Pai-88/crank-charger/video/COMMENTARY.md

# Commentary for the showcase cut (31 s: act 1 is 19 s, act 2 is 12 s)

Paste the lines into Higgsfield (Speak, or its voice-over tool) one at a time, or all seven as one
take, and drop the audio on A1 in Resolve. The times are where each line should START on the
"Showcase 9x16" timeline (act 1 `crank_9x16.mp4`, then act 2 `crank_elec9x16.mp4` from 19.0 s).
Everything spoken here is a design fact. No power, speed or "it works" number goes in until it has
been measured on the real machine (that is the 25 Oct film).

| start | what is on screen | line |
|---|---|---|
| 0.0 s | the machine turning, camera circling | A hand crank phone charger. Every plastic part is printed, the gearbox in one piece. |
| 7.5 s | parts fly apart | Inside: a planetary stage. Seventeen, thirty-seven and ninety-one teeth, five point three to one. |
| 12.0 s | exploded, camera circling | Three planets on steel pins, one sun on the motor shaft. The motor is a stepper, run backwards as a generator. |
| 19.0 s | the card floats out behind the machine | Behind the wall: eight Schottky diodes in two bridges turn the stepper's output into DC, and one capacitor smooths it. |
| 23.5 s | the module and the USB tester in their sled | A buck converter brings it down to USB five volts, with a plug-in meter to show what the phone gets. |
| 27.5 s | cover on, phone charging | Cover on, phone on. Turn the wheel. |

Word count 93: about 3.0 words a second, a calm narrator's pace. If the voice runs long, cut the
third line to "Three planets, one sun, a stepper run backwards as a generator." and the fourth to
"Behind the wall: eight Schottky diodes and one capacitor make DC."

## One take, plain text

A hand crank phone charger. Every plastic part is printed, the gearbox in one piece.
Inside: a planetary stage. Seventeen, thirty-seven and ninety-one teeth, five point three to one.
Three planets on steel pins, one sun on the motor shaft. The motor is a stepper, run backwards as a generator.
Behind the wall: eight Schottky diodes in two bridges turn the stepper's output into DC, and one capacitor smooths it.
A buck converter brings it down to USB five volts, with a plug-in meter to show what the phone gets.
Cover on, phone on. Turn the wheel.

## If the cut gets longer (real footage added in Resolve)

- Over the printed parts on the bench: "Eight parts, two days of printing on a P1S."
- Over the first crank test, ONLY after the meter has been read on camera: "<measured> volts at <measured> turns a minute."
- Over the phone: "The converter turns that into USB five volts."

## Not to say

- Any watts, volts or rpm figure that has not been read off the meter on camera.
- "Works", "charges in X minutes", "tested": not until the exit test on 25 Oct passes.
