Pai-88/crank-charger/electronics/card_template.pdf

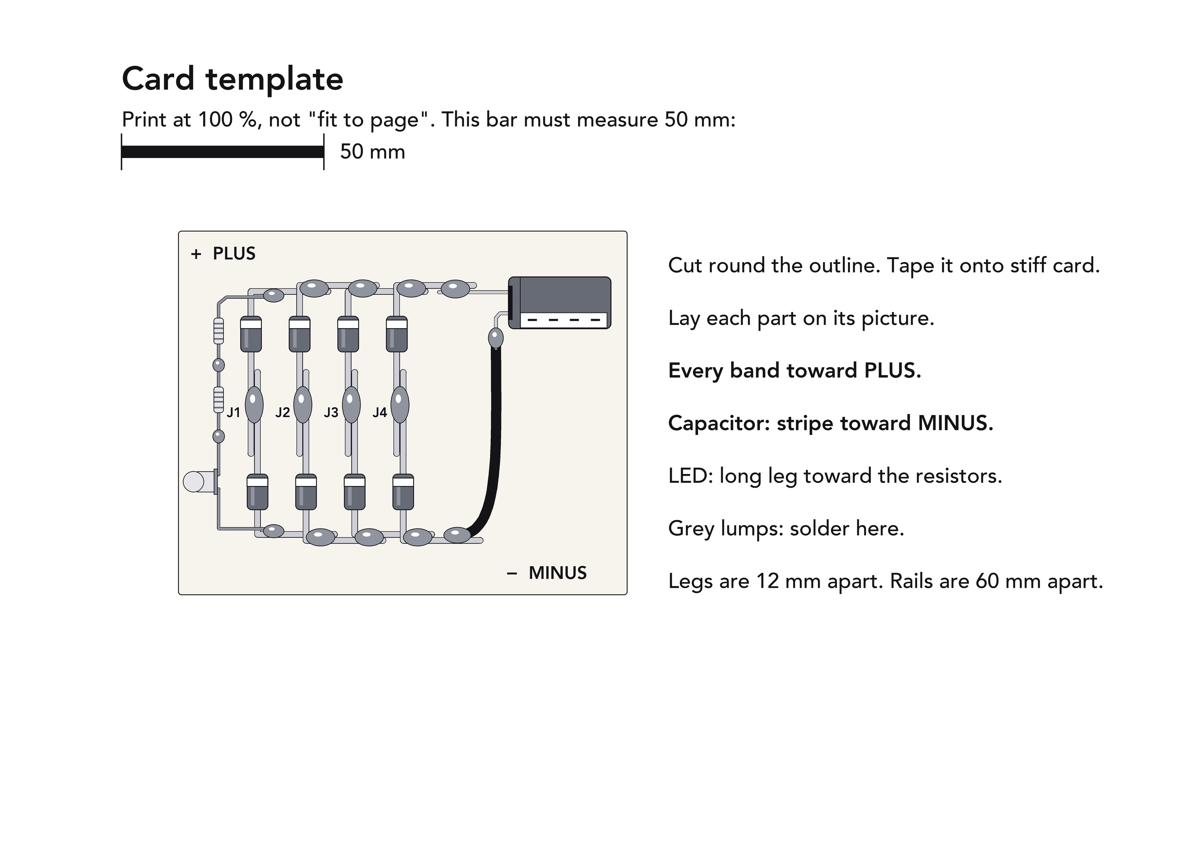
[picture p26: page 1]
