Pai-88/crank-charger/cad/preview_batch2.png

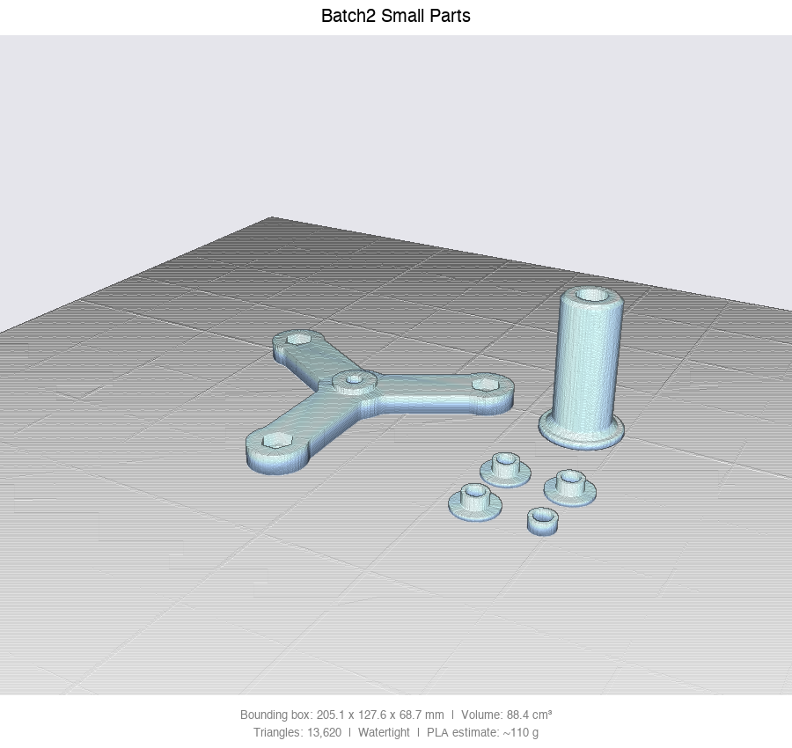
cad/preview_batch2.png
