Pai-88/crank-charger/cad/preview_coupon.png

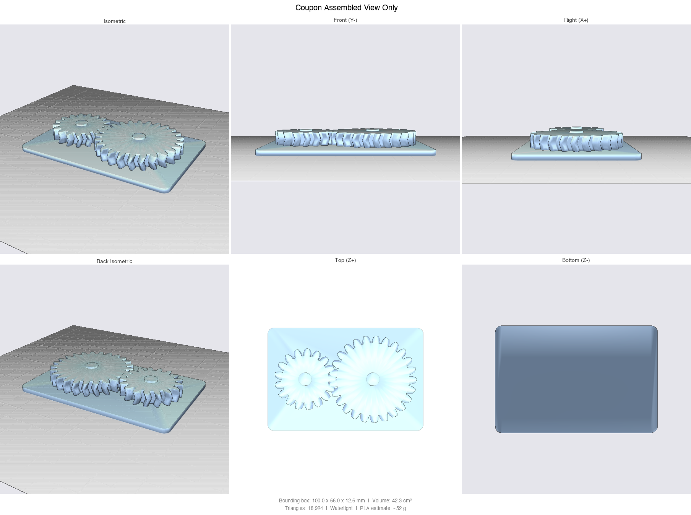
cad/preview_coupon.png
