Pai-88/crank-charger/cad/preview_frame.png

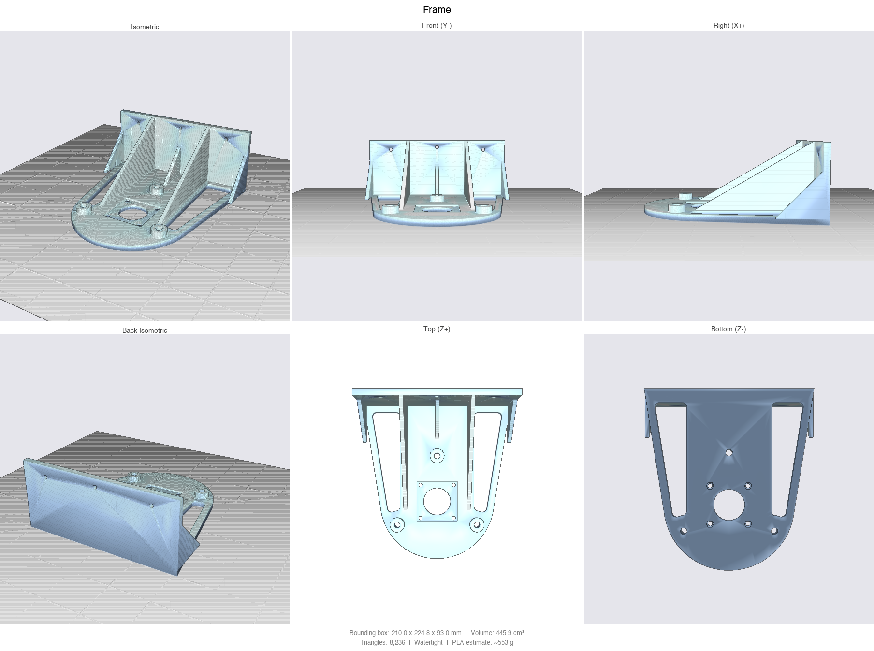
cad/preview_frame.png
