Pai-88/crank-charger/cad/preview_grip.png

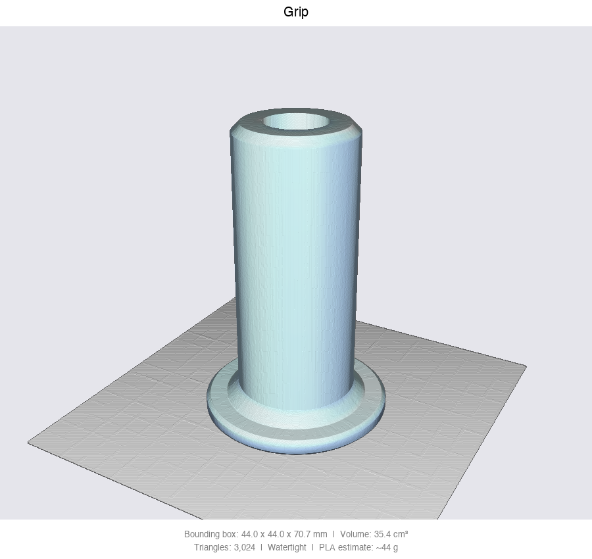
cad/preview_grip.png
