Pai-88/crank-charger/cad/preview_inner.png

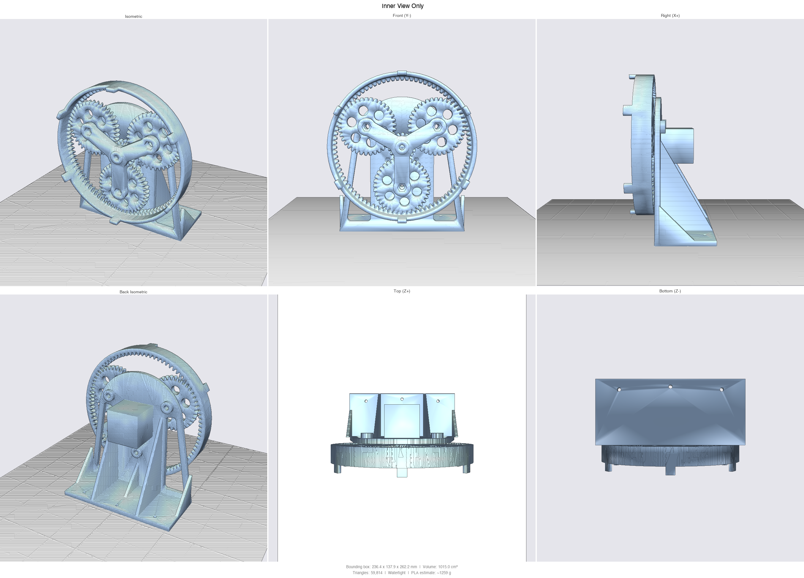
cad/preview_inner.png
