Pai-88/crank-charger/cad/preview_plate1.png

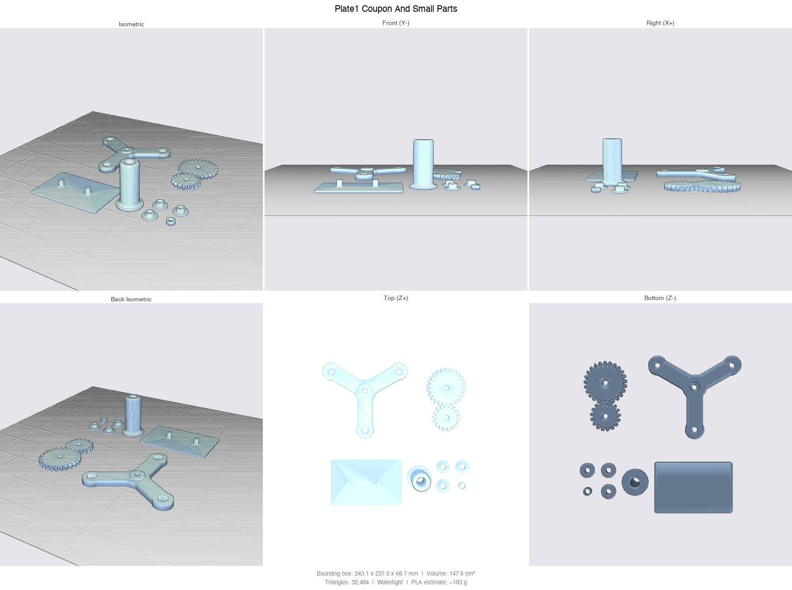
cad/preview_plate1.png
