Pai-88/crank-charger/cad/stl/spares/bayonet_1.png

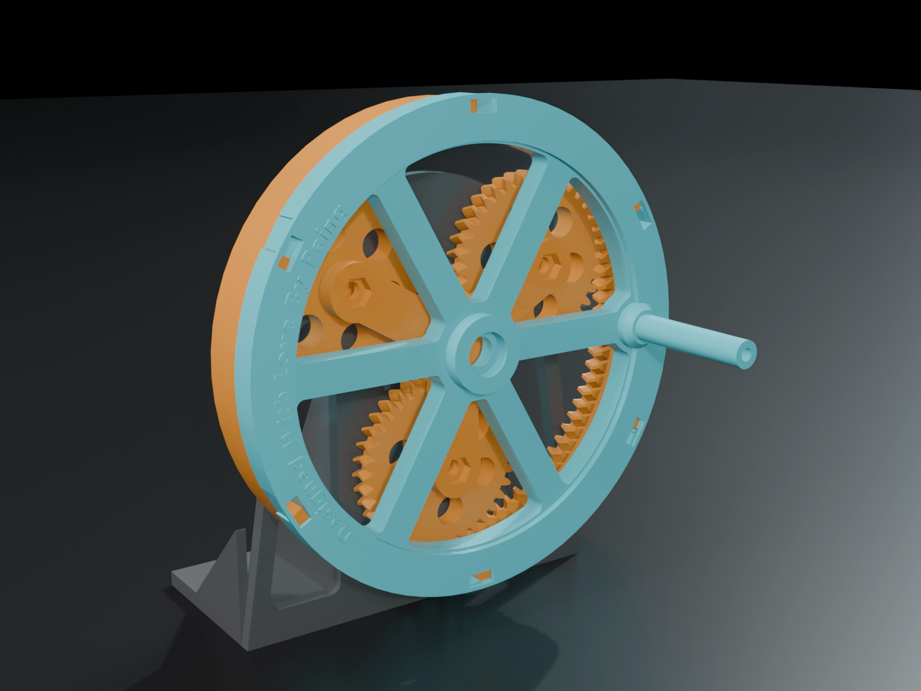
cad/stl/spares/bayonet_1.png
