Pai-88/crank-charger/cad/stl/spares/bayonet_2.png

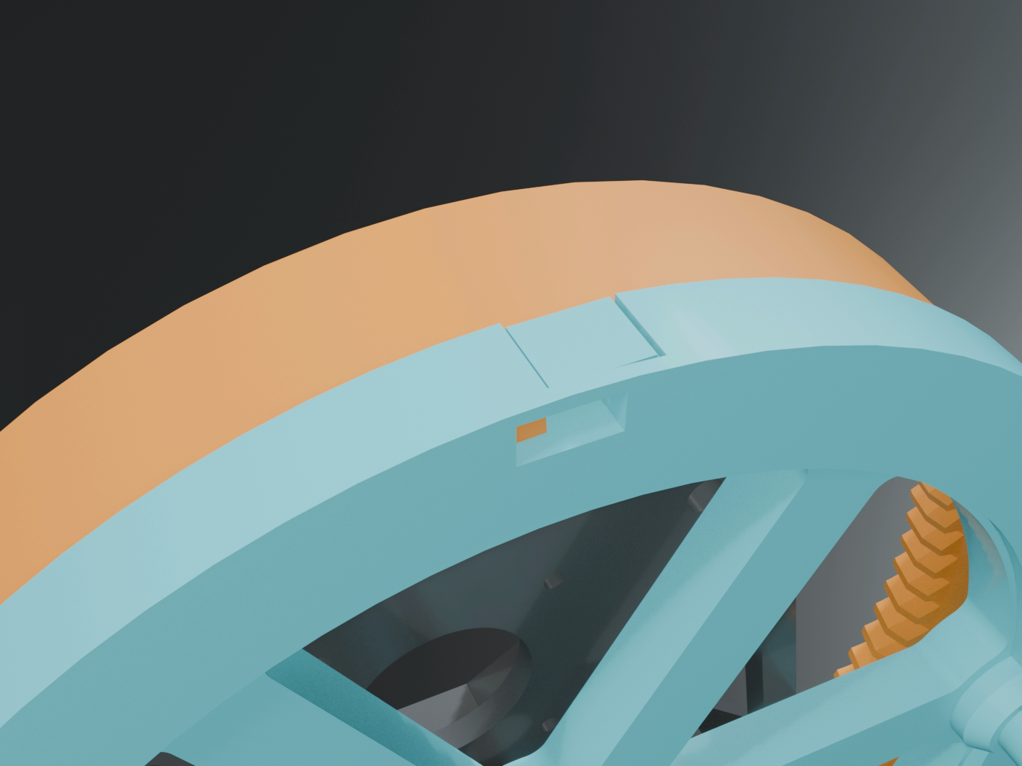
cad/stl/spares/bayonet_2.png
