Pai-88/crank-charger/cad/stl/spares/bayonet_3.png

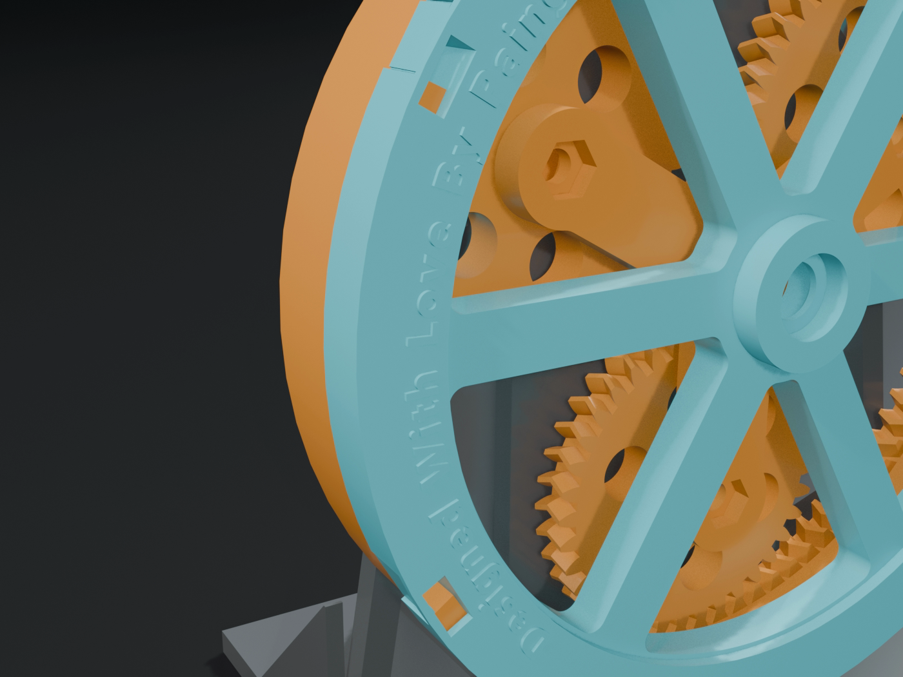
cad/stl/spares/bayonet_3.png
