Pai-88/crank-charger/cad/stl/spares/click_1.png

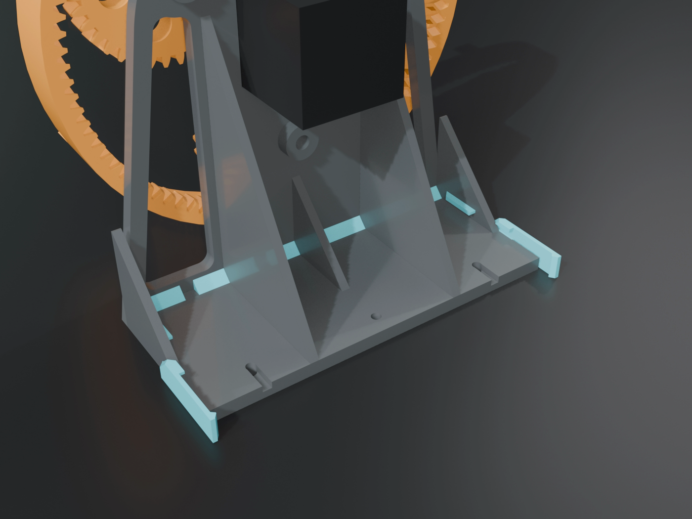
cad/stl/spares/click_1.png
