Pai-88/crank-charger/cad/stl/spares/click_2.png

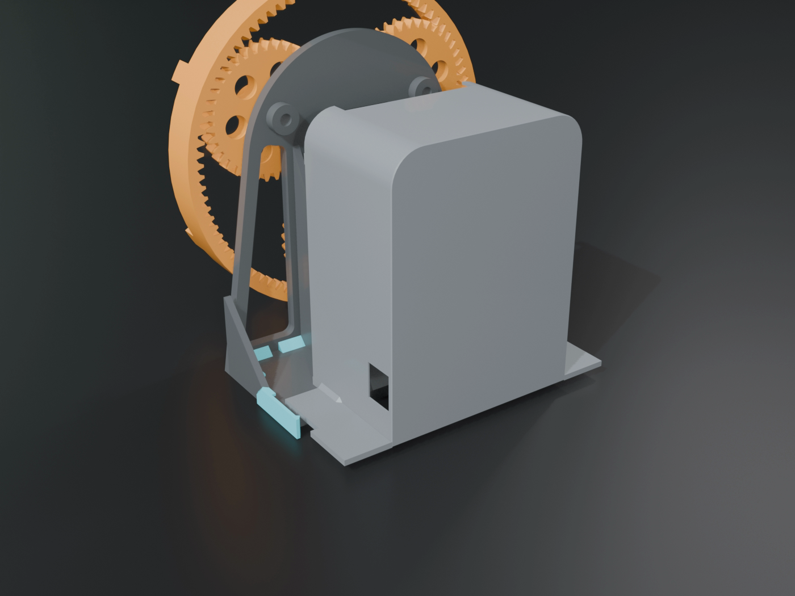
cad/stl/spares/click_2.png
