Pai-88/crank-charger/cad/stl/spares/click_3.png

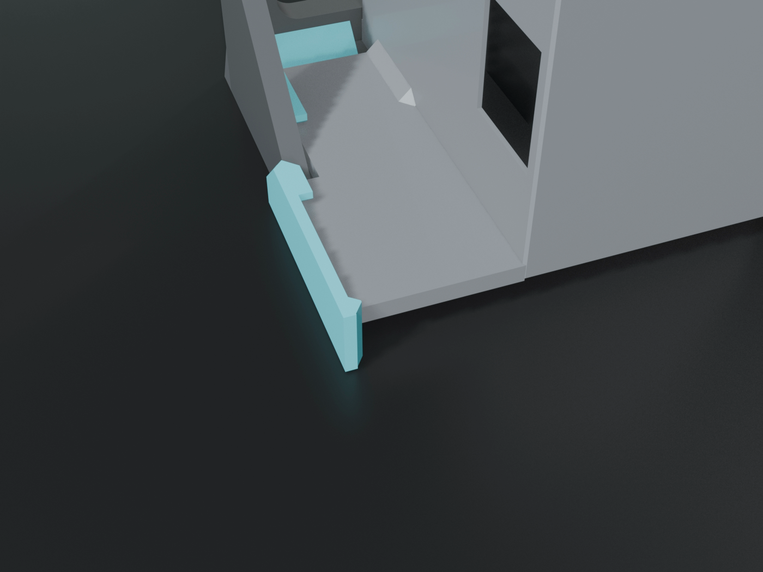
cad/stl/spares/click_3.png
