Pai-88/crank-charger/cad/stl/spares/click_4.png

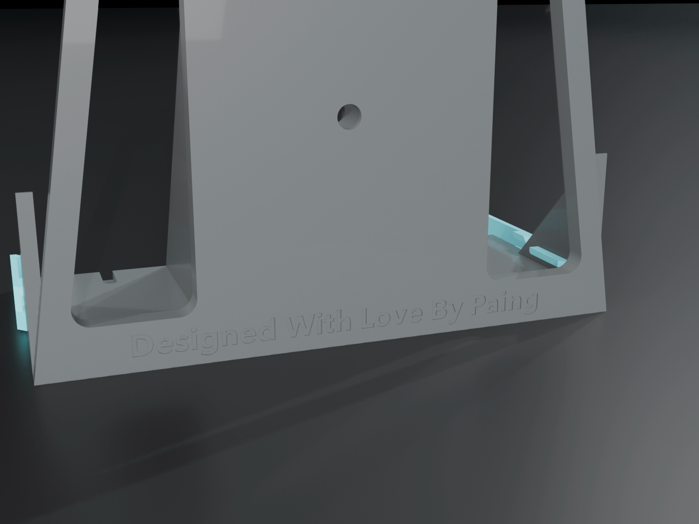
cad/stl/spares/click_4.png
