Pai-88/crank-charger/cad/stl/spares/keeper_page.png

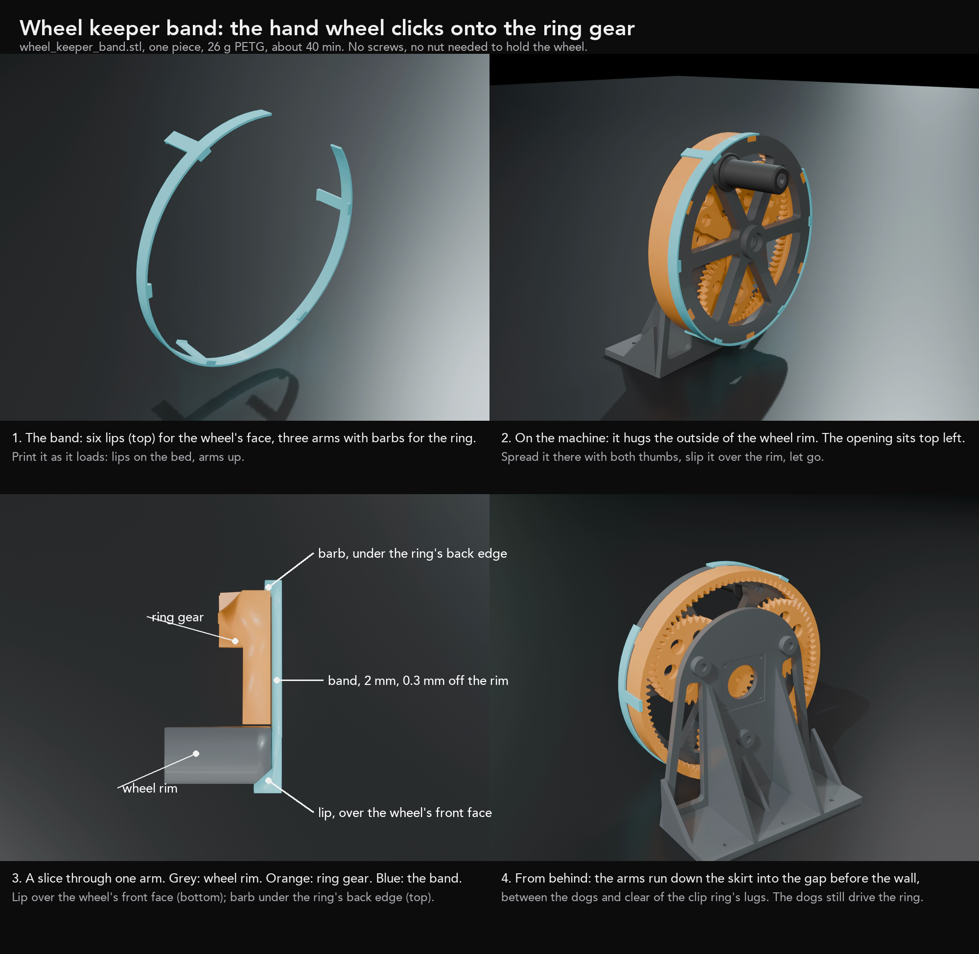
cad/stl/spares/keeper_page.png
