Pai-88/crank-charger/electronics/wire_01.png

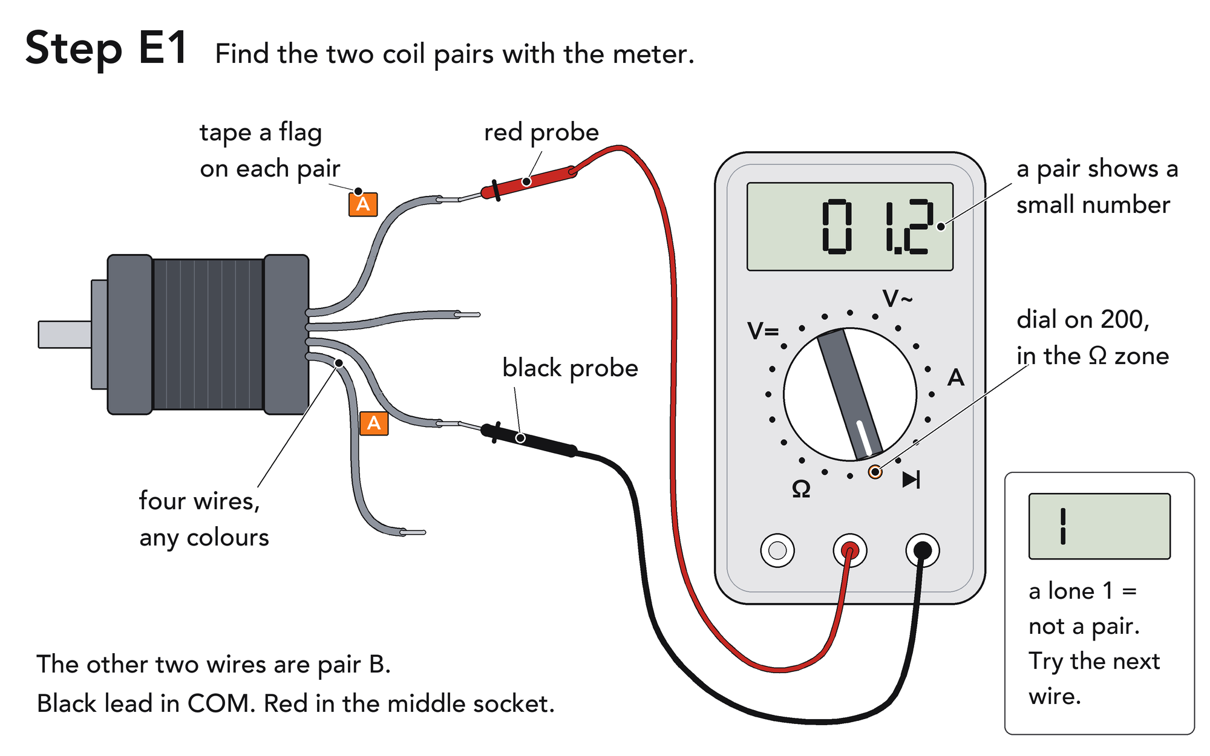
electronics/wire_01.png
