Pai-88/crank-charger/electronics/wire_02.png

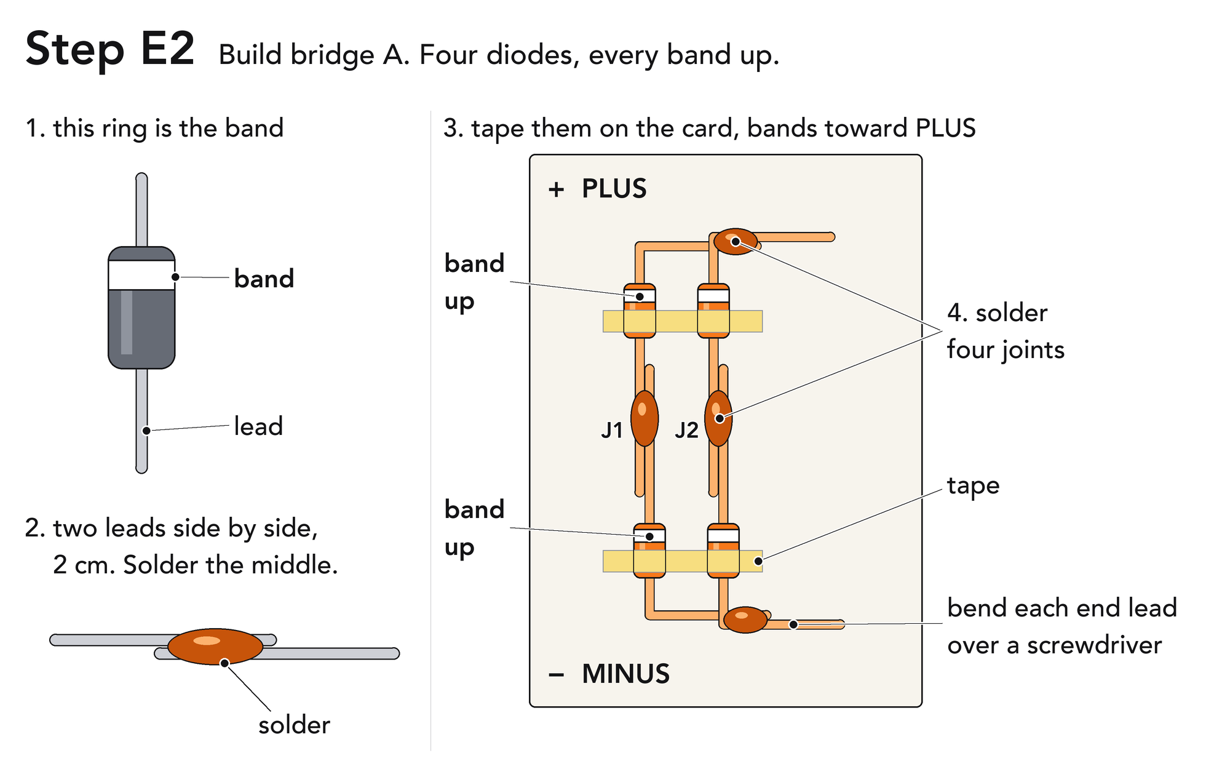
electronics/wire_02.png
