Pai-88/crank-charger/electronics/wire_03.png

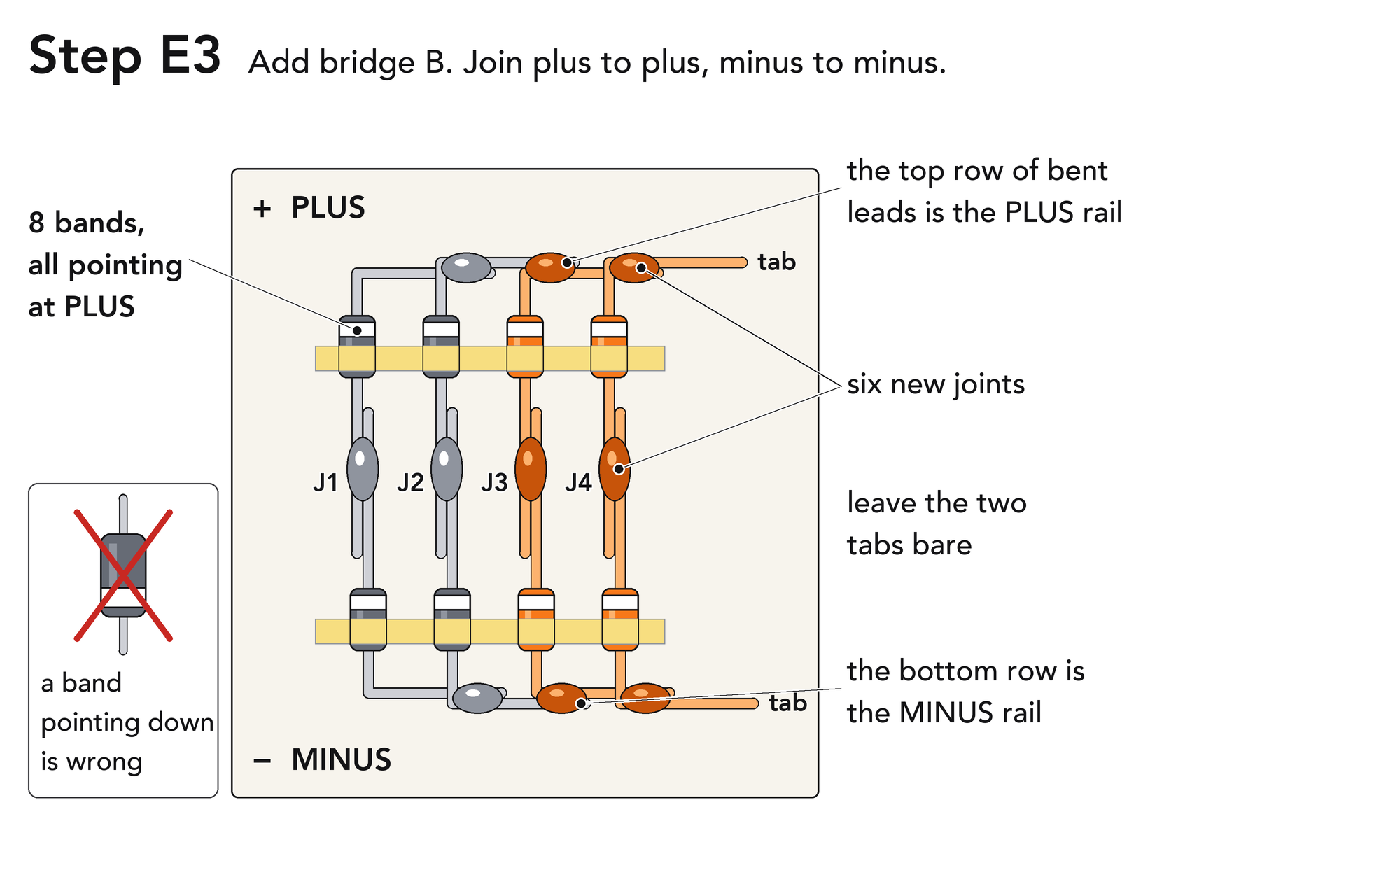
electronics/wire_03.png
