Pai-88/crank-charger/electronics/wire_04.png

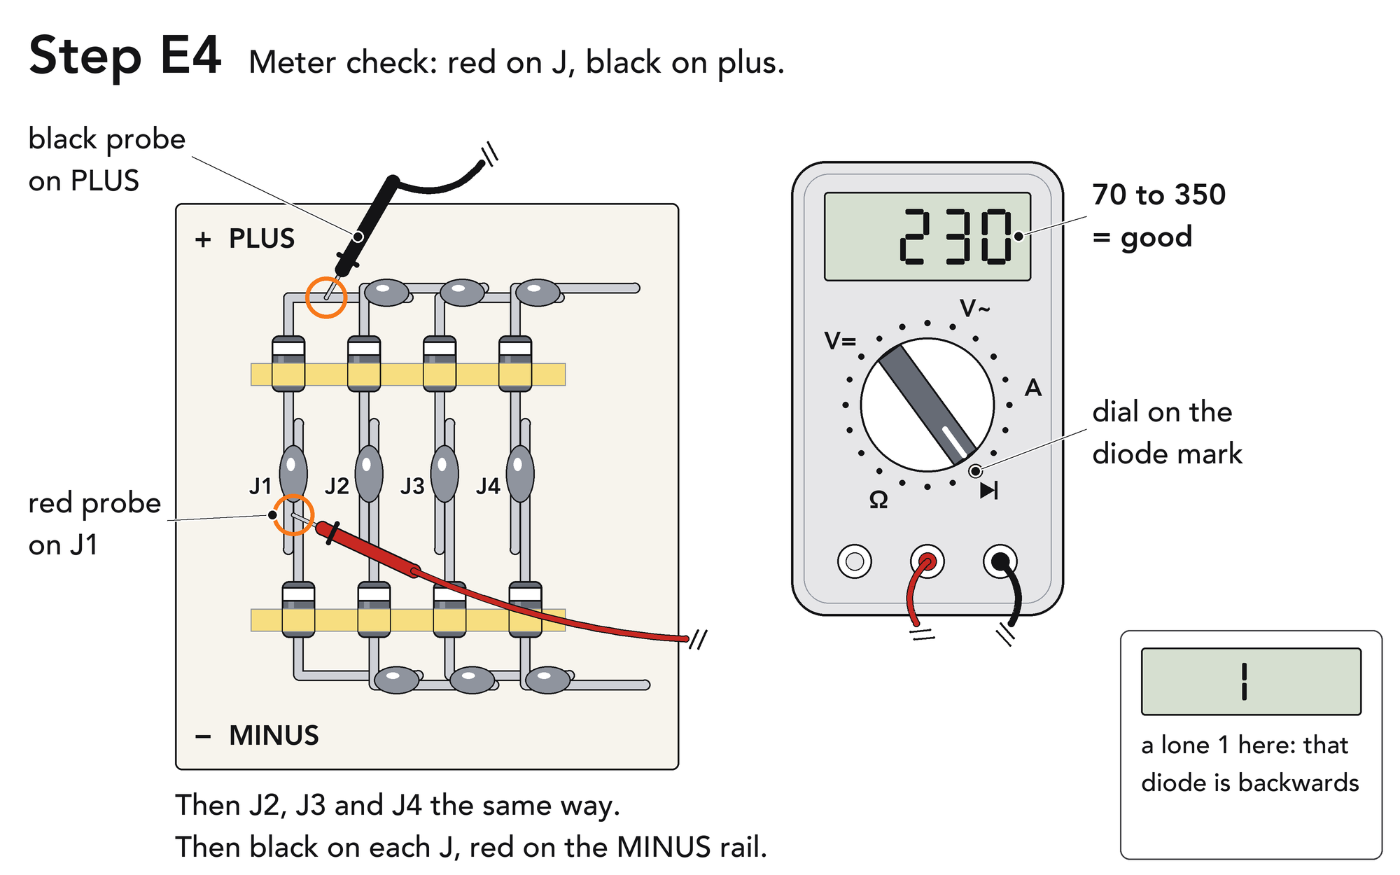
electronics/wire_04.png
