Pai-88/crank-charger/electronics/wire_05.png

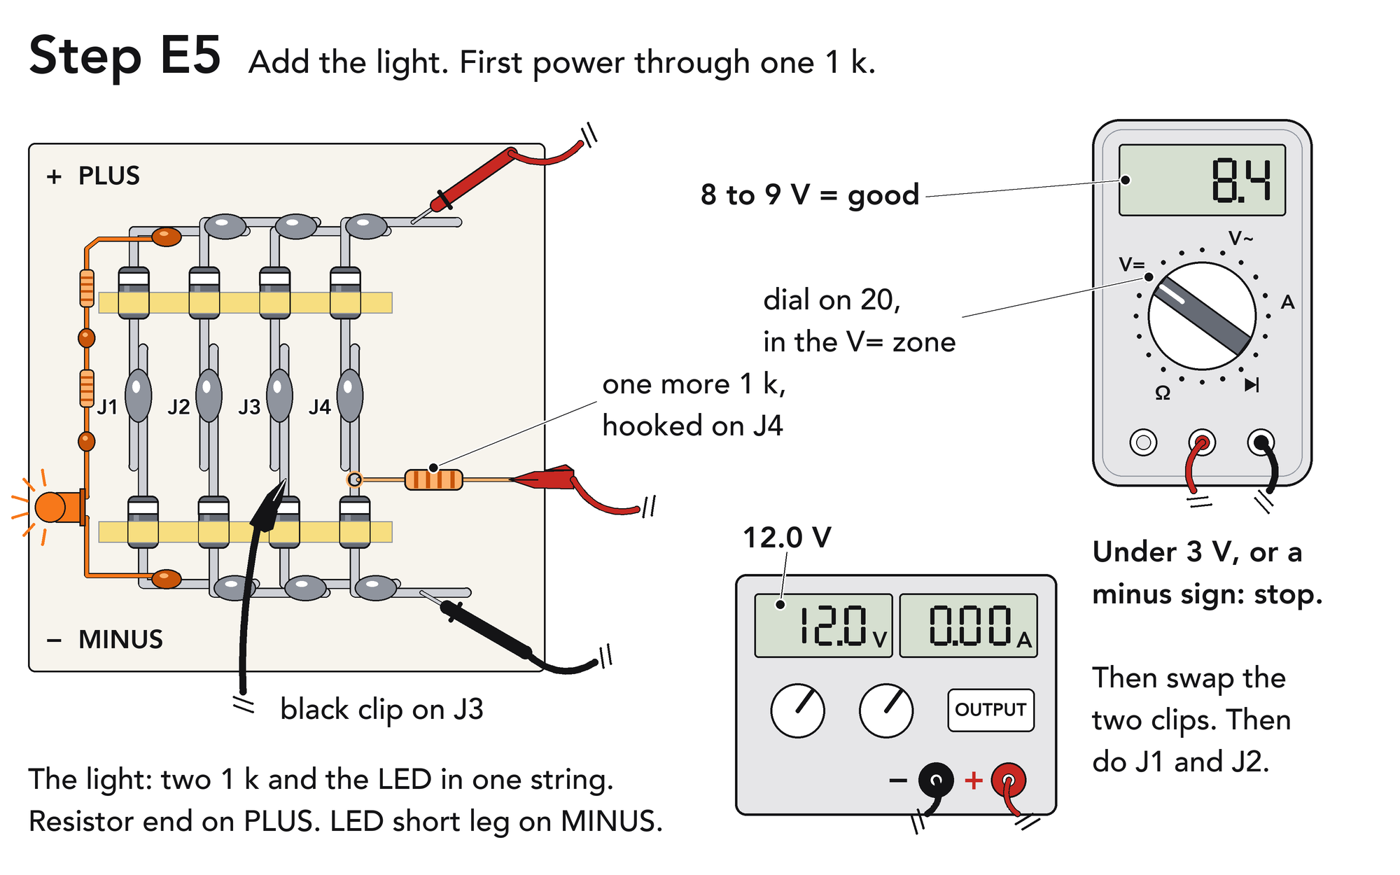
electronics/wire_05.png
