Pai-88/crank-charger/electronics/wire_06.png

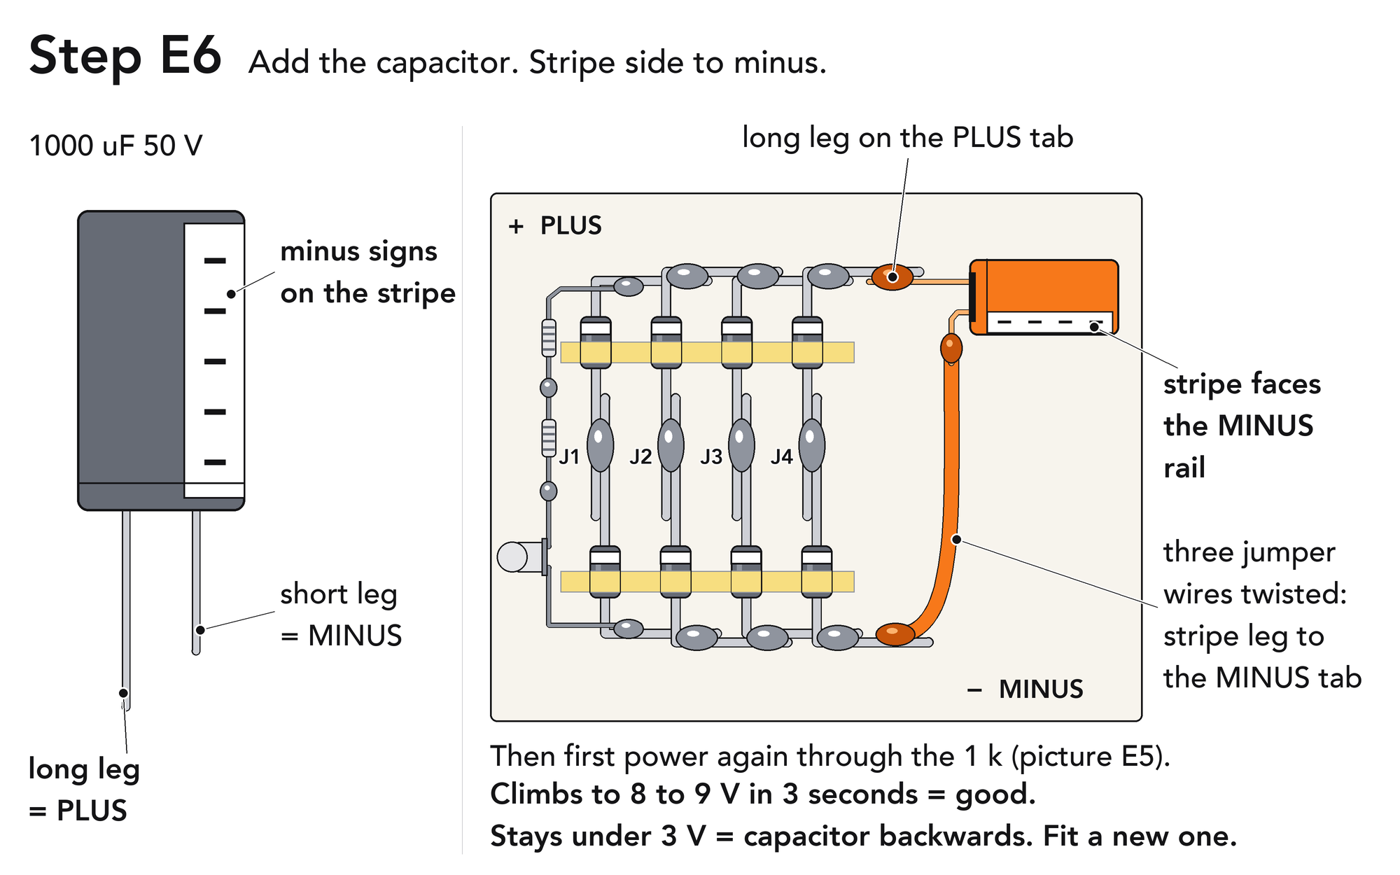
electronics/wire_06.png
