Pai-88/crank-charger/electronics/wire_07.png

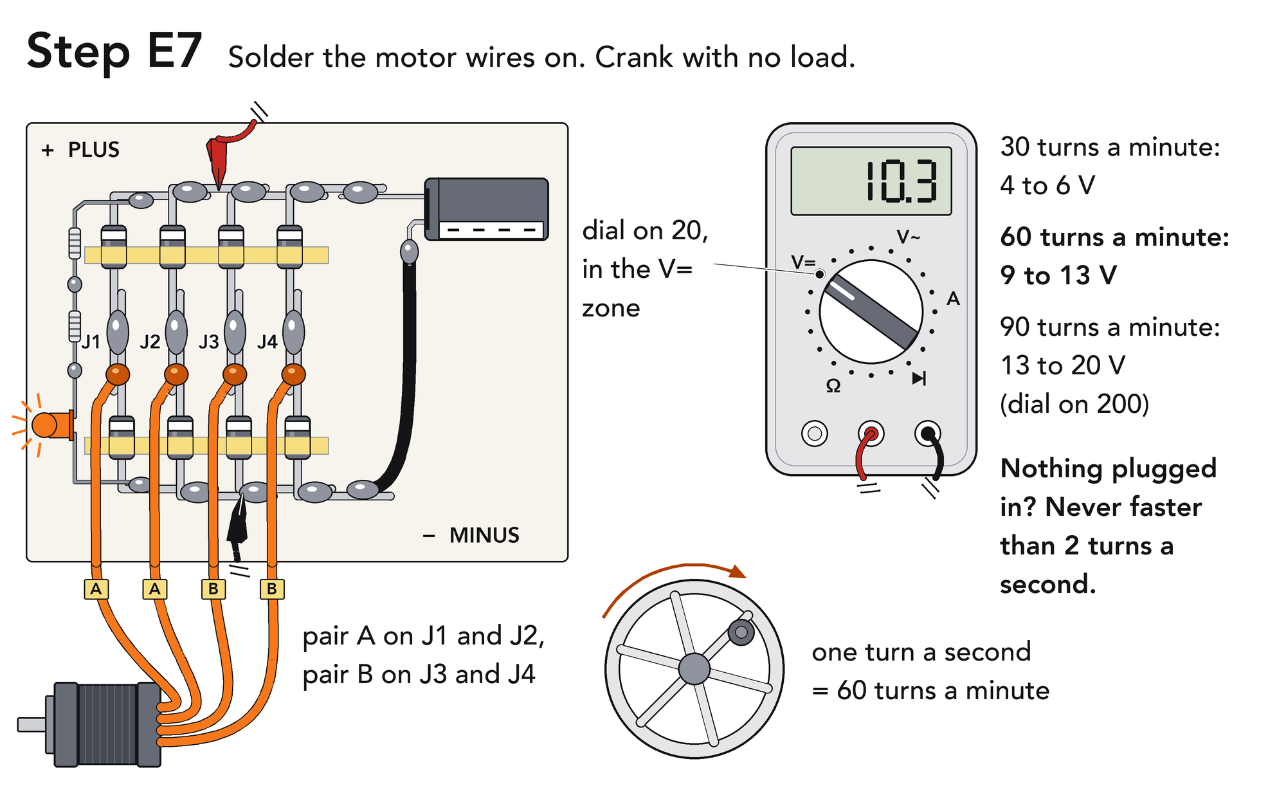
electronics/wire_07.png
