Pai-88/crank-charger/electronics/wire_08.png

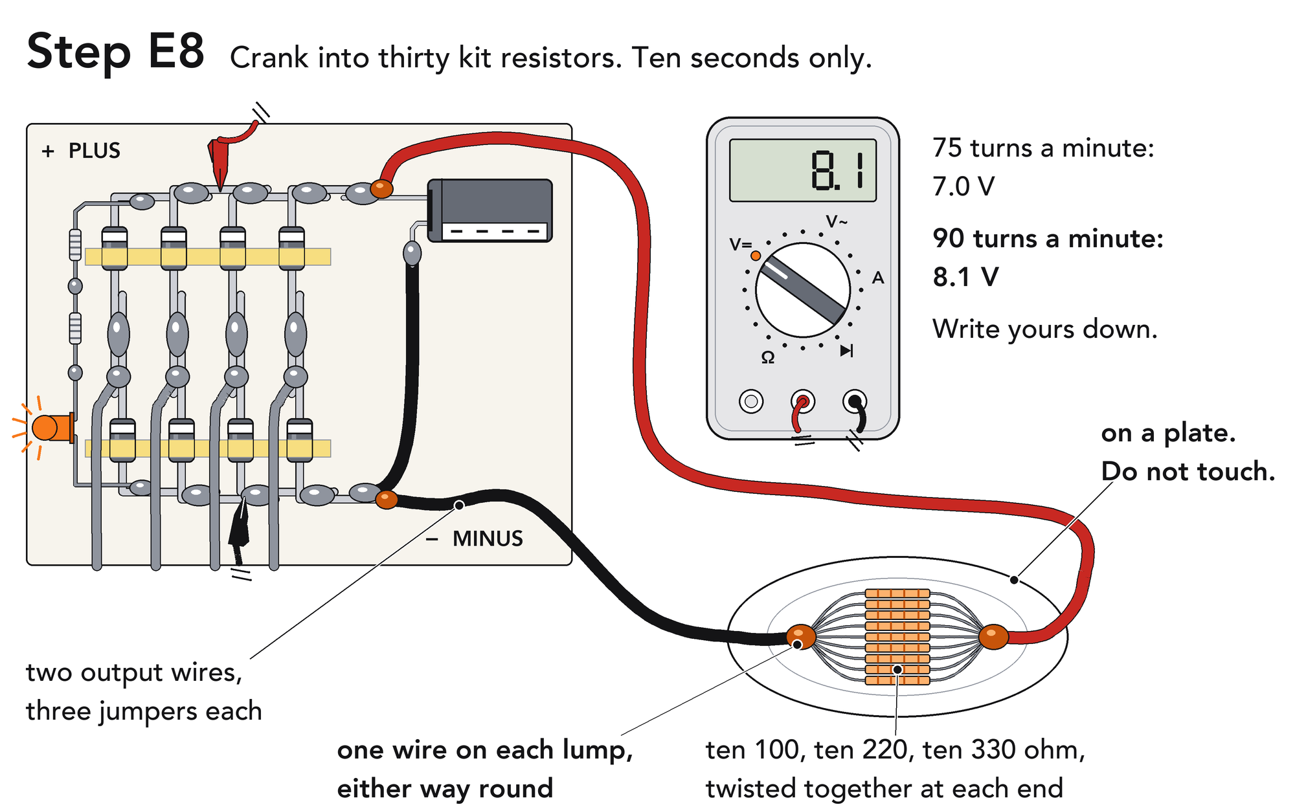
electronics/wire_08.png
