Pai-88/crank-charger/electronics/wire_09.png

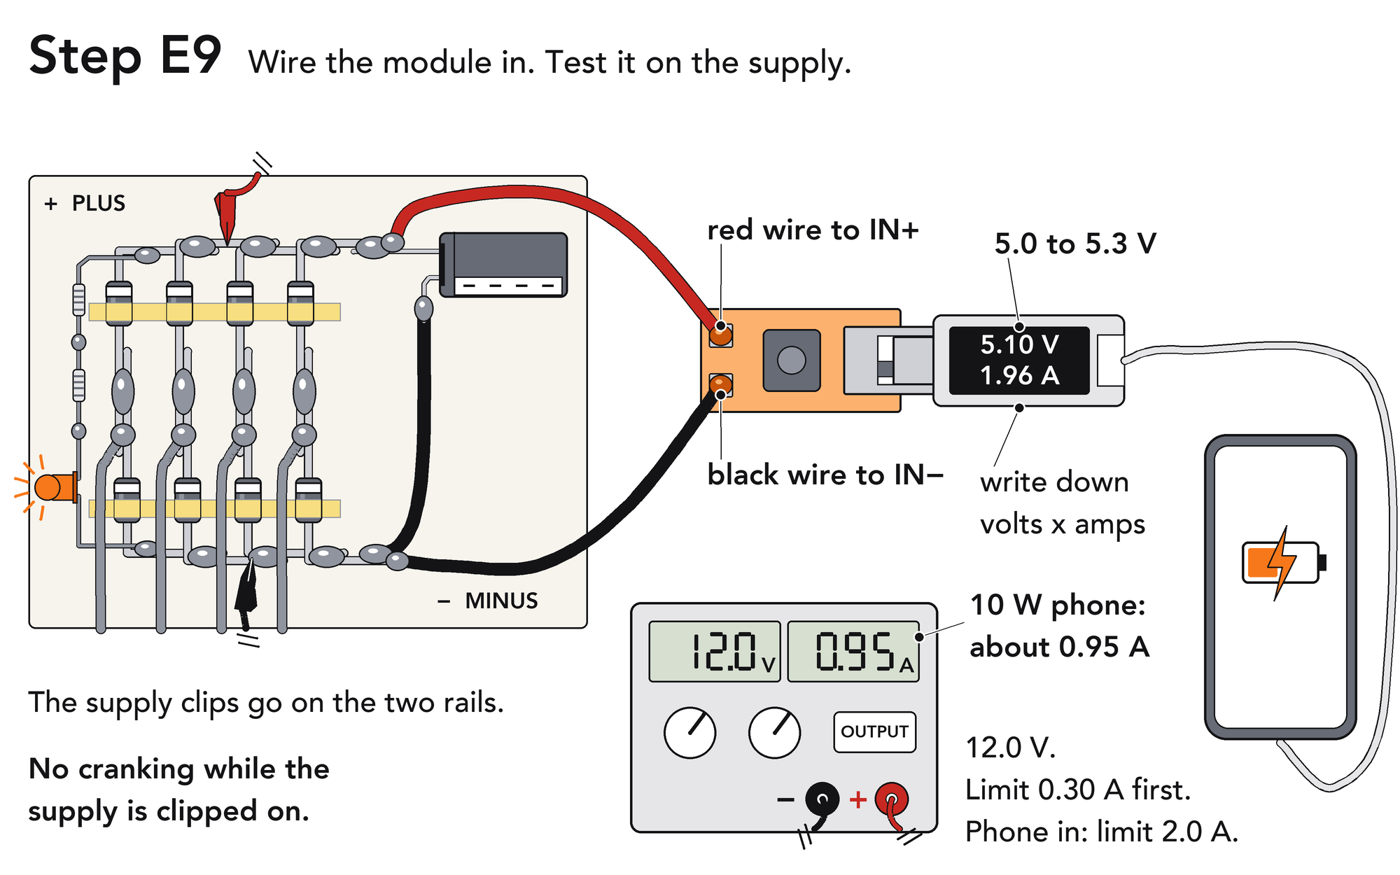
electronics/wire_09.png
