Pai-88/crank-charger/electronics/wire_10.png

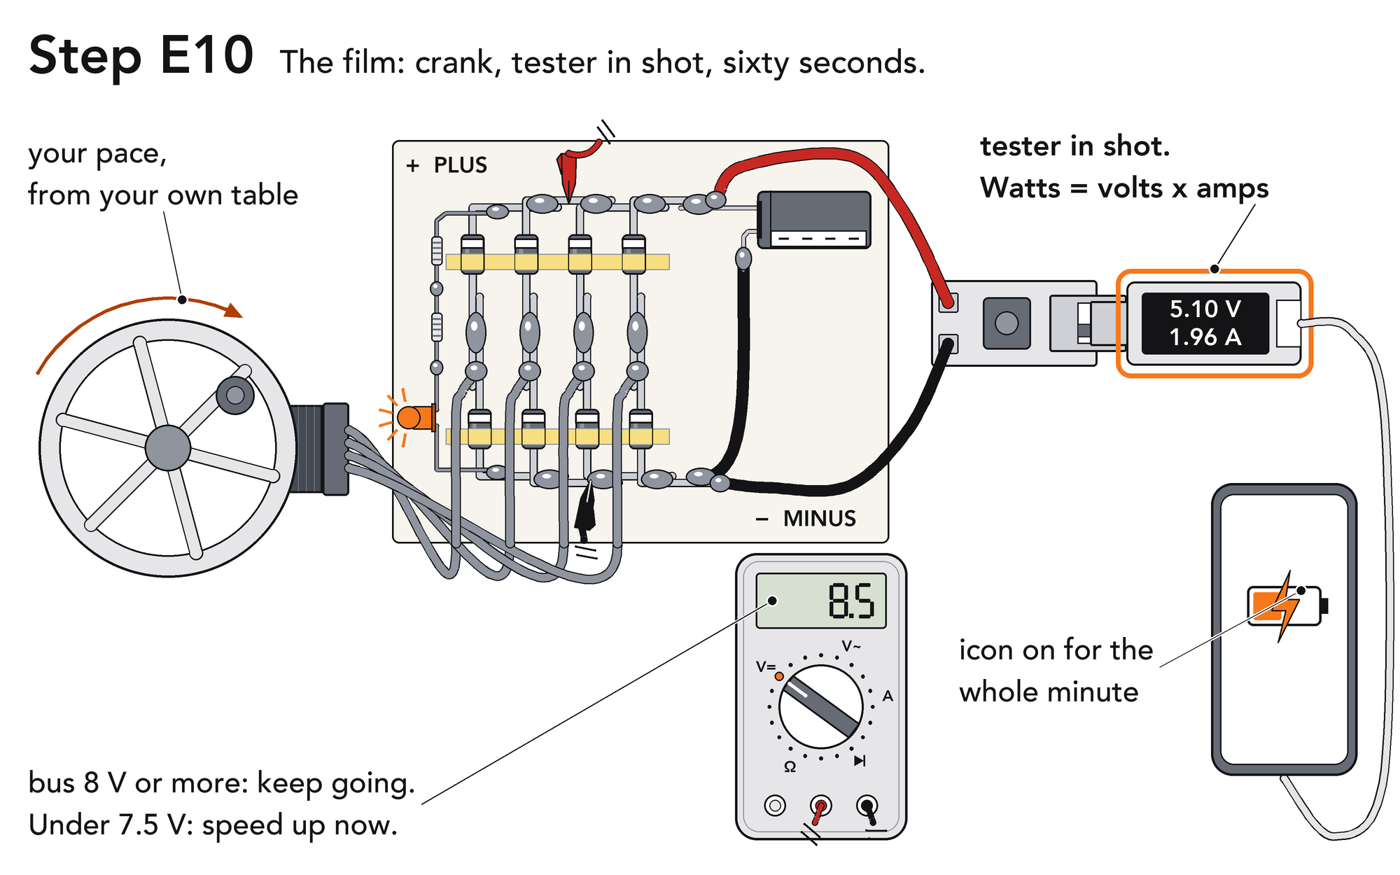
electronics/wire_10.png
