Pai-88/crank-charger/exploded/02_machine.png

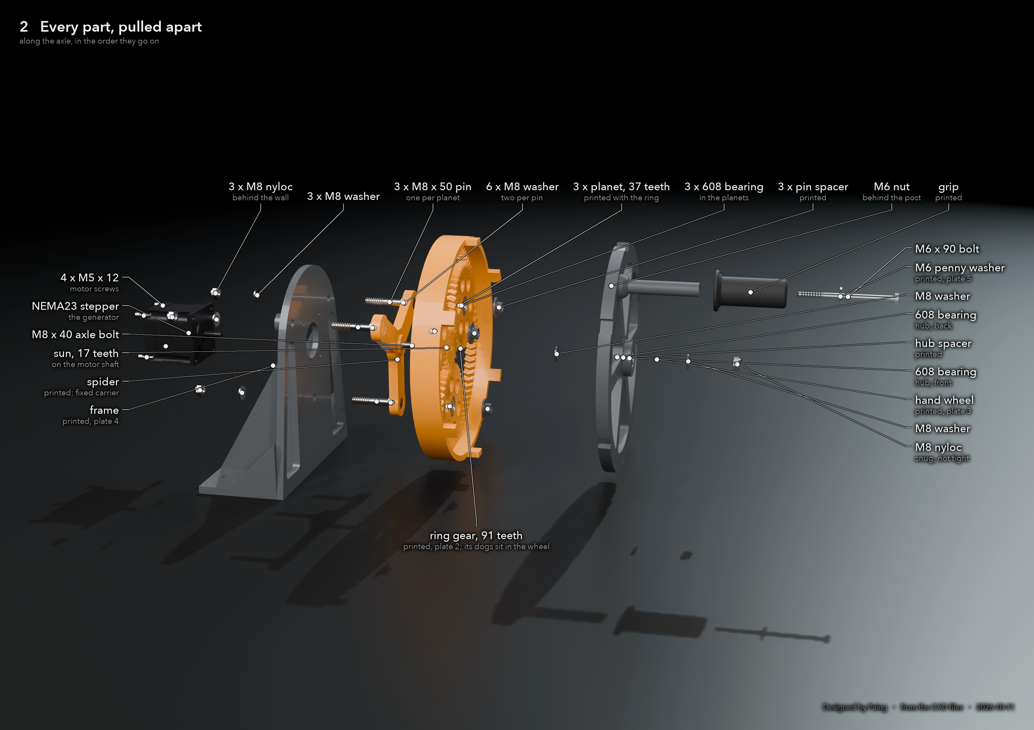
exploded/02_machine.png
