Pai-88/crank-charger/exploded/03_cartridge.png

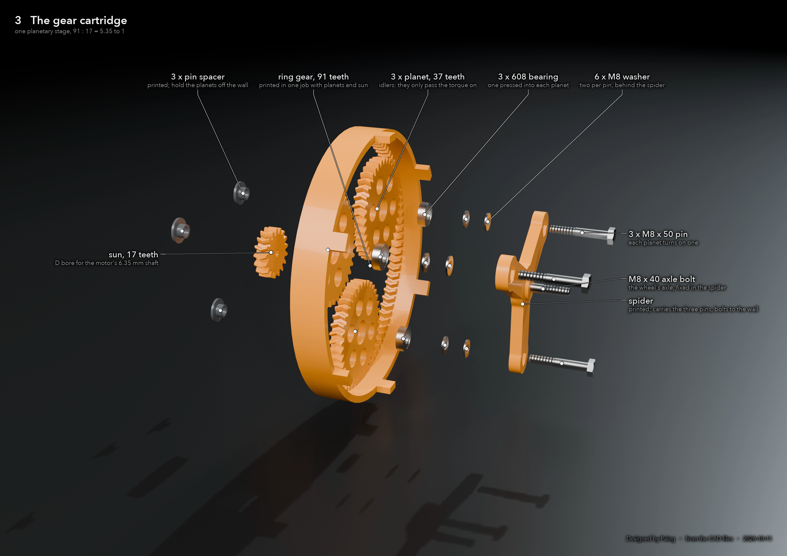
exploded/03_cartridge.png
