Pai-88/crank-charger/exploded/04_hub.png

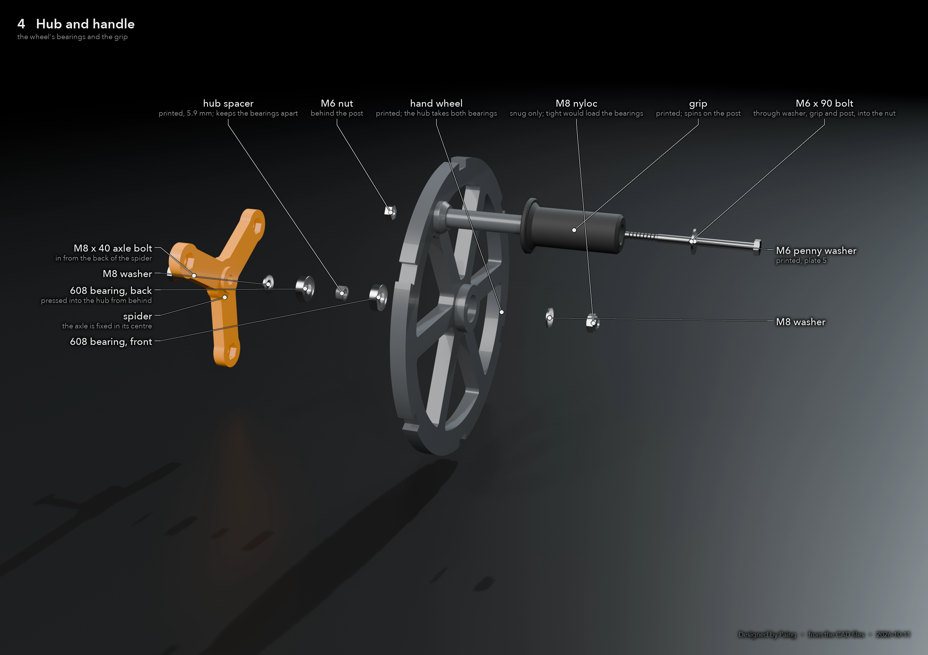
exploded/04_hub.png
