Pai-88/crank-charger/exploded/06_inside.png

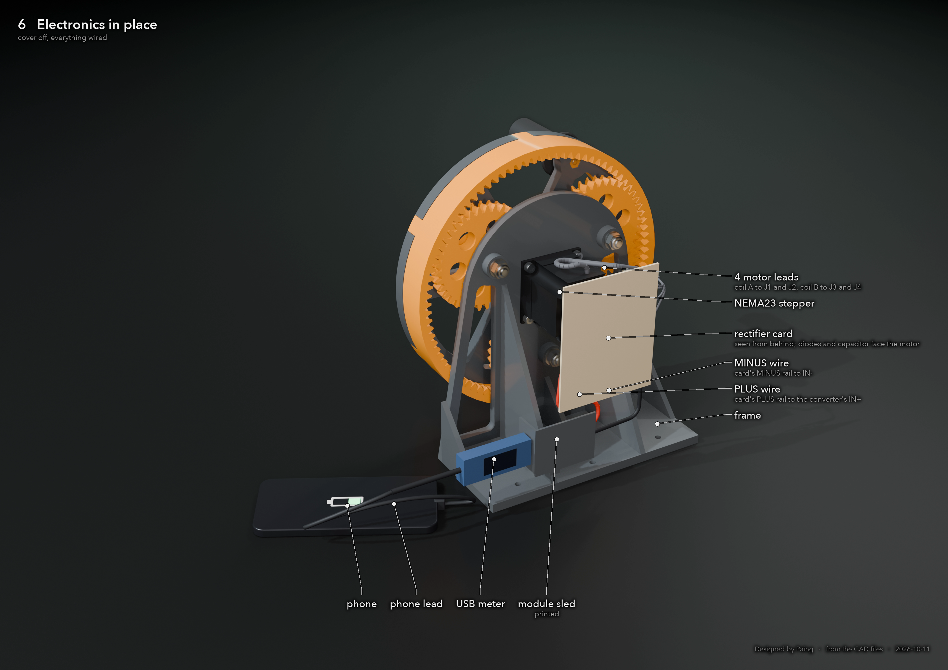
exploded/06_inside.png
