Pai-88/crank-charger/exploded/doc/06_inside.png

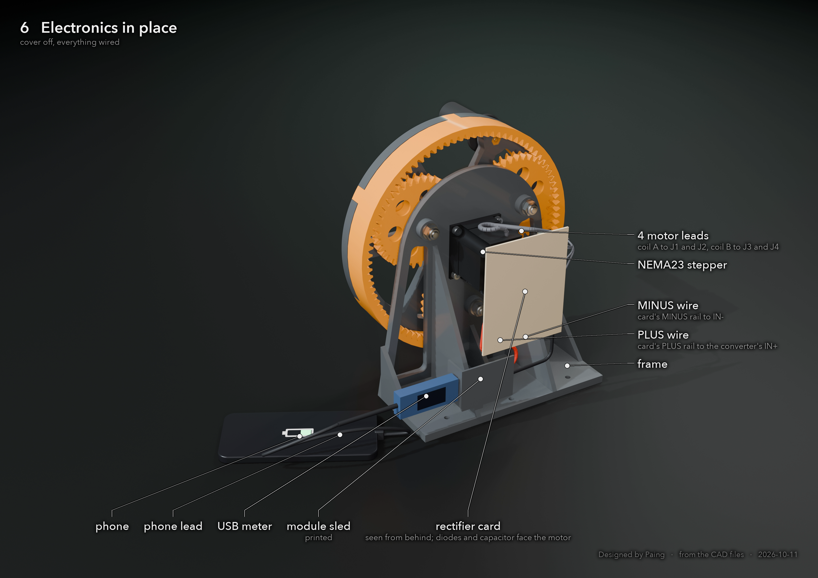
exploded/doc/06_inside.png
