Pai-88/crank-charger/exploded/web/cartridge.png

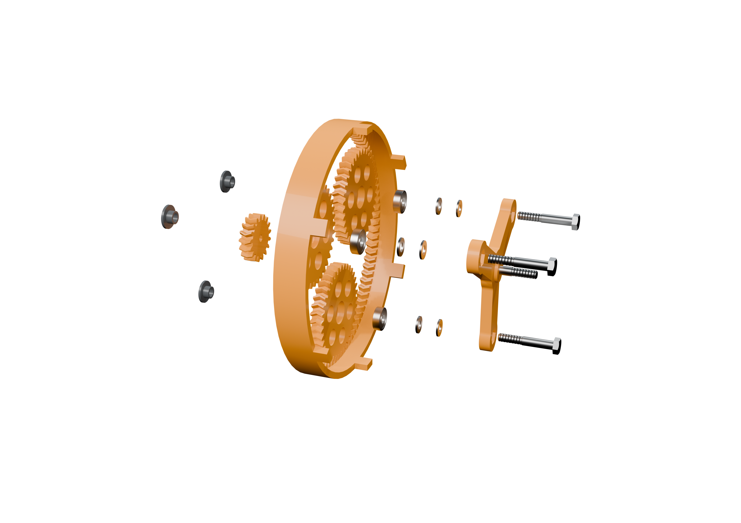
exploded/web/cartridge.png
