Pai-88/crank-charger/exploded/web/machine.png

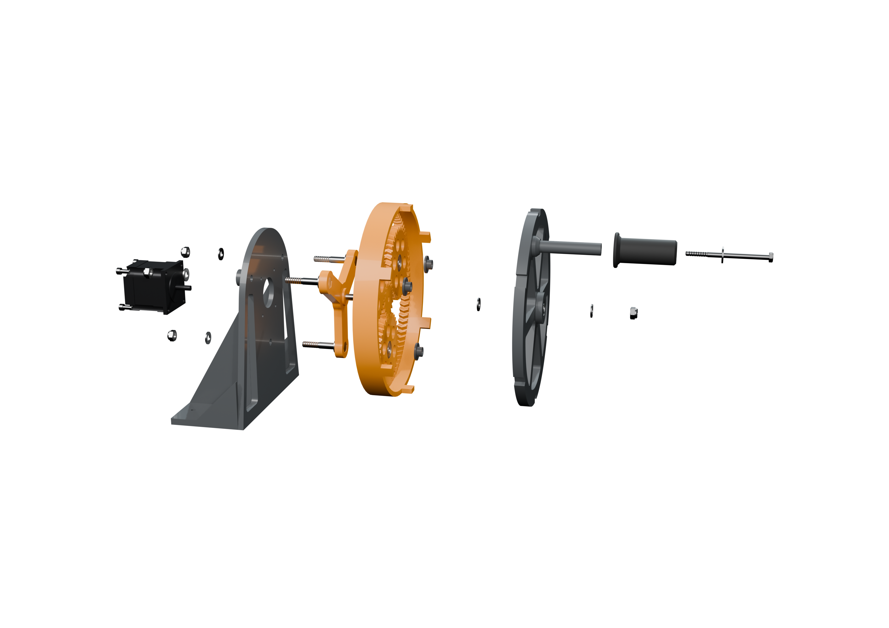
exploded/web/machine.png
