Pai-88/crank-charger/spares/phone/ring_0_phone.png

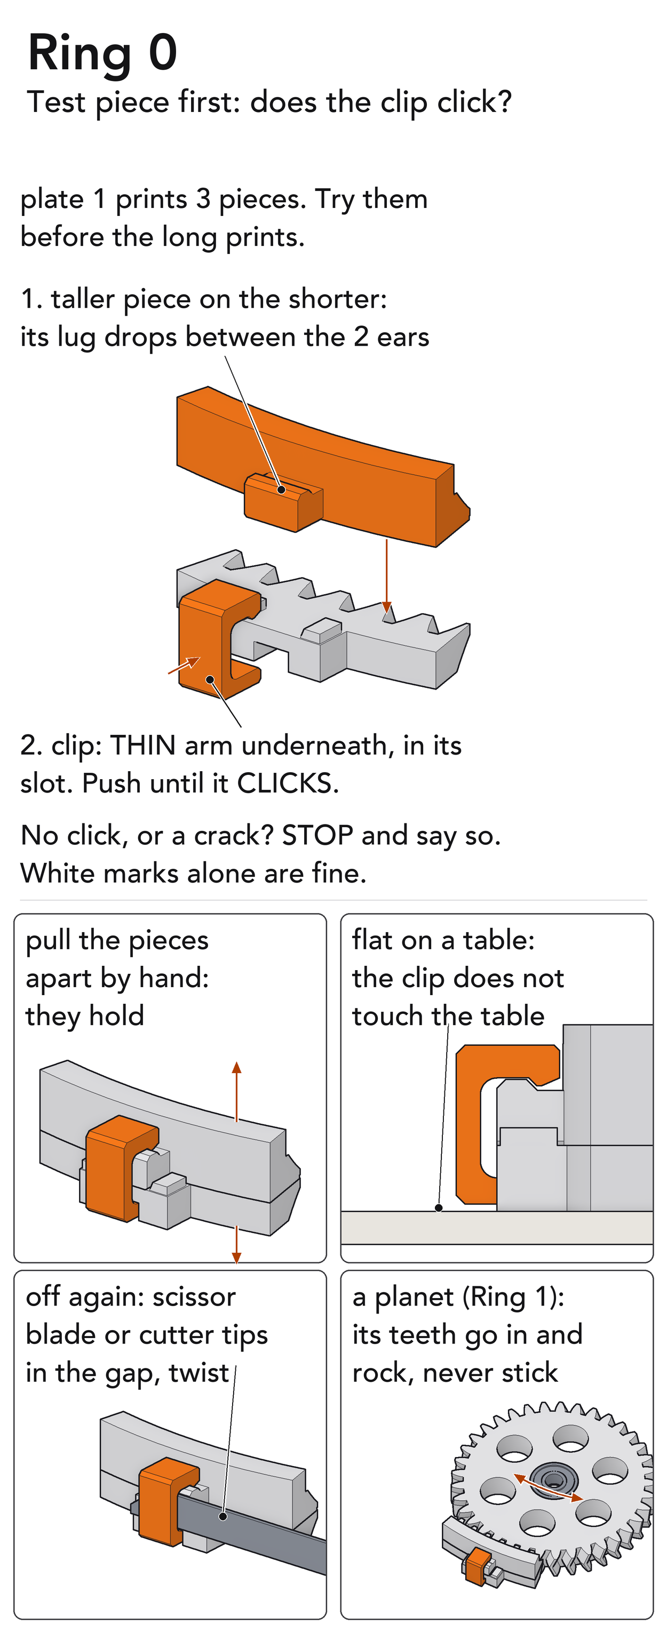
spares/phone/ring_0_phone.png
