Pai-88/crank-charger/spares/phone/ring_1_phone.png

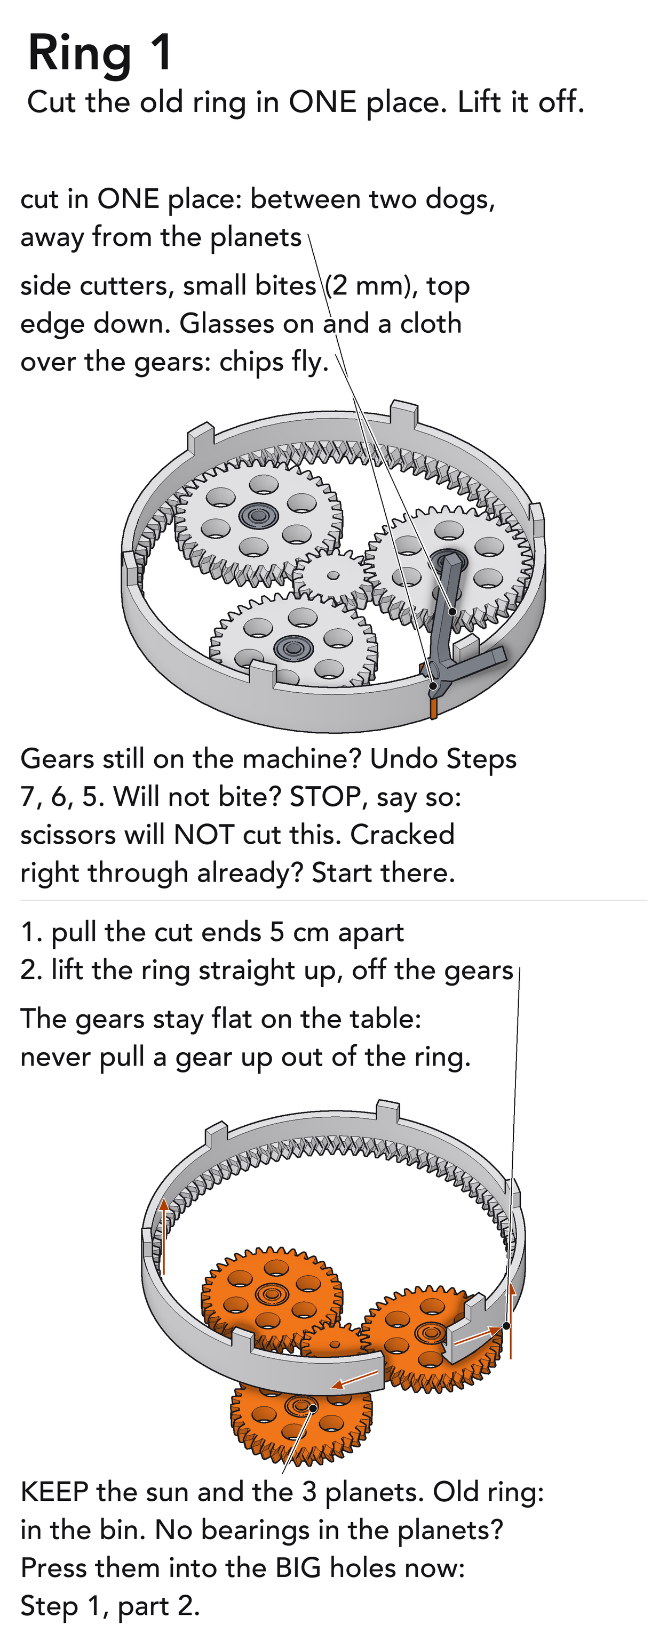
spares/phone/ring_1_phone.png
