Pai-88/crank-charger/spares/phone/ring_2_phone.png

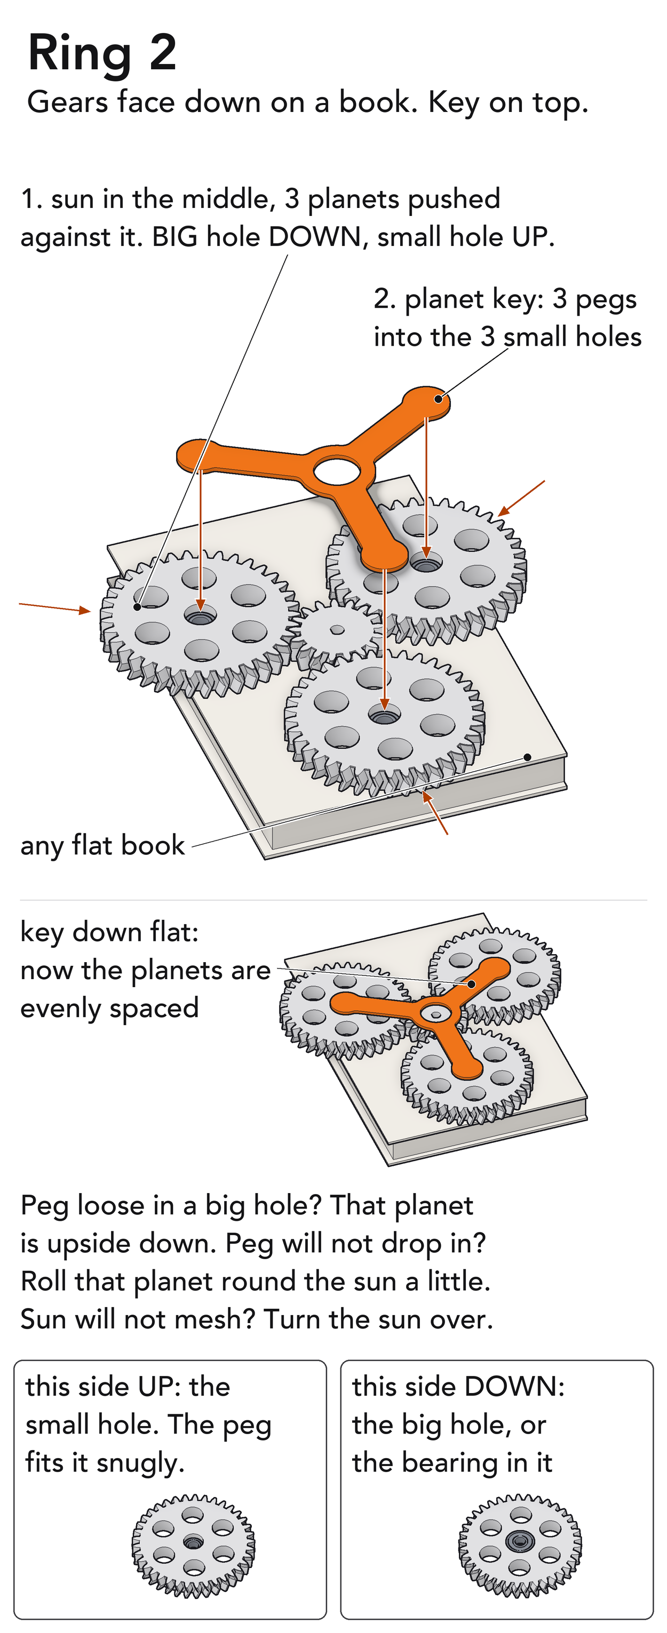
spares/phone/ring_2_phone.png
