Pai-88/crank-charger/spares/phone/ring_3_phone.png

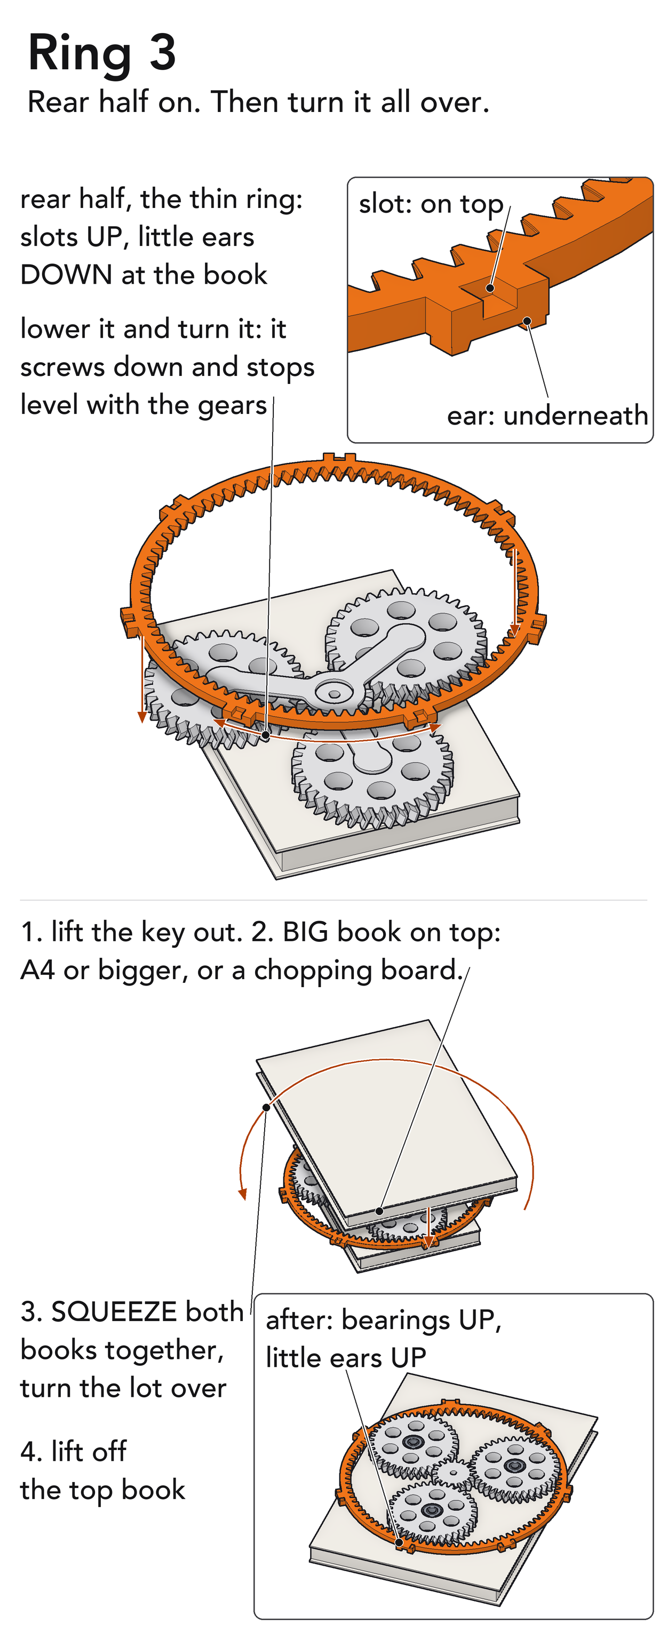
spares/phone/ring_3_phone.png
