Pai-88/crank-charger/spares/phone/ring_4_phone.png

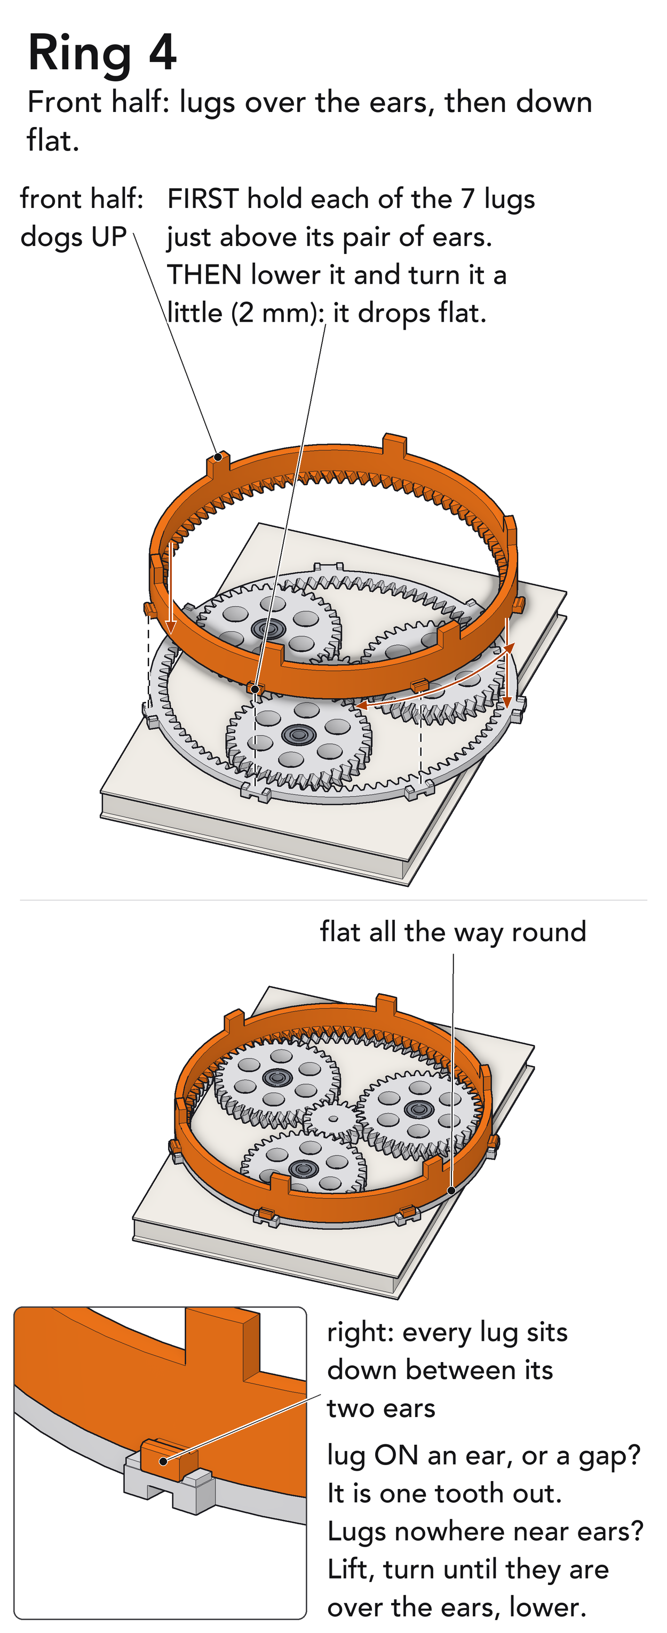
spares/phone/ring_4_phone.png
