Pai-88/crank-charger/spares/phone/ring_5_phone.png

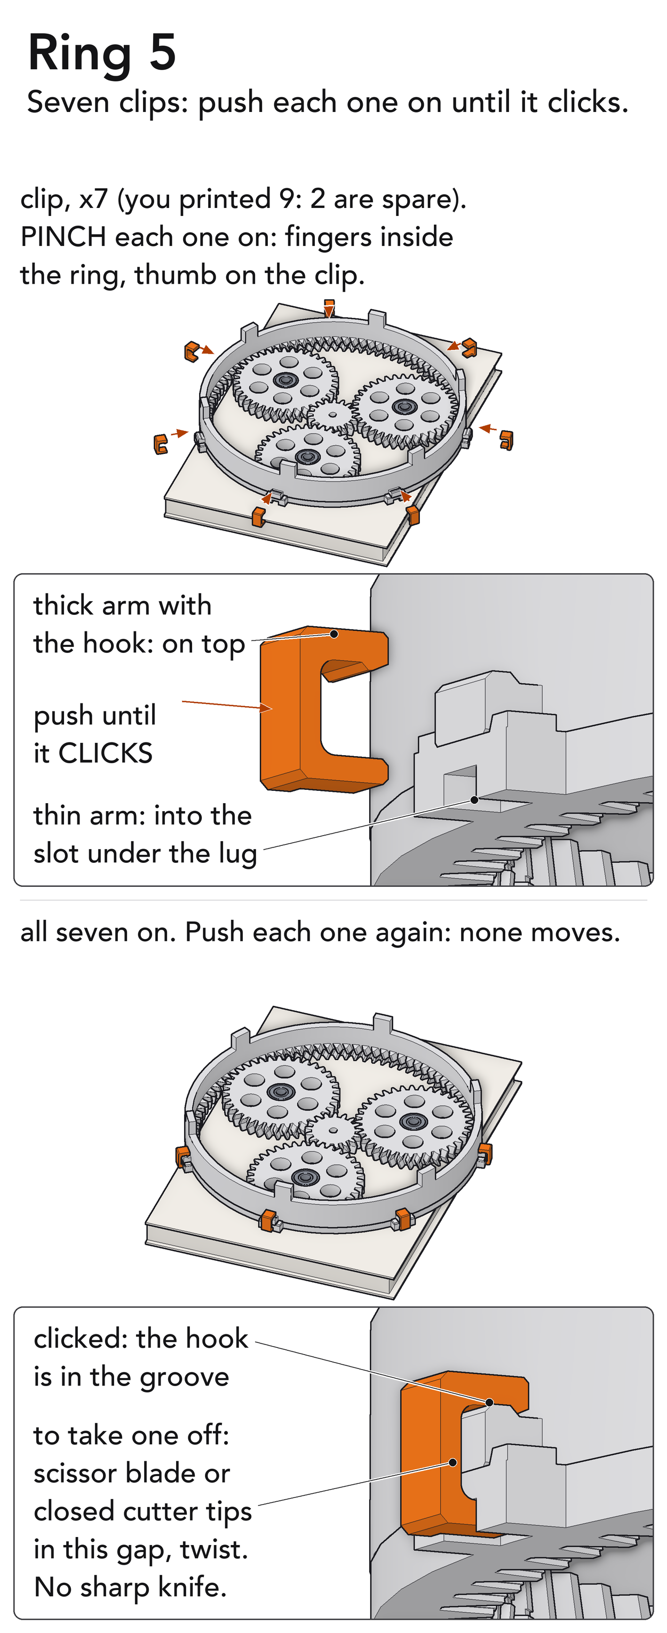
spares/phone/ring_5_phone.png
