Pai-88/crank-charger/spares/phone/ring_6_phone.png

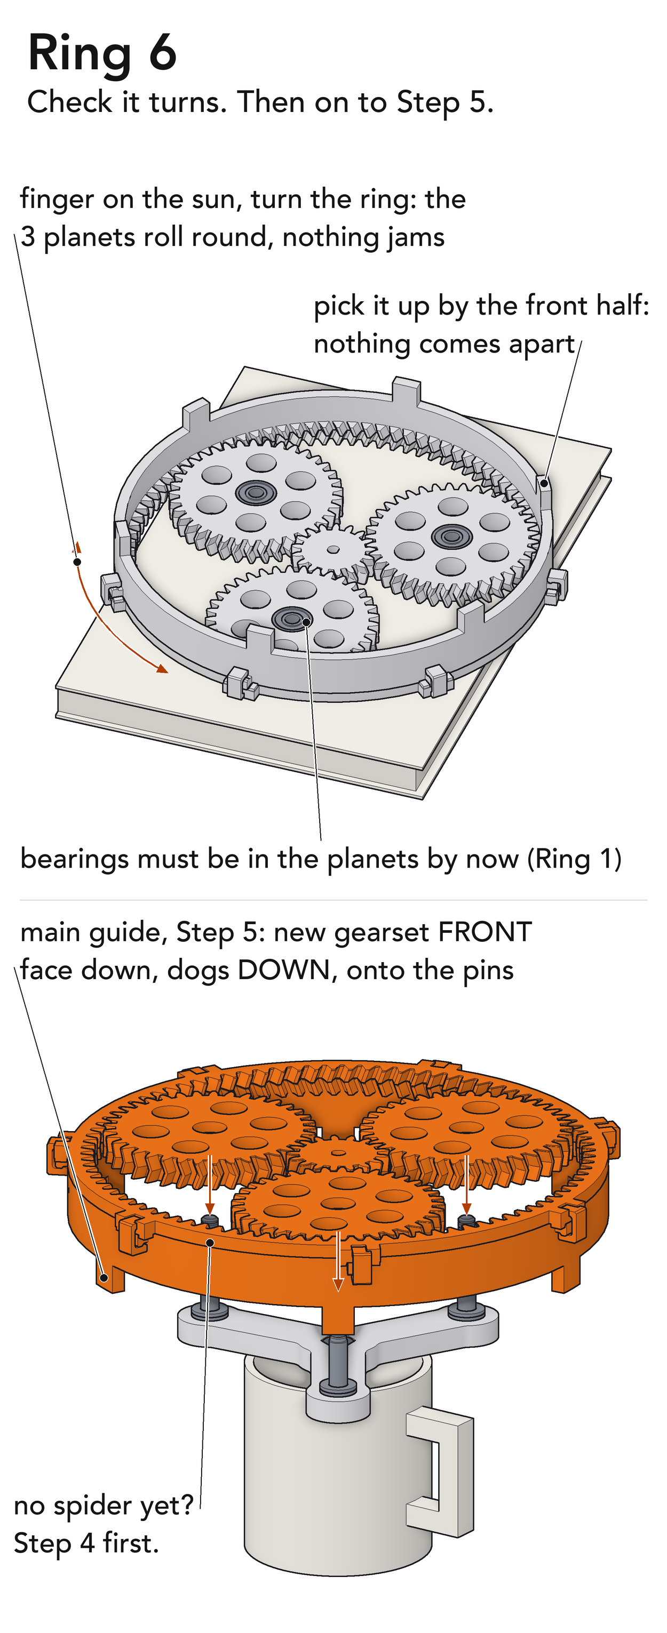
spares/phone/ring_6_phone.png
