Pai-88/crank-charger/spares/ring_0.png

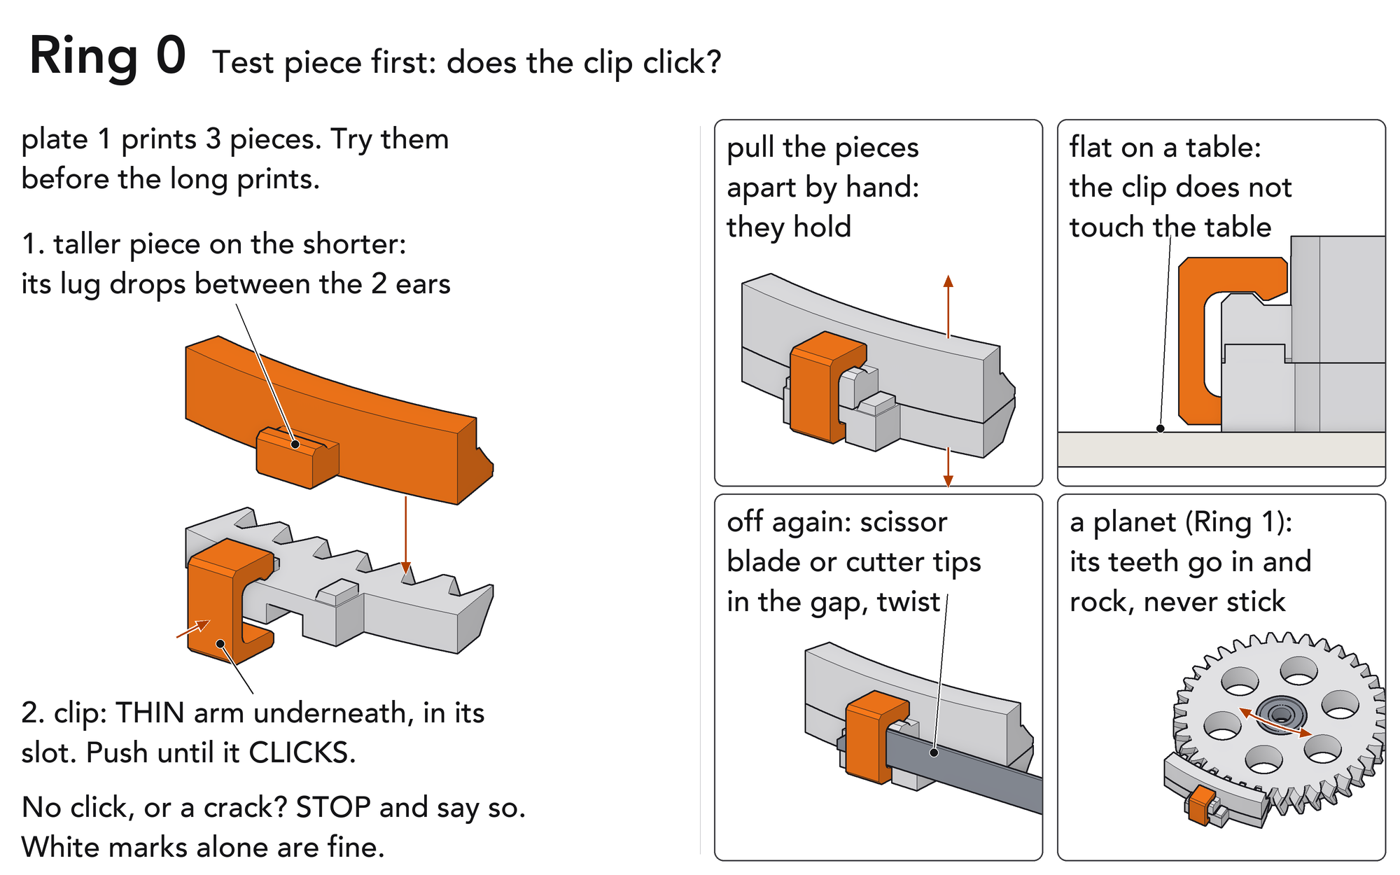
spares/ring_0.png
