Pai-88/crank-charger/spares/ring_1.png

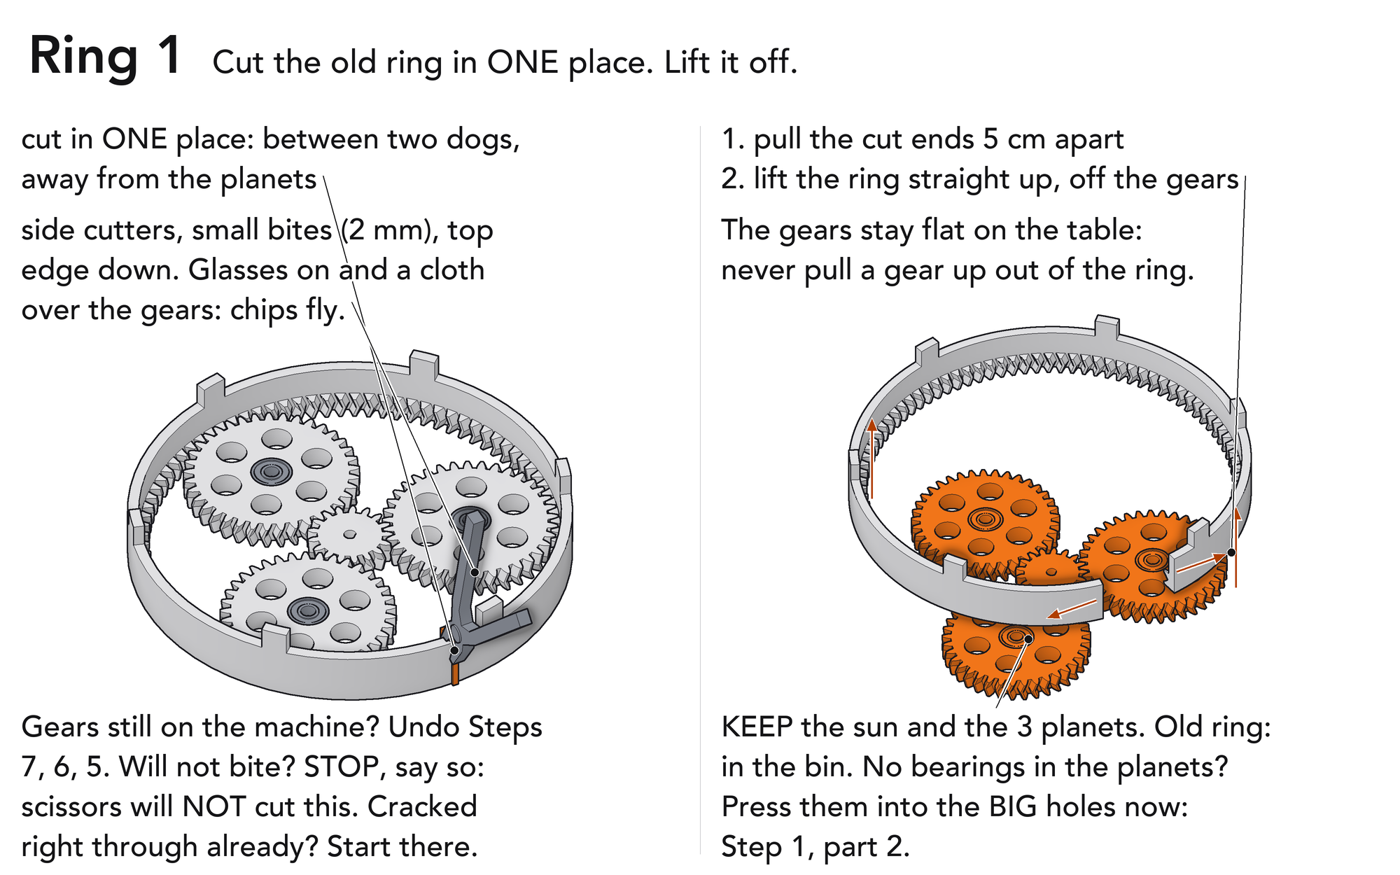
spares/ring_1.png
