Pai-88/crank-charger/spares/ring_2.png

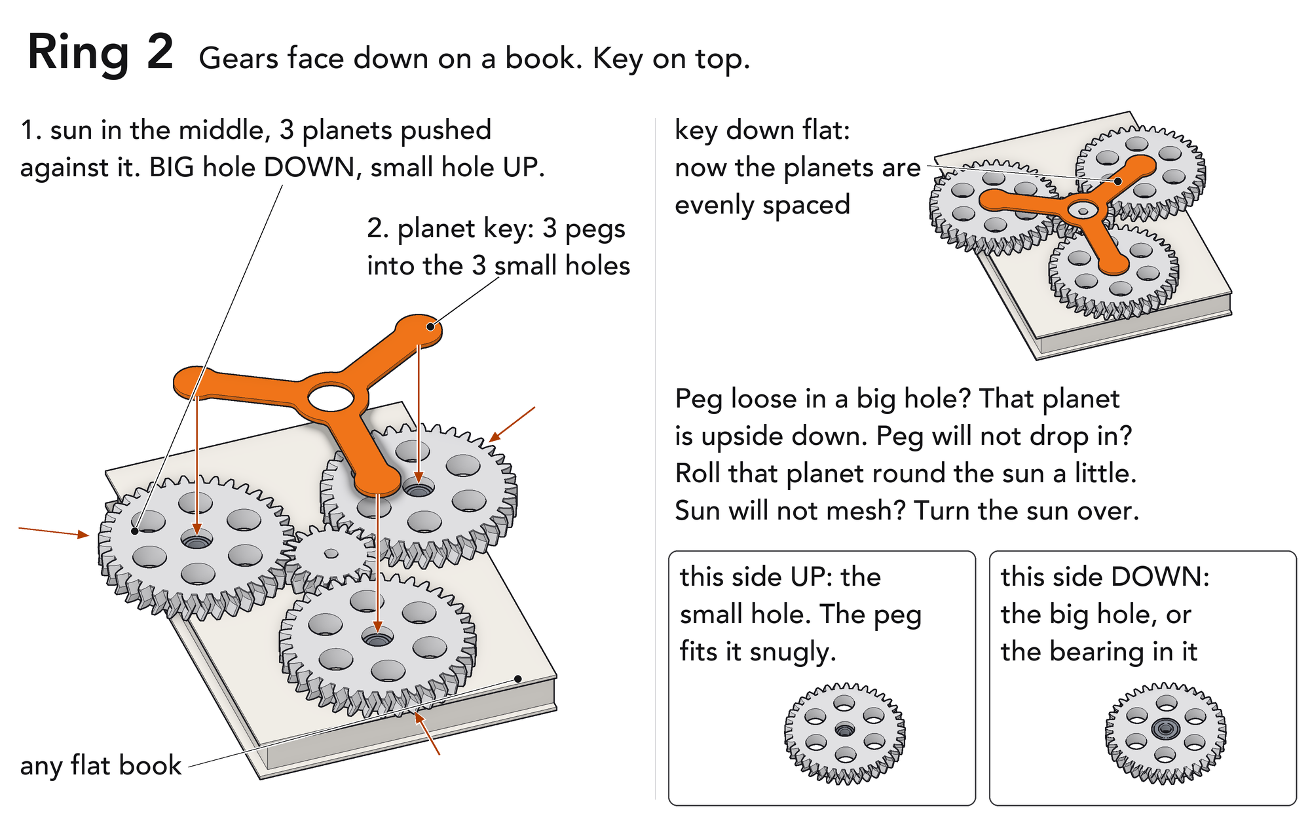
spares/ring_2.png
