Pai-88/crank-charger/spares/ring_3.png

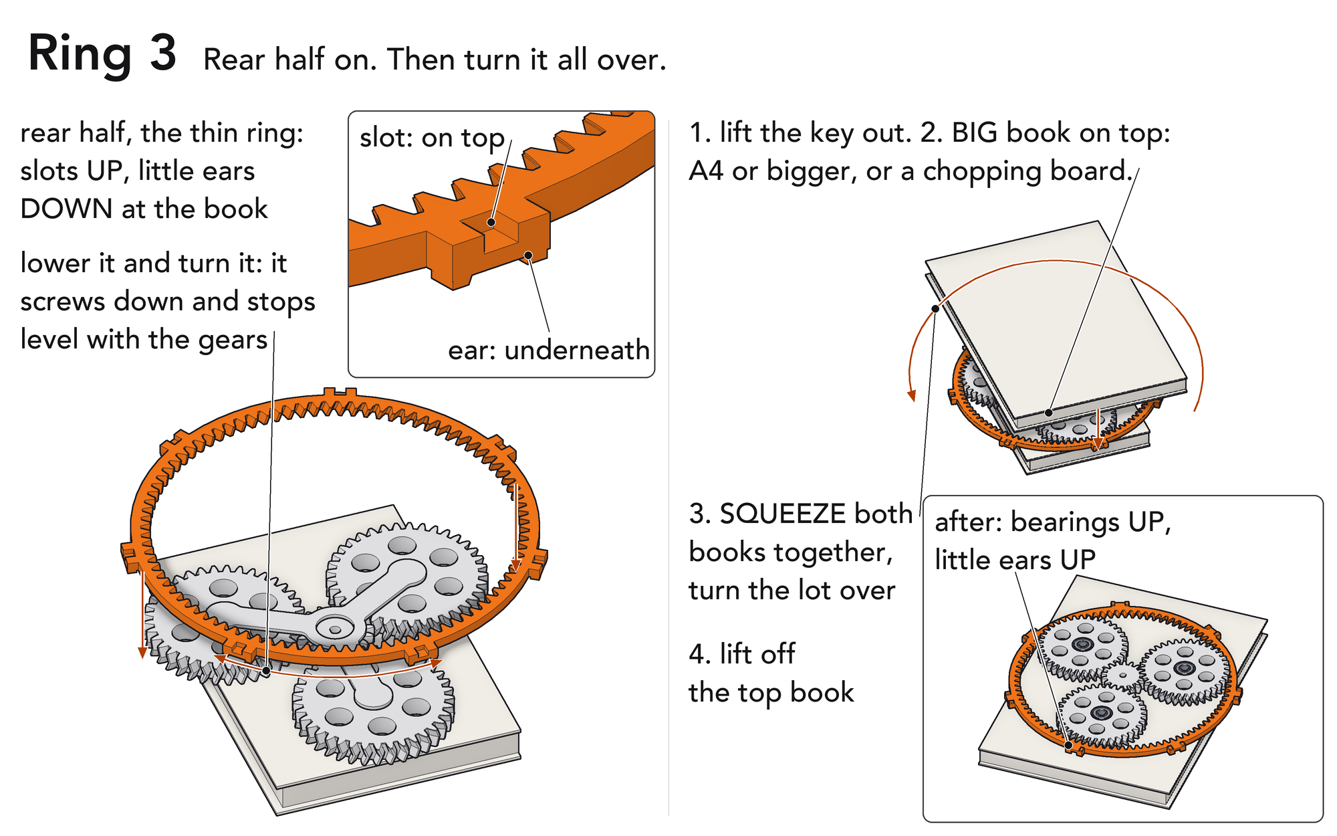
spares/ring_3.png
