Pai-88/crank-charger/spares/ring_4.png

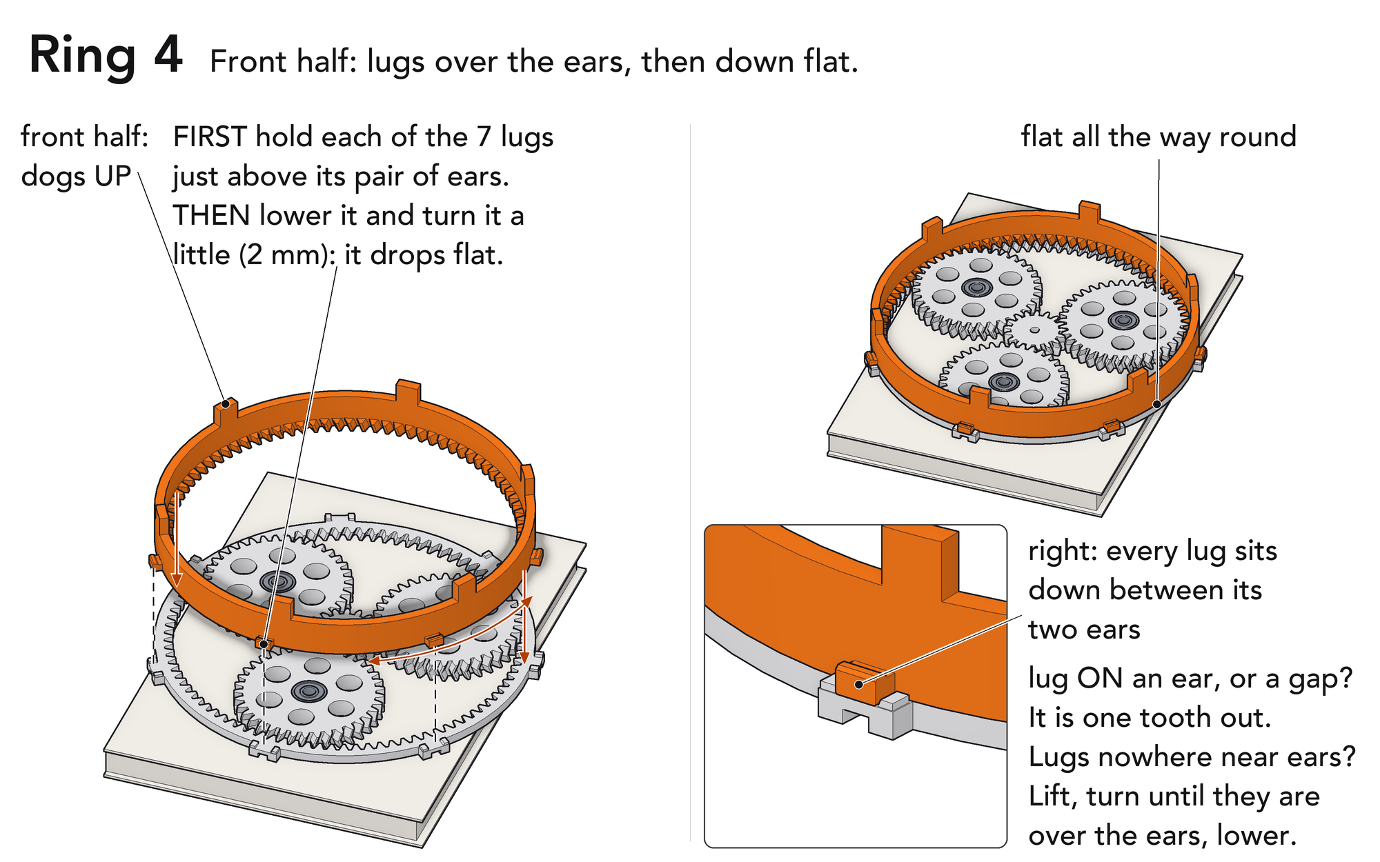
spares/ring_4.png
