Pai-88/crank-charger/spares/ring_5.png

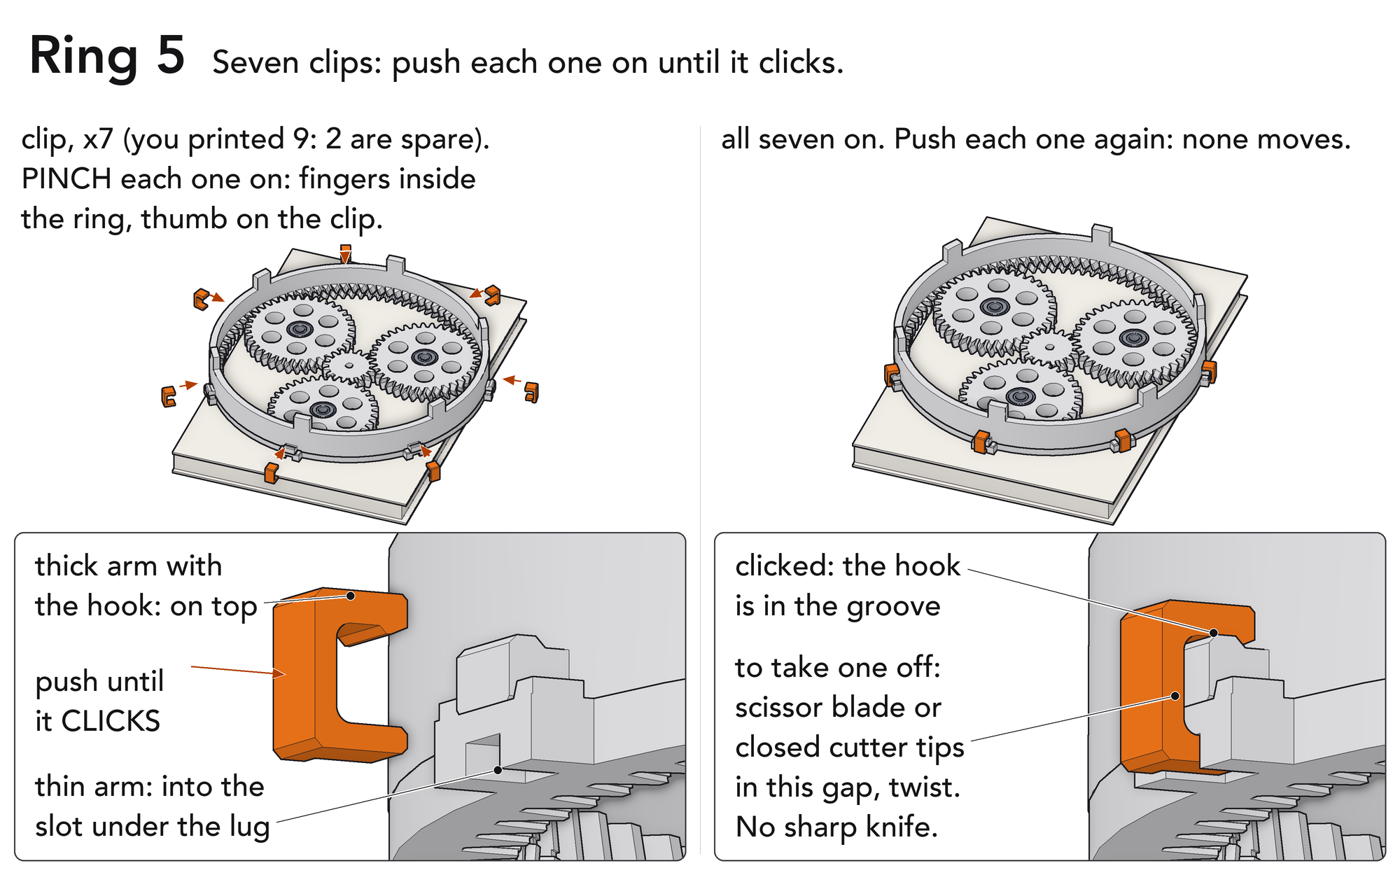
spares/ring_5.png
