Pai-88/crank-charger/spares/ring_6.png

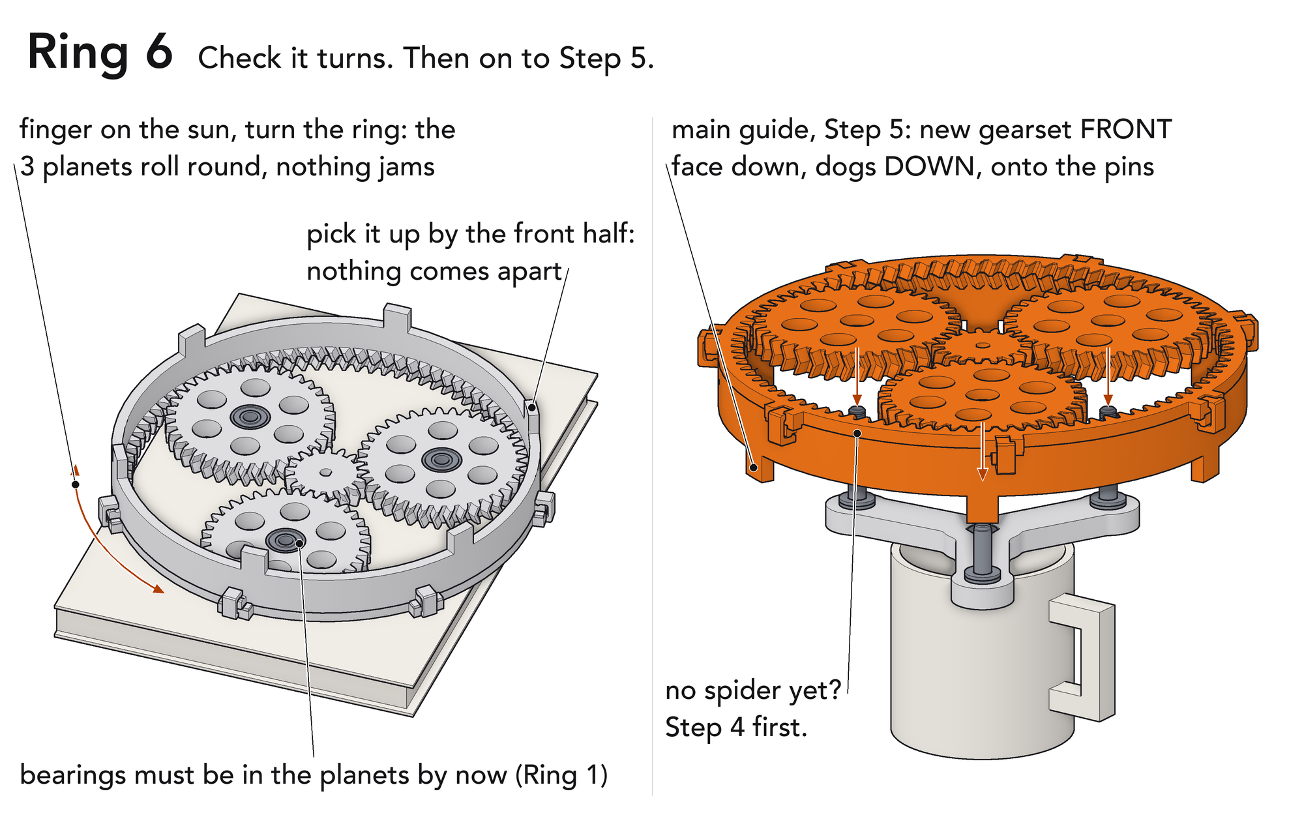
spares/ring_6.png
