Pai-88/crank-charger/video/crank_9x16_46s_thumb.png

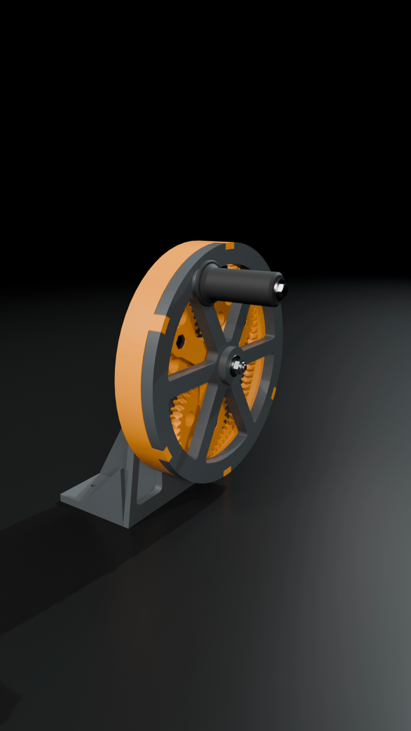
video/crank_9x16_46s_thumb.png
