Pai-88/crank-charger/video/crank_16x9_46s_thumb.png

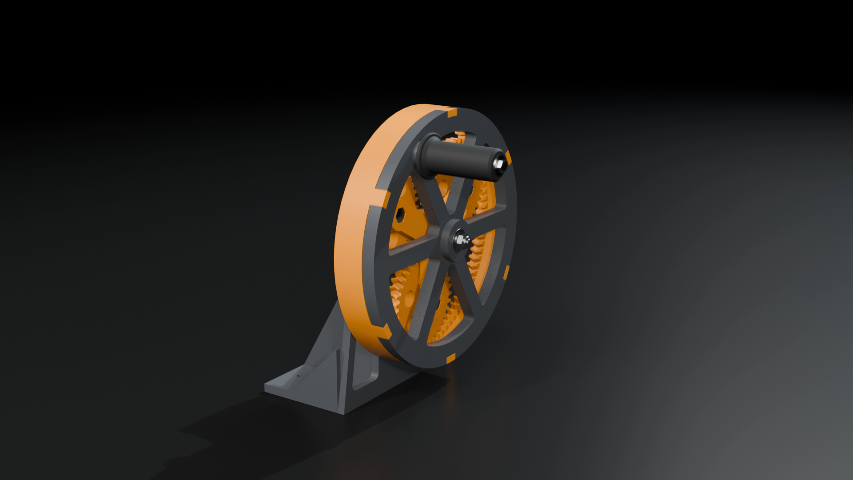
video/crank_16x9_46s_thumb.png
