Pai-88/crank-charger/video/crank_elec9x16_46s_thumb.png

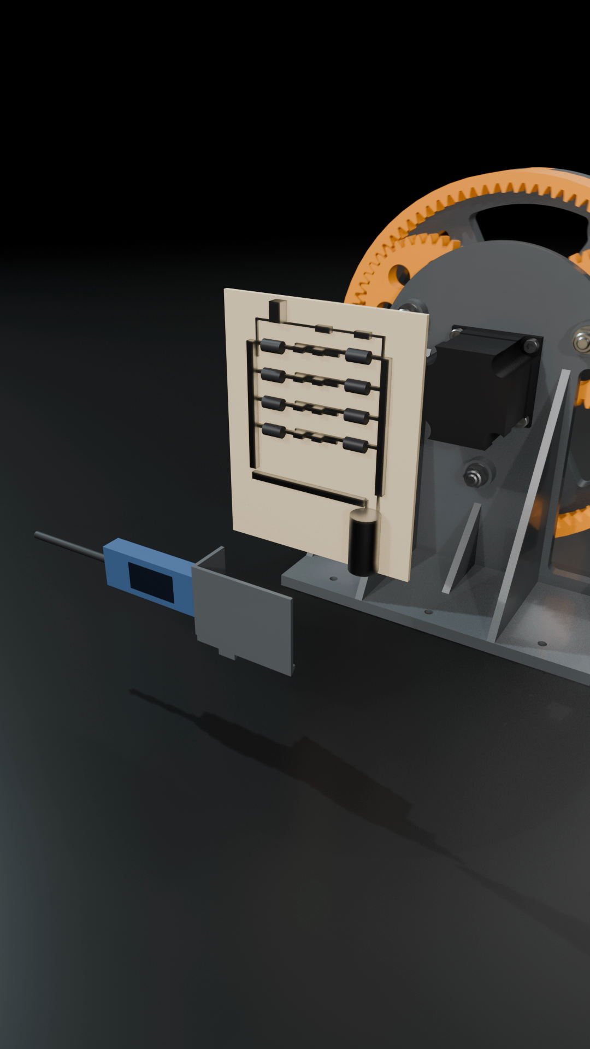
video/crank_elec9x16_46s_thumb.png
