Pai-88/crank-charger/video/crank_elec16x9_46s_thumb.png

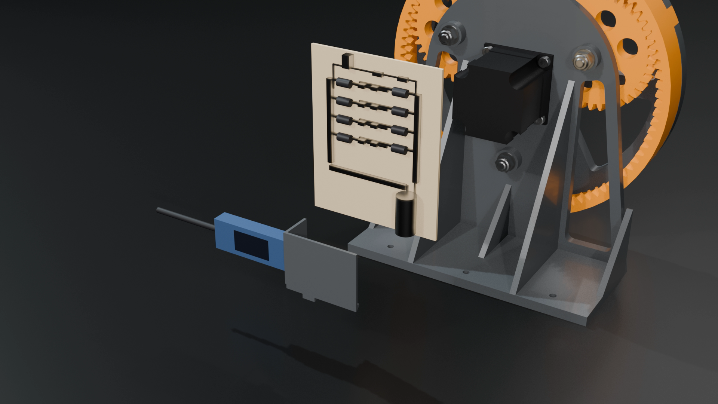
video/crank_elec16x9_46s_thumb.png
