Pai-88/crank-charger/cad/stl/_assembly_VIEW_ONLY.stl

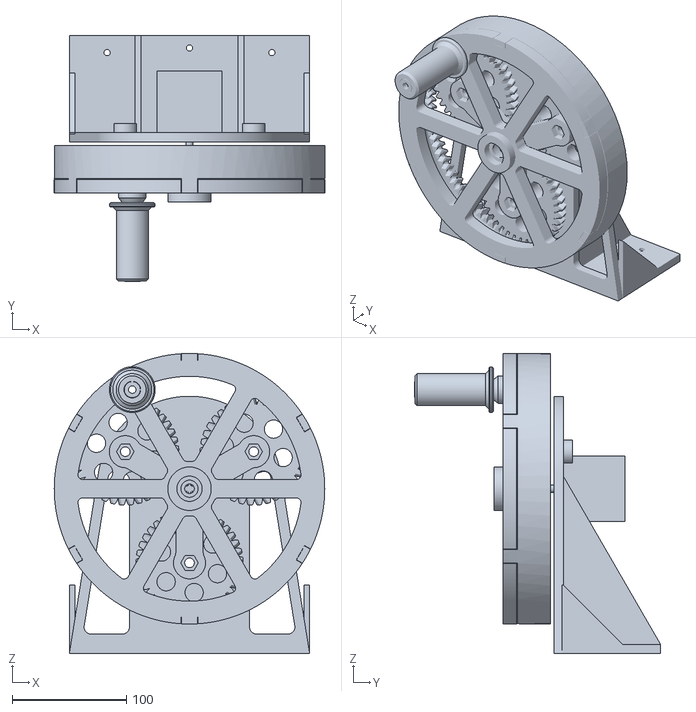
[picture p76: CAD file, 2026-10-13]
cad/stl/_assembly_VIEW_ONLY.stl
236.4 x 215.1 x 262.2
