Pai-88/crank-charger/cad/stl/_coupon_assembled_VIEW_ONLY.stl

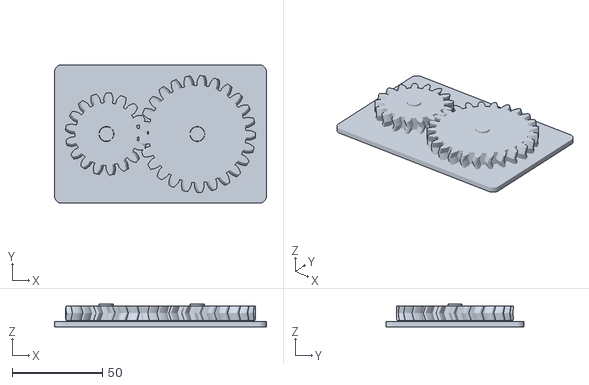
[picture p77: CAD file, 2026-10-13]
cad/stl/_coupon_assembled_VIEW_ONLY.stl
117.6 x 76.8 x 12.6
