Pai-88/crank-charger/cad/stl/_view_wheel.stl

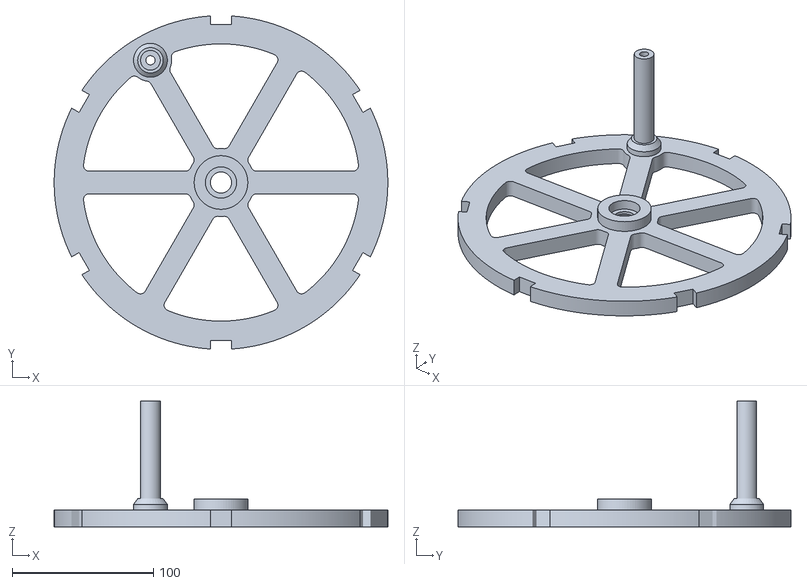
[picture p78: CAD file, 2026-10-13]
cad/stl/_view_wheel.stl
236.4 x 235.9 x 89.2
