Pai-88/crank-charger/cad/stl/batches/plate2a_ring_rear_half.stl

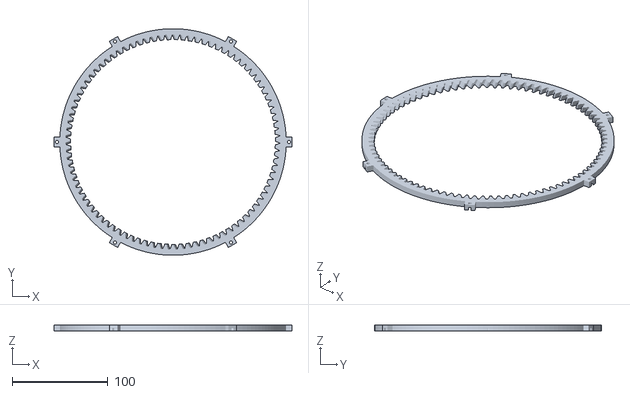
[picture p79: CAD file, 2026-10-13]
cad/stl/batches/plate2a_ring_rear_half.stl
248.4 x 236.4 x 6.00
