Pai-88/crank-charger/cad/stl/cover/1_cover_coupons.stl

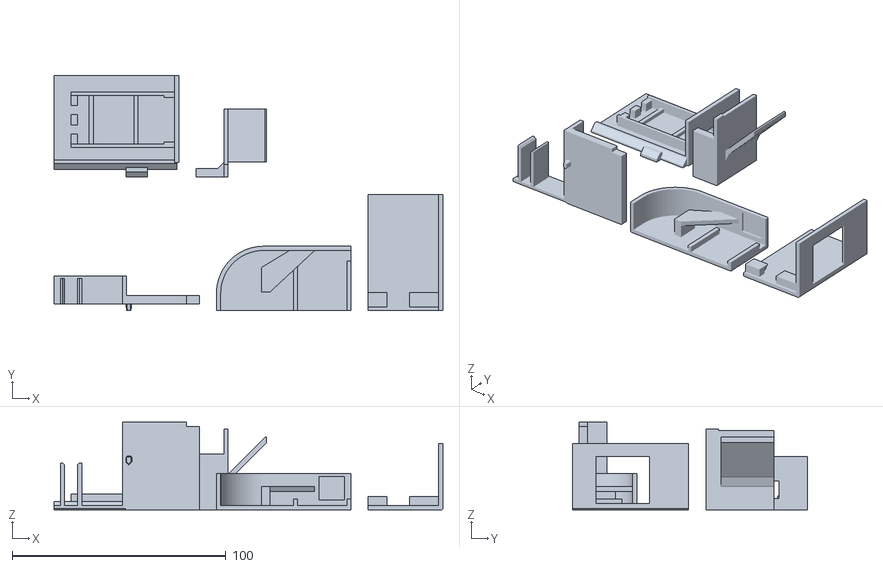
[picture p80: CAD file, 2026-10-13]
cad/stl/cover/1_cover_coupons.stl
182.0 x 109.8 x 41.0
