Pai-88/crank-charger/cad/stl/cover/_concepts_NOT_FOR_PRINTING/concept_base-tray.stl

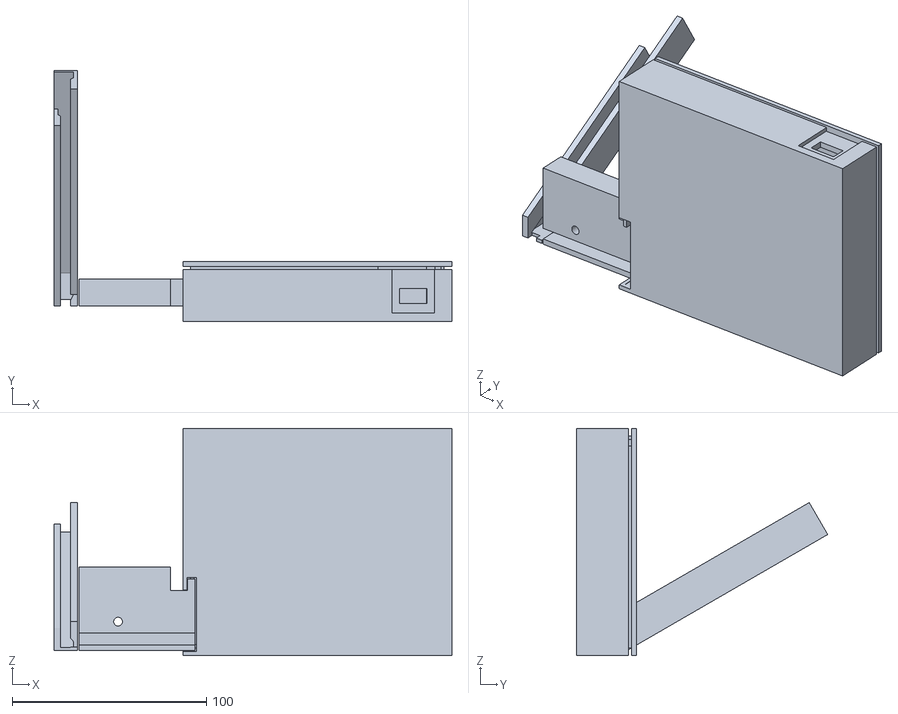
[picture p81: CAD file, 2026-10-13]
cad/stl/cover/_concepts_NOT_FOR_PRINTING/concept_base-tray.stl
205.0 x 129.5 x 117.0
