Pai-88/crank-charger/cad/stl/cover/_view_NOT_FOR_PRINTING/modparts.stl

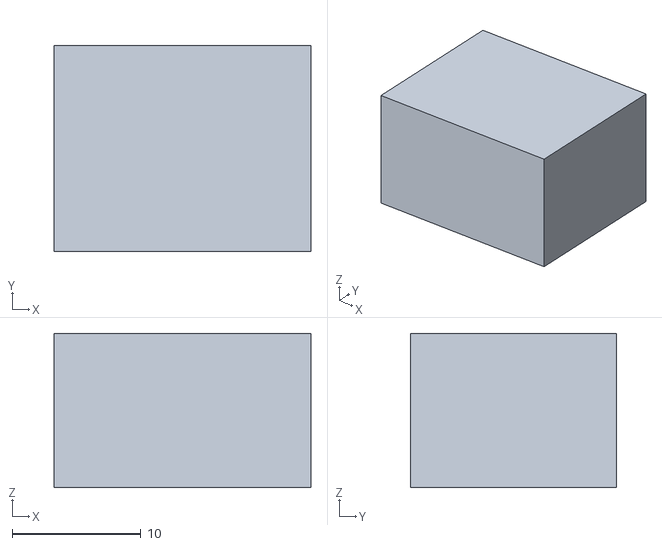
[picture p82: CAD file, 2026-10-13]
cad/stl/cover/_view_NOT_FOR_PRINTING/modparts.stl
20.0 x 16.0 x 12.0
