Pai-88/crank-charger/cad/stl/spares/wheel_keeper_band.stl

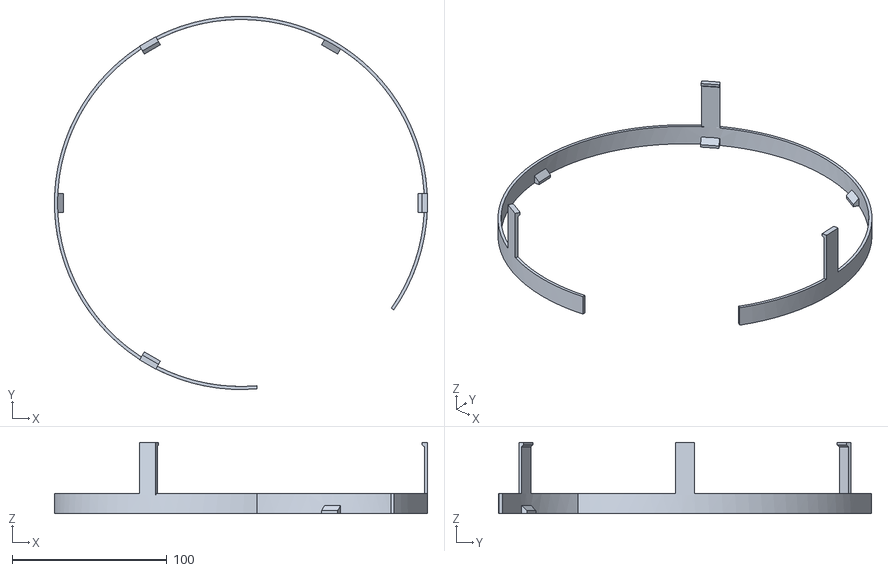
[picture p83: CAD file, 2026-10-13]
cad/stl/spares/wheel_keeper_band.stl
241.0 x 240.9 x 45.9
