Pai-88/crank-charger/cad/stl/_view_spider.stl

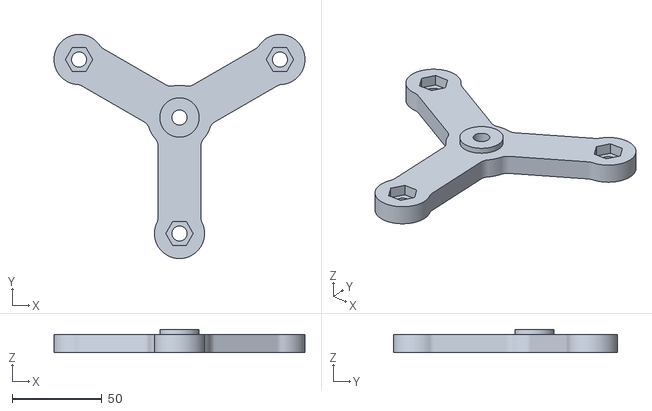
[picture p84: CAD file, 2026-10-13]
cad/stl/_view_spider.stl
140.2 x 125.2 x 12.9
