Pai-88/crank-charger/cad/stl/batches/plate2b_ring_front_half.stl

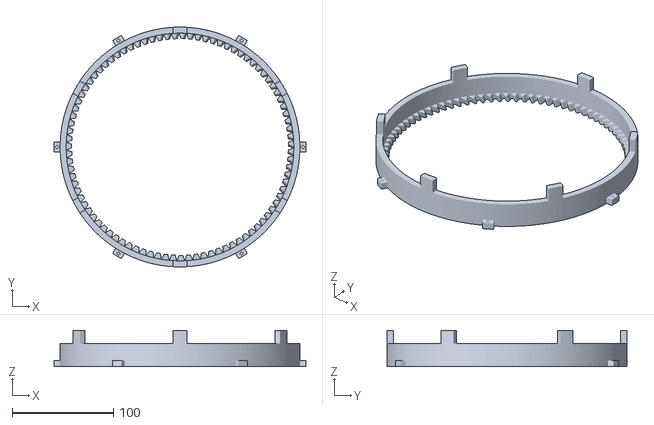
[picture p85: CAD file, 2026-10-13]
cad/stl/batches/plate2b_ring_front_half.stl
248.4 x 236.4 x 35.7
