Pai-88/crank-charger/cad/stl/cover/3_module_sled_PLACEHOLDER_do_not_print_yet.stl

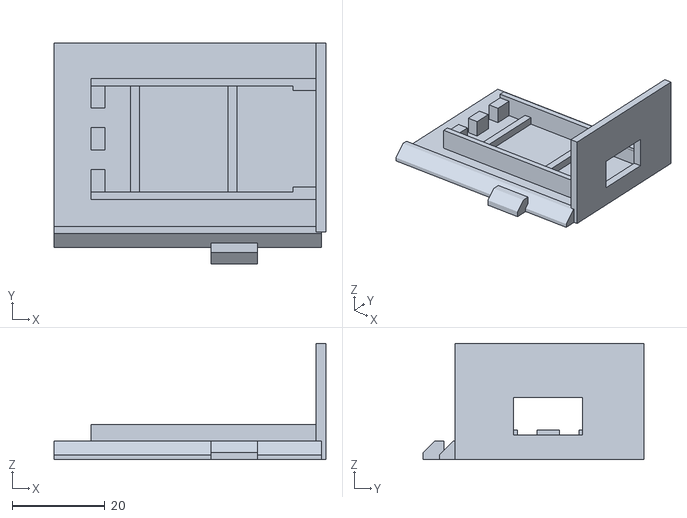
[picture p86: CAD file, 2026-10-13]
cad/stl/cover/3_module_sled_PLACEHOLDER_do_not_print_yet.stl
58.5 x 47.5 x 25.0
