Pai-88/crank-charger/cad/stl/cover/_concepts_NOT_FOR_PRINTING/_view_backpack_clamp_l.stl

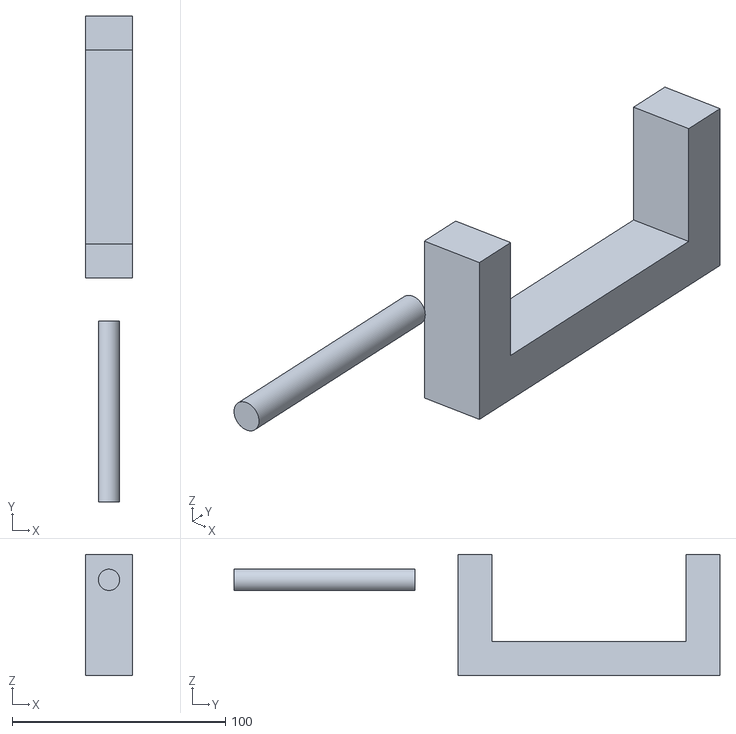
[picture p87: CAD file, 2026-10-13]
cad/stl/cover/_concepts_NOT_FOR_PRINTING/_view_backpack_clamp_l.stl
22.0 x 228.0 x 57.0
