Pai-88/crank-charger/cad/stl/cover/_view_NOT_FOR_PRINTING/wire_lead2.stl

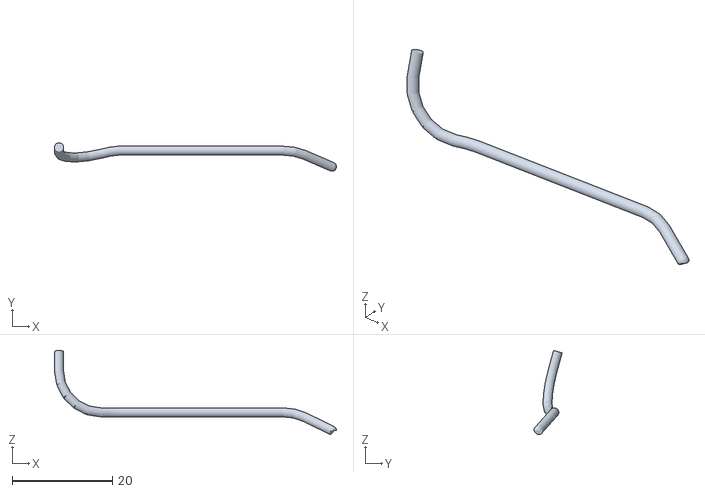
[picture p88: CAD file, 2026-10-13]
cad/stl/cover/_view_NOT_FOR_PRINTING/wire_lead2.stl
56.2 x 5.67 x 16.8
