Pai-88/crank-charger/cad/stl/spares/4_ring_clips.stl

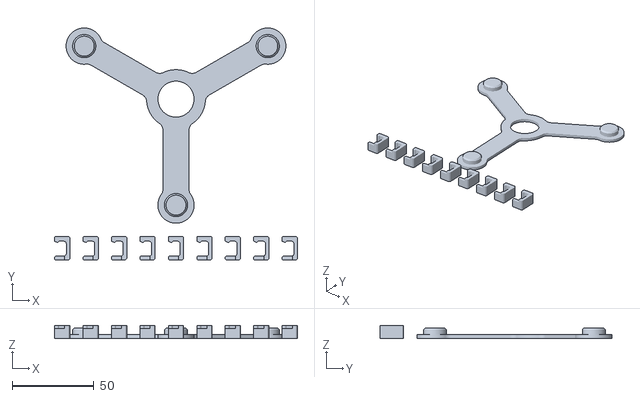
[picture p89: CAD file, 2026-10-13]
cad/stl/spares/4_ring_clips.stl
148.6 x 141.9 x 8.00
