Pai-88/crank-charger/cad/stl/batches/plate2_gearset.stl

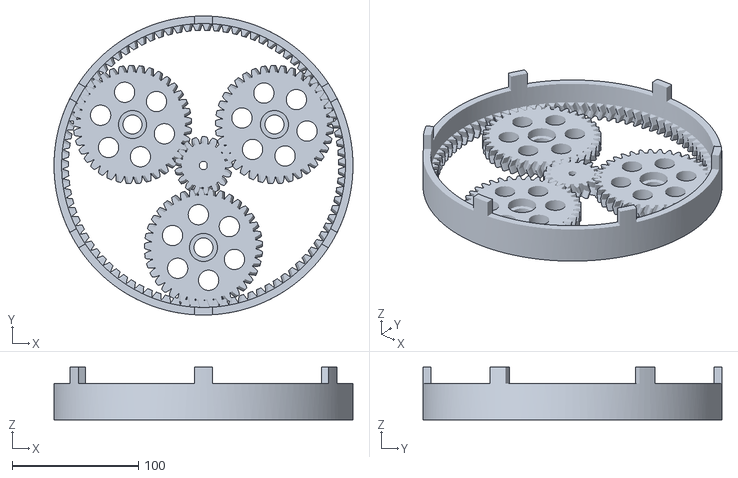
[picture p90: CAD file, 2026-10-13]
cad/stl/batches/plate2_gearset.stl
236.4 x 236.4 x 41.7
