Pai-88/crank-charger/cad/stl/cover/2_cover_shell.stl

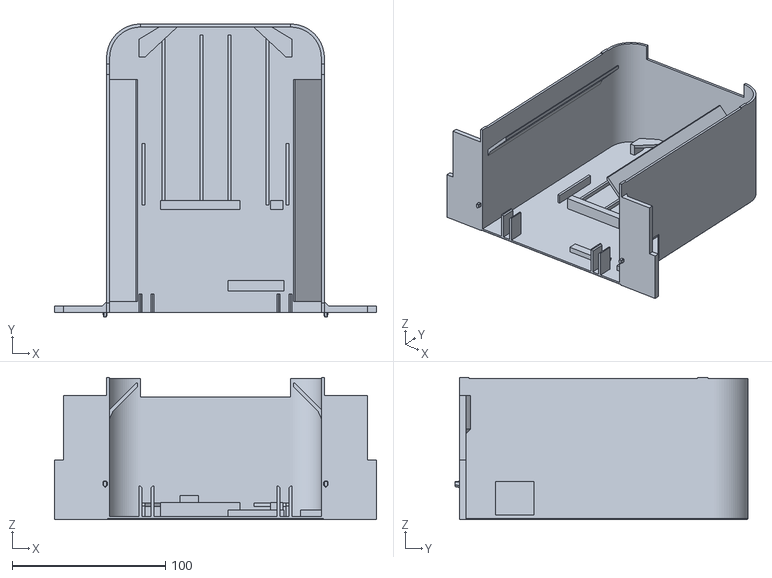
[picture p91: CAD file, 2026-10-13]
cad/stl/cover/2_cover_shell.stl
210.0 x 191.0 x 92.8
