Pai-88/crank-charger/cad/stl/cover/_concepts_NOT_FOR_PRINTING/_view_backpack_bridge.stl

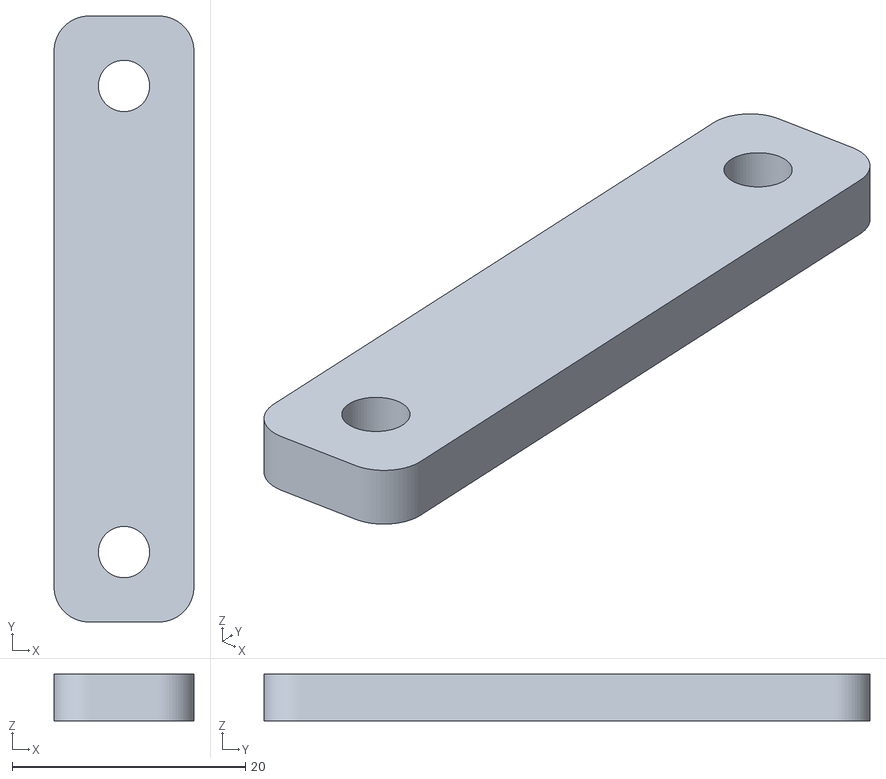
[picture p92: CAD file, 2026-10-13]
cad/stl/cover/_concepts_NOT_FOR_PRINTING/_view_backpack_bridge.stl
12.0 x 52.0 x 4.00
