Pai-88/crank-charger/cad/stl/cover/_view_NOT_FOR_PRINTING/table_-520_170_-230_230.stl

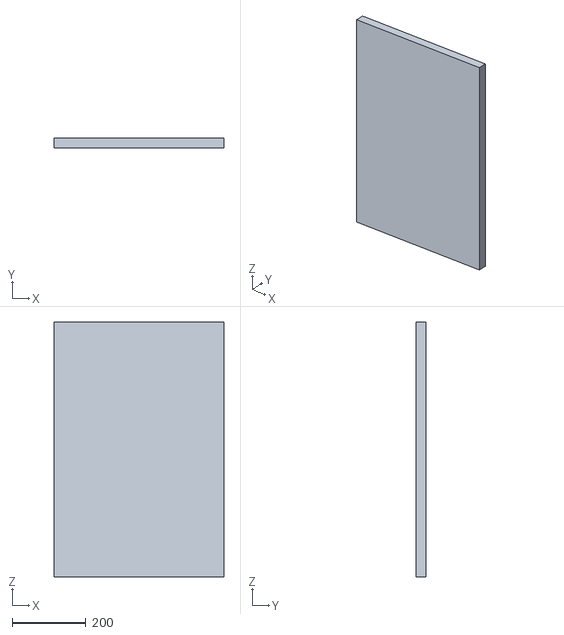
[picture p93: CAD file, 2026-10-13]
cad/stl/cover/_view_NOT_FOR_PRINTING/table_-520_170_-230_230.stl
460.0 x 28.0 x 690.0
