Pai-88/crank-charger/cad/stl/spares/wheel_bayonet.stl

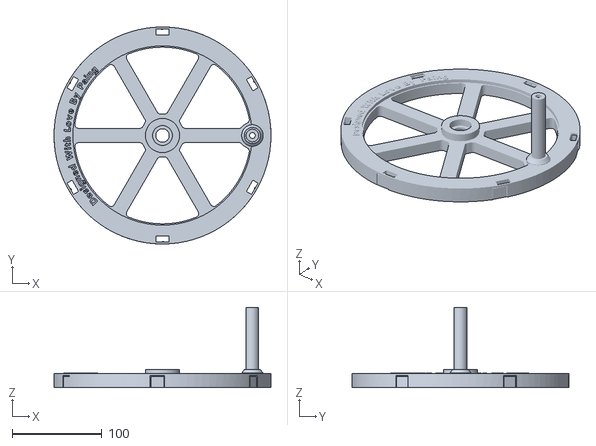
[picture p94: CAD file, 2026-10-13]
cad/stl/spares/wheel_bayonet.stl
241.4 x 241.4 x 89.2
