Pai-88/crank-charger/cad/stl/coupon_plate.stl

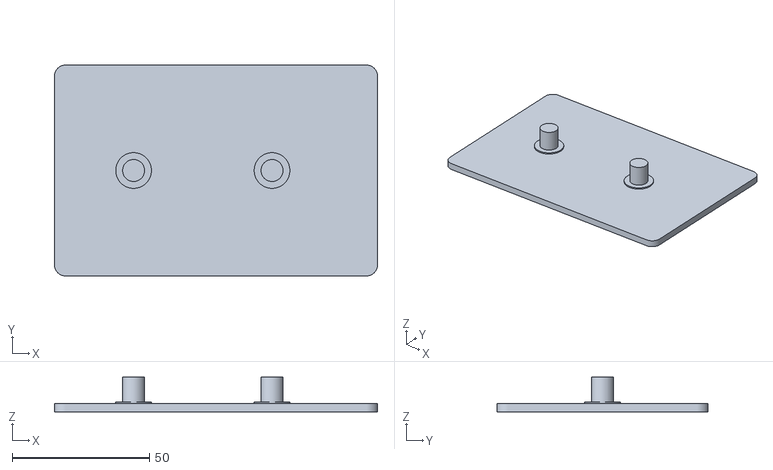
[picture p95: CAD file, 2026-10-13]
cad/stl/coupon_plate.stl
117.6 x 76.8 x 12.6
