Pai-88/crank-charger/cad/stl/cover/_concepts_NOT_FOR_PRINTING/_view_minimal_clamp_l.stl

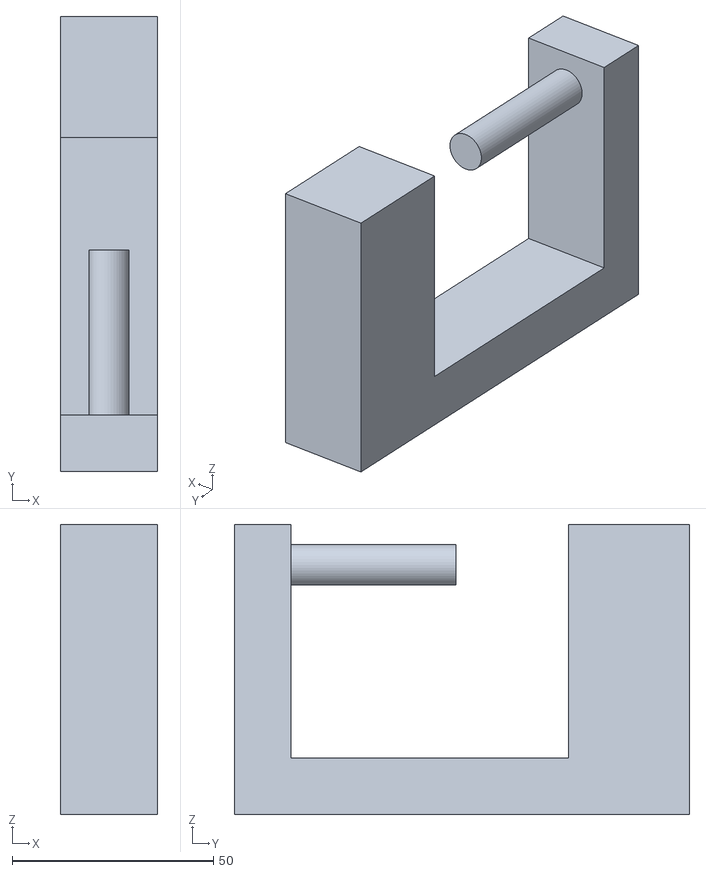
[picture p96: CAD file, 2026-10-13]
cad/stl/cover/_concepts_NOT_FOR_PRINTING/_view_minimal_clamp_l.stl
24.0 x 113.0 x 72.0
