Pai-88/crank-charger/cad/stl/cover/_view_NOT_FOR_PRINTING/phone_lead.stl

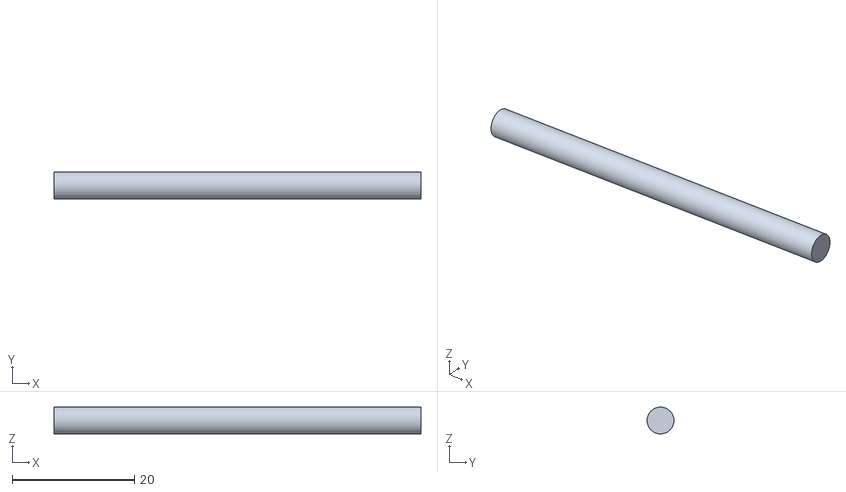
[picture p97: CAD file, 2026-10-13]
cad/stl/cover/_view_NOT_FOR_PRINTING/phone_lead.stl
60.0 x 4.40 x 4.39
