Pai-88/crank-charger/cad/stl/spares/2_ring_rear_half_clip.stl

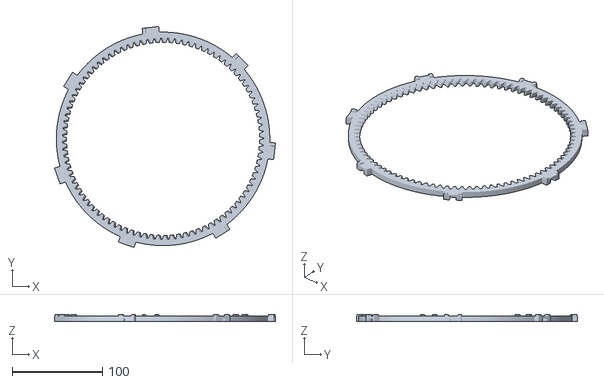
[picture p98: CAD file, 2026-10-13]
cad/stl/spares/2_ring_rear_half_clip.stl
244.7 x 244.8 x 7.60
