Pai-88/crank-charger/cad/stl/_view_planet1.stl

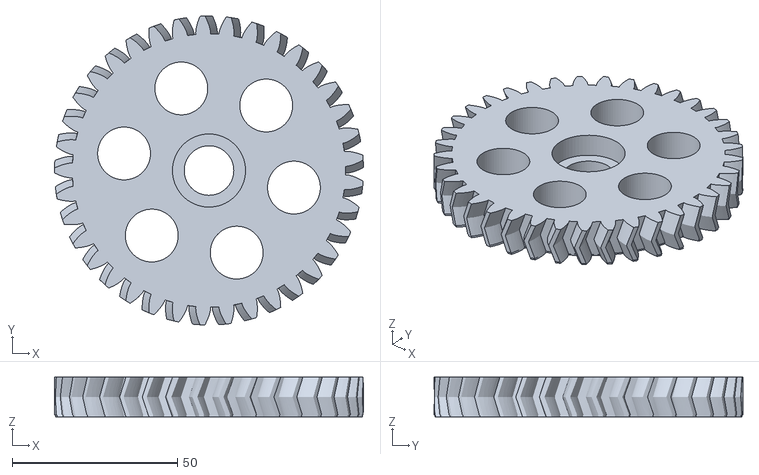
[picture p99: CAD file, 2026-10-13]
cad/stl/_view_planet1.stl
93.6 x 93.6 x 12.0
