Pai-88/crank-charger/cad/stl/batches/plate4_frame.stl

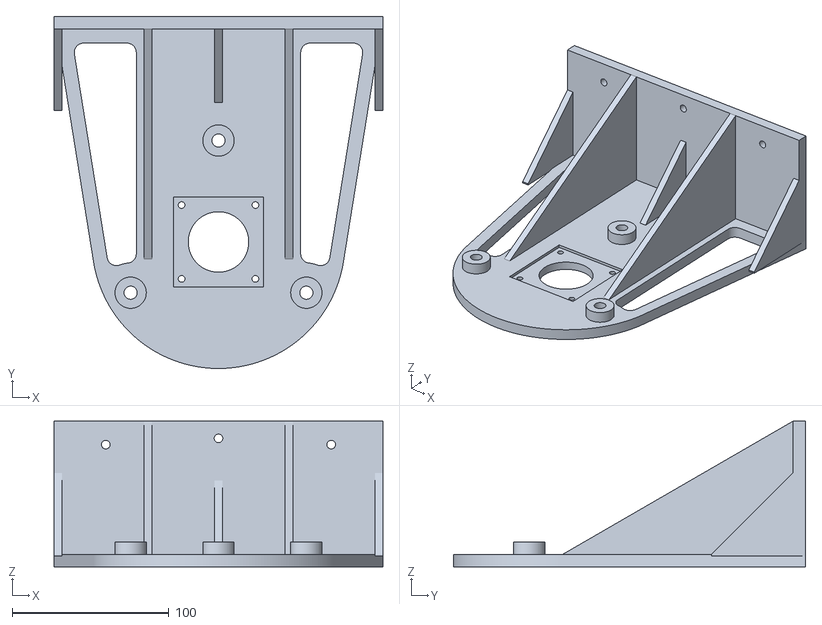
[picture p100: CAD file, 2026-10-13]
cad/stl/batches/plate4_frame.stl
210.0 x 224.8 x 93.0
