Pai-88/crank-charger/cad/stl/cover/_concepts_NOT_FOR_PRINTING/_view_minimal_sled.stl

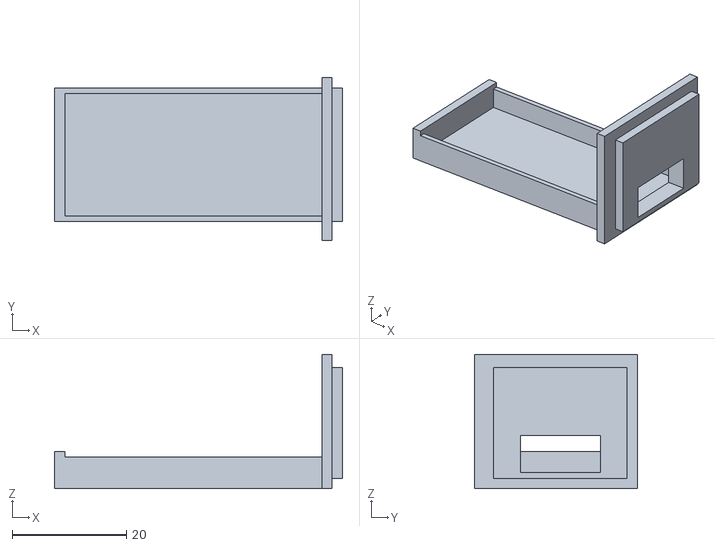
[picture p101: CAD file, 2026-10-13]
cad/stl/cover/_concepts_NOT_FOR_PRINTING/_view_minimal_sled.stl
50.4 x 28.5 x 23.5
