Pai-88/crank-charger/cad/stl/cover/_view_NOT_FOR_PRINTING/socket.stl

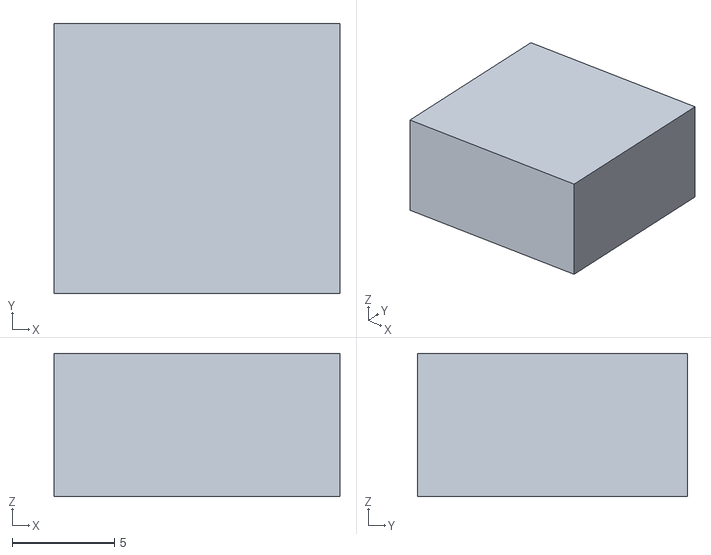
[picture p102: CAD file, 2026-10-13]
cad/stl/cover/_view_NOT_FOR_PRINTING/socket.stl
14.0 x 13.2 x 7.00
