Pai-88/crank-charger/cad/stl/spares/3_ring_front_half_clip.stl

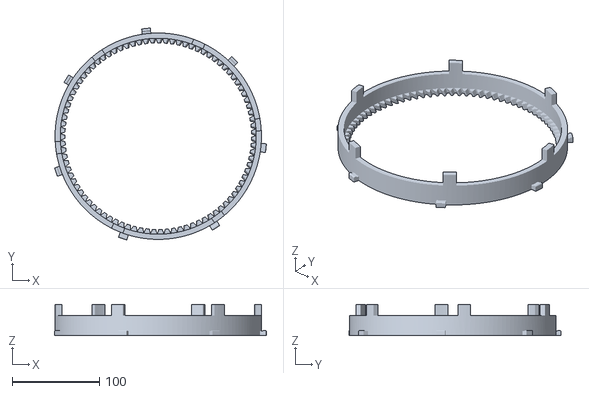
[picture p103: CAD file, 2026-10-13]
cad/stl/spares/3_ring_front_half_clip.stl
242.8 x 242.9 x 35.7
