Pai-88/crank-charger/cad/stl/batches/plate1_coupon_and_small_parts.stl

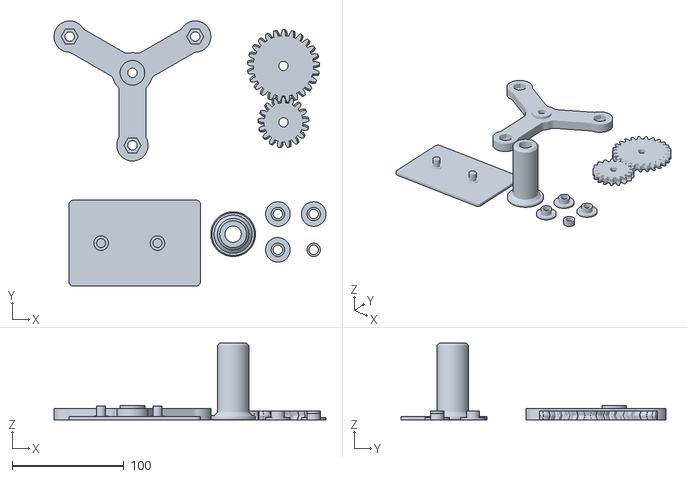
[picture p104: CAD file, 2026-10-13]
cad/stl/batches/plate1_coupon_and_small_parts.stl
243.1 x 237.0 x 68.7
