Pai-88/crank-charger/cad/stl/cover/_concepts_NOT_FOR_PRINTING/_view_minimal_table.stl

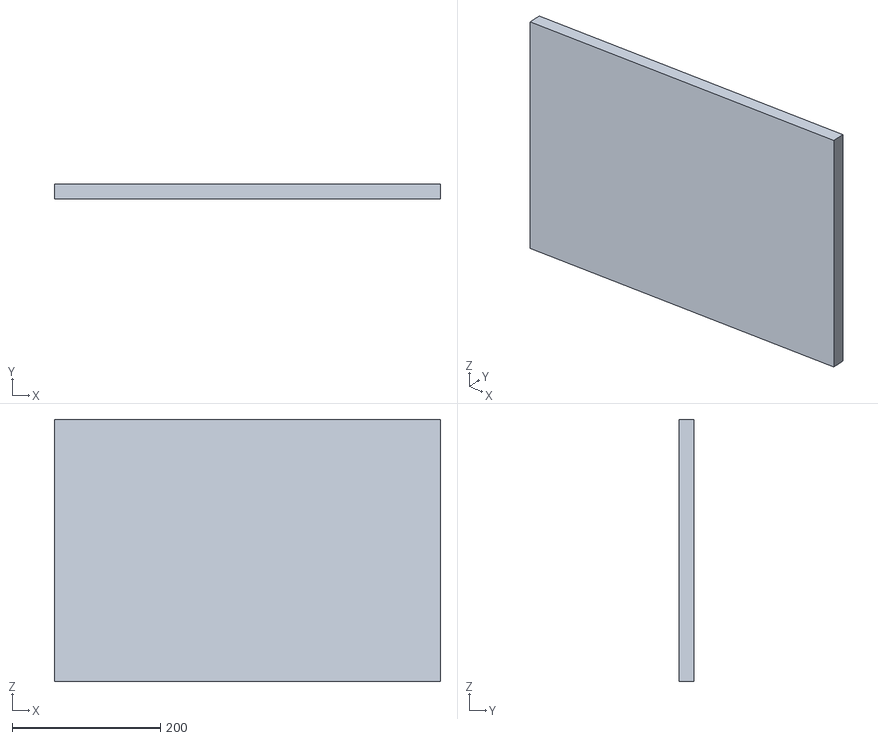
[picture p105: CAD file, 2026-10-13]
cad/stl/cover/_concepts_NOT_FOR_PRINTING/_view_minimal_table.stl
520.0 x 20.0 x 353.0
