Pai-88/crank-charger/cad/stl/cover/_view_NOT_FOR_PRINTING/books.stl

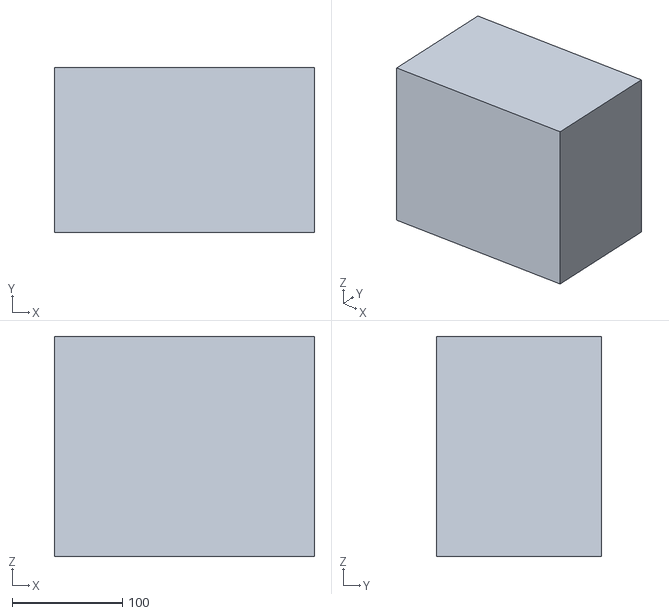
[picture p106: CAD file, 2026-10-13]
cad/stl/cover/_view_NOT_FOR_PRINTING/books.stl
236.0 x 150.0 x 200.0
