Pai-88/crank-charger/cad/stl/grip.stl

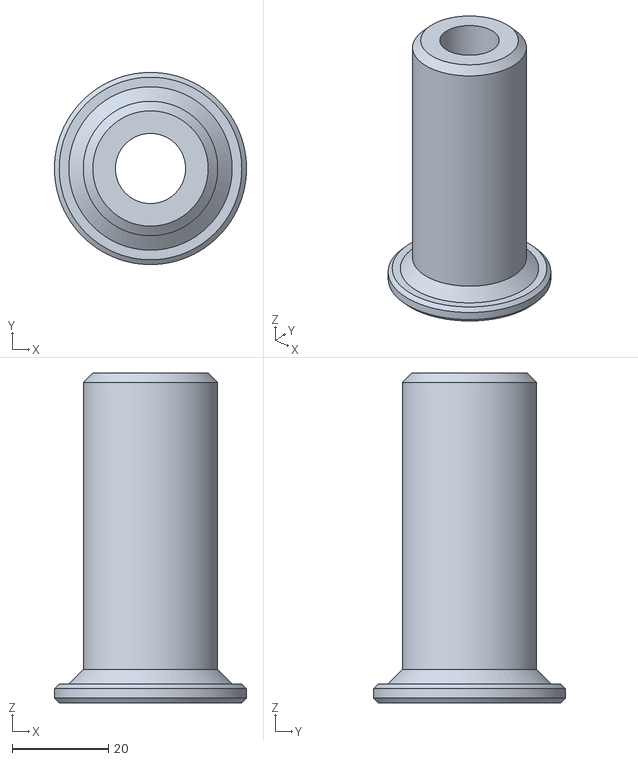
[picture p107: CAD file, 2026-10-13]
cad/stl/grip.stl
40.0 x 40.0 x 68.7
