Pai-88/crank-charger/cad/stl/spares/1_ring_clip_coupon.stl

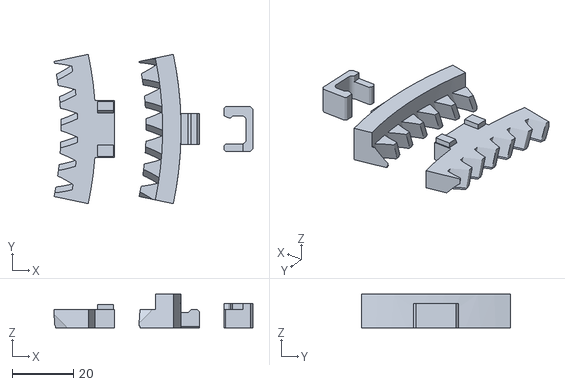
[picture p108: CAD file, 2026-10-13]
cad/stl/spares/1_ring_clip_coupon.stl
64.8 x 48.6 x 11.0
