Pai-88/crank-charger/cad/stl/cover/_concepts_NOT_FOR_PRINTING/_view_base-tray_leads_exposed.stl

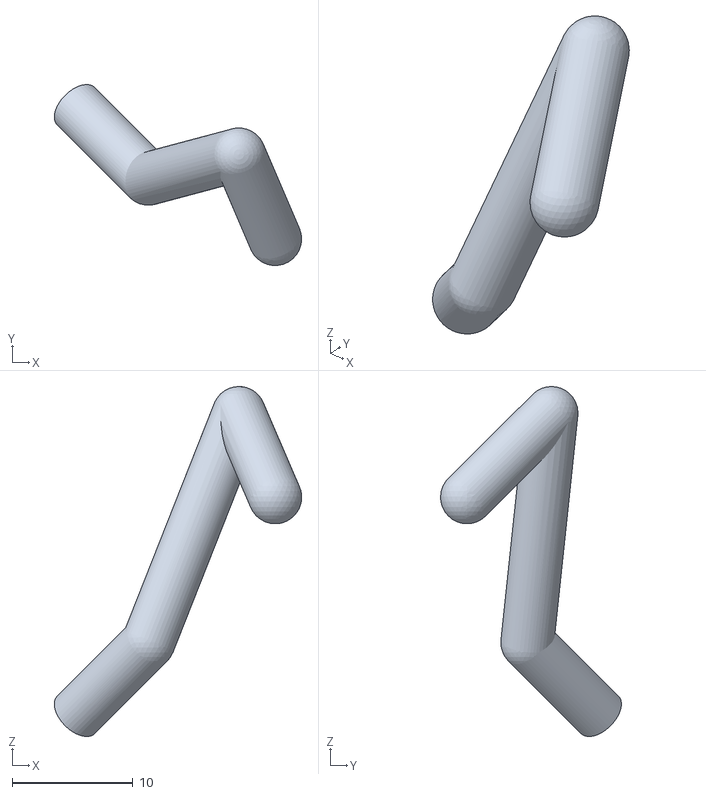
[picture p109: CAD file, 2026-10-13]
cad/stl/cover/_concepts_NOT_FOR_PRINTING/_view_base-tray_leads_exposed.stl
20.5 x 15.0 x 29.0
