Pai-88/crank-charger/cad/stl/cover/_view_NOT_FOR_PRINTING/clamp_r.stl

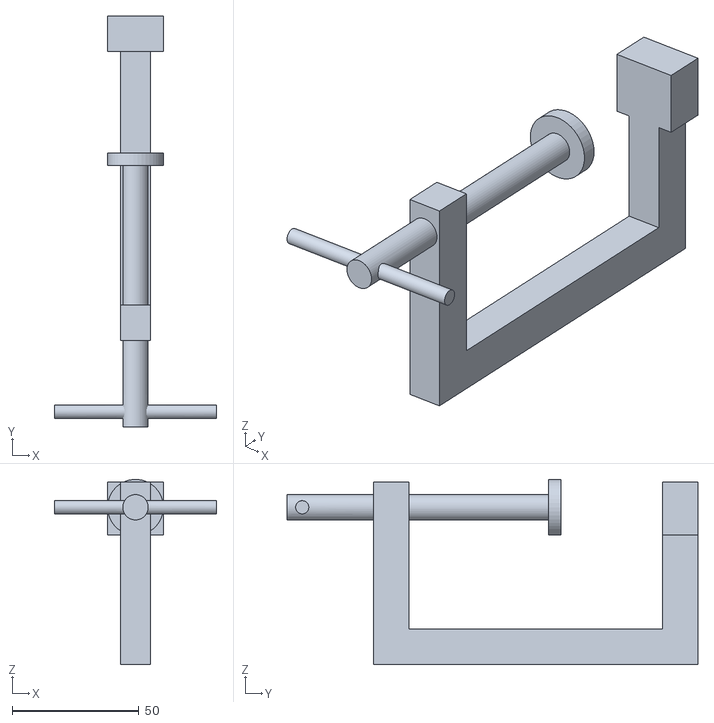
[picture p110: CAD file, 2026-10-13]
cad/stl/cover/_view_NOT_FOR_PRINTING/clamp_r.stl
64.0 x 162.0 x 73.0
