Pai-88/crank-charger/cad/stl/spares/frame_click.stl

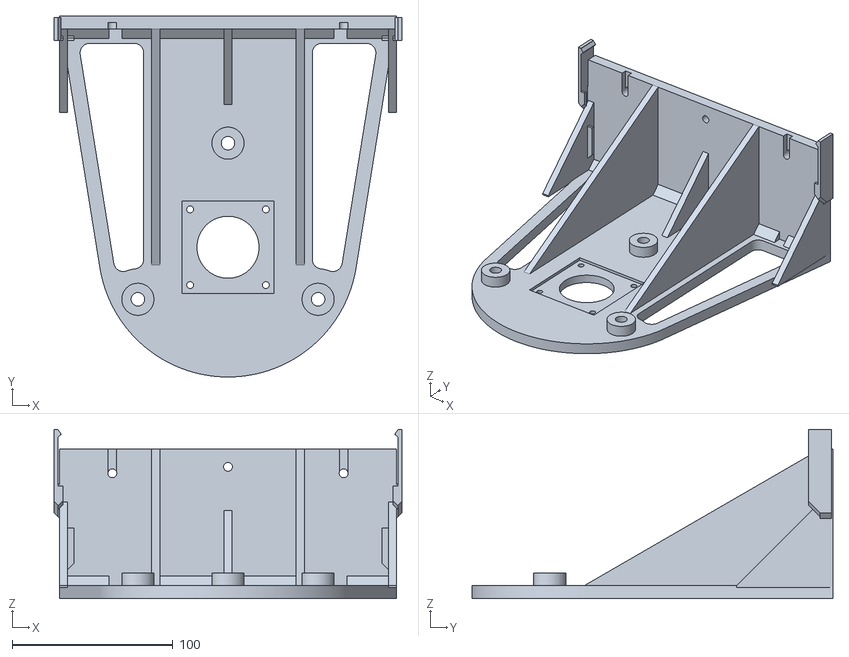
[picture p111: CAD file, 2026-10-13]
cad/stl/spares/frame_click.stl
216.4 x 224.8 x 105.3
