Pai-88/crank-charger/cad/stl/cover/_concepts_NOT_FOR_PRINTING/_view_base-tray_clamp_l.stl

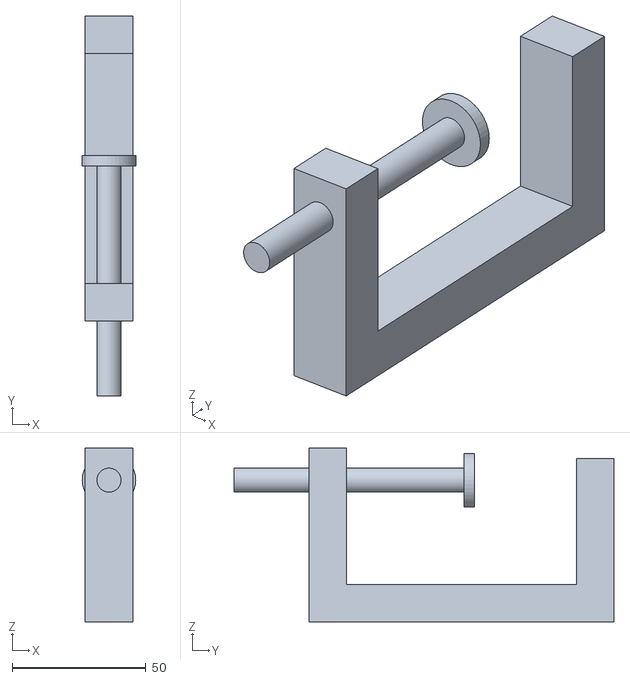
[picture p112: CAD file, 2026-10-13]
cad/stl/cover/_concepts_NOT_FOR_PRINTING/_view_base-tray_clamp_l.stl
20.0 x 142.0 x 65.0
