Pai-88/crank-charger/cad/stl/cover/_view_NOT_FOR_PRINTING/wire_lead1.stl

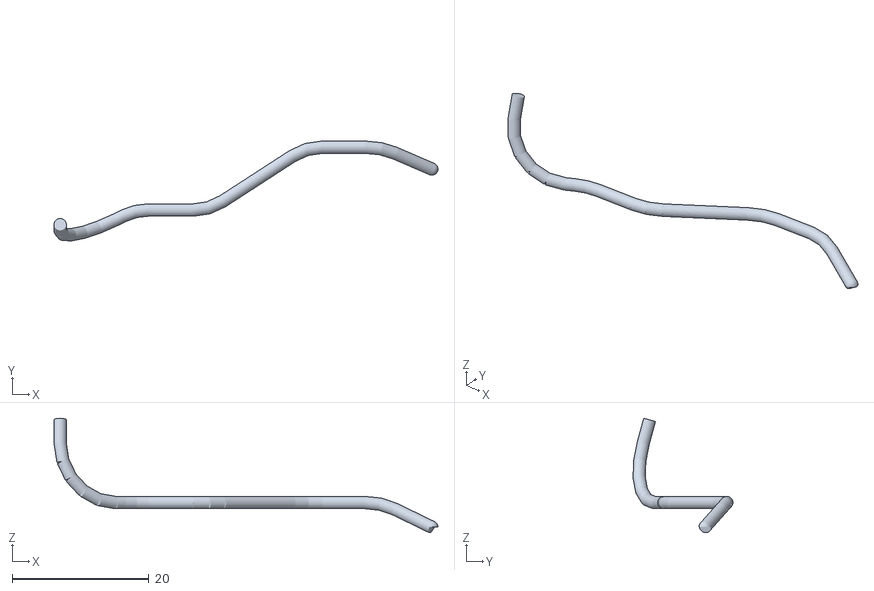
[picture p113: CAD file, 2026-10-13]
cad/stl/cover/_view_NOT_FOR_PRINTING/wire_lead1.stl
56.2 x 14.6 x 16.8
