Pai-88/crank-charger/cad/stl/spares/pin_spacer_x1.stl

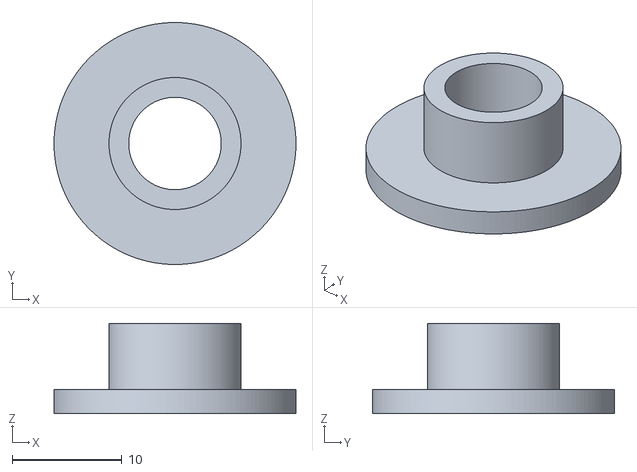
[picture p114: CAD file, 2026-10-13]
cad/stl/spares/pin_spacer_x1.stl
22.0 x 22.0 x 8.20
