Pai-88/crank-charger/cad/stl/cover/_concepts_NOT_FOR_PRINTING/_view_base-tray_clamp_r.stl

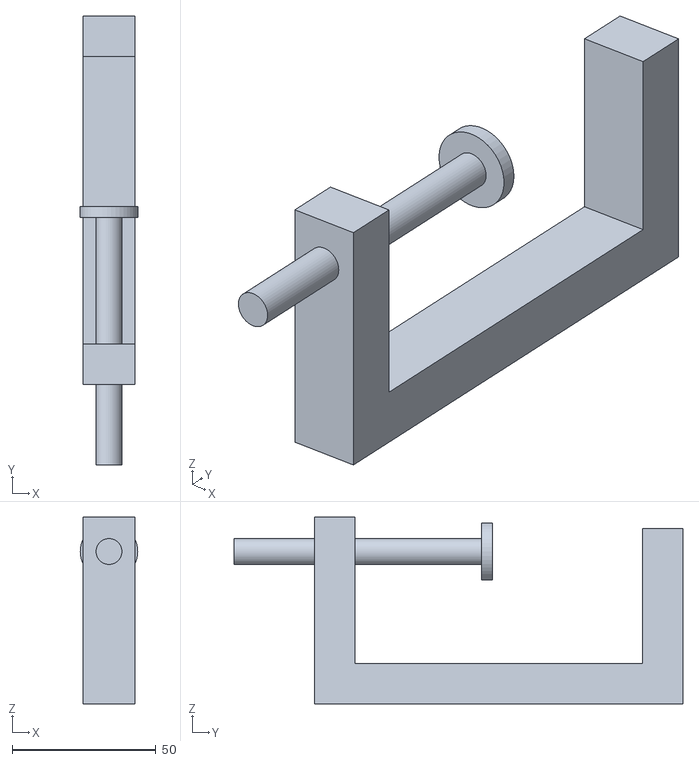
[picture p115: CAD file, 2026-10-13]
cad/stl/cover/_concepts_NOT_FOR_PRINTING/_view_base-tray_clamp_r.stl
20.0 x 156.0 x 65.0
