Pai-88/crank-charger/cad/stl/cover/_view_NOT_FOR_PRINTING/shell_pocket.stl

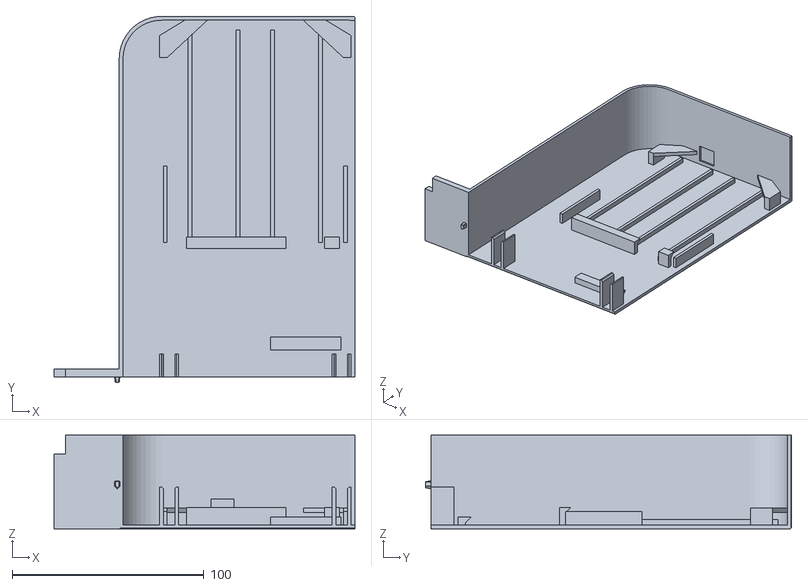
[picture p116: CAD file, 2026-10-13]
cad/stl/cover/_view_NOT_FOR_PRINTING/shell_pocket.stl
157.0 x 191.0 x 49.0
