Pai-88/crank-charger/cad/stl/cover/_concepts_NOT_FOR_PRINTING/_view_backpack_shell.stl

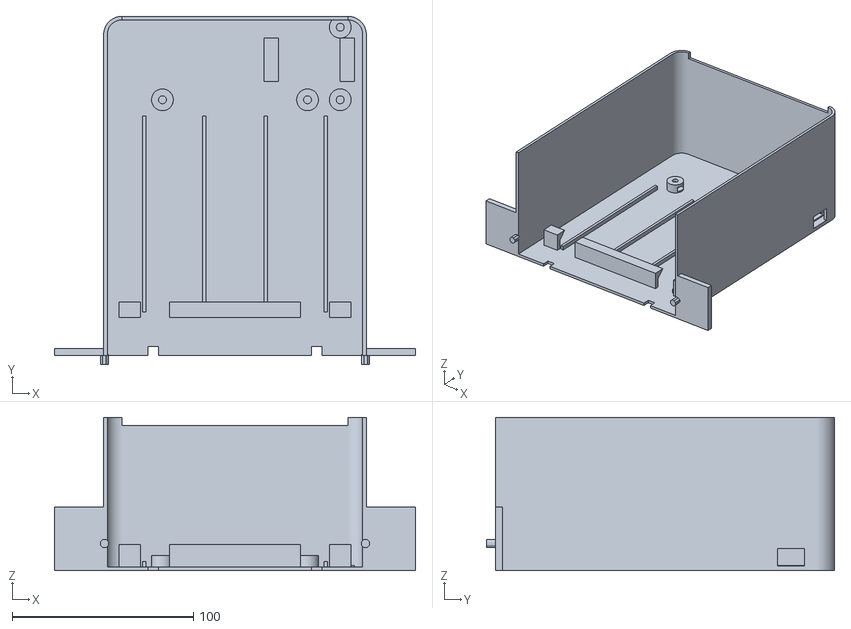
[picture p117: CAD file, 2026-10-13]
cad/stl/cover/_concepts_NOT_FOR_PRINTING/_view_backpack_shell.stl
199.0 x 192.0 x 84.6
