Pai-88/crank-charger/cad/stl/cover/_view_NOT_FOR_PRINTING/wire_tail_minus.stl

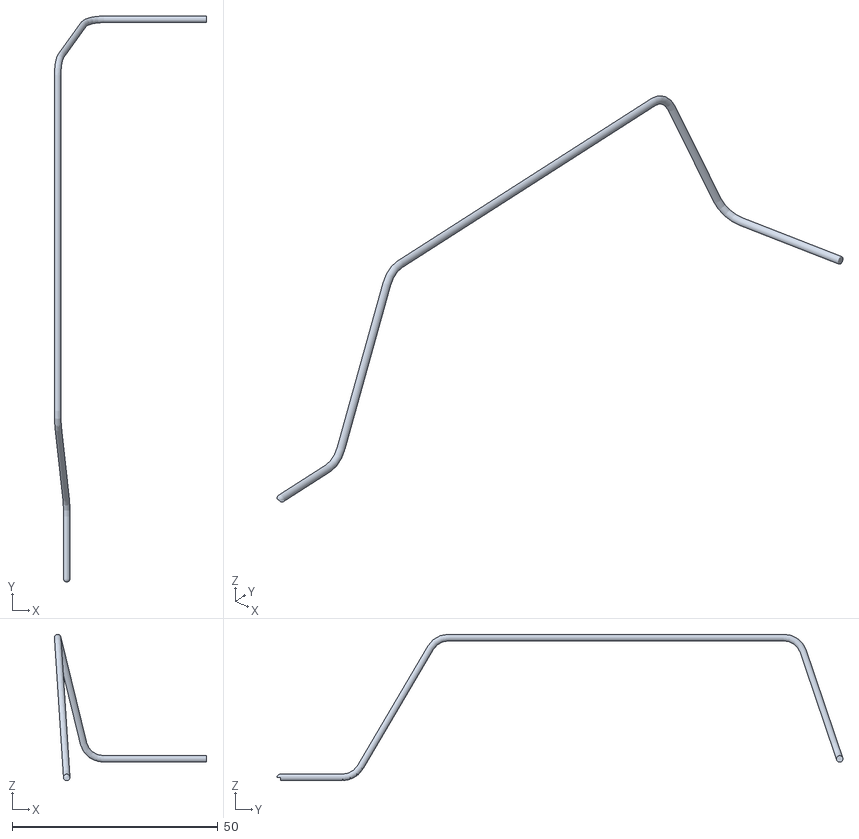
[picture p118: CAD file, 2026-10-13]
cad/stl/cover/_view_NOT_FOR_PRINTING/wire_tail_minus.stl
37.0 x 137.6 x 35.6
