Pai-88/crank-charger/cad/stl/cover/_concepts_NOT_FOR_PRINTING/_view_backpack_tester.stl

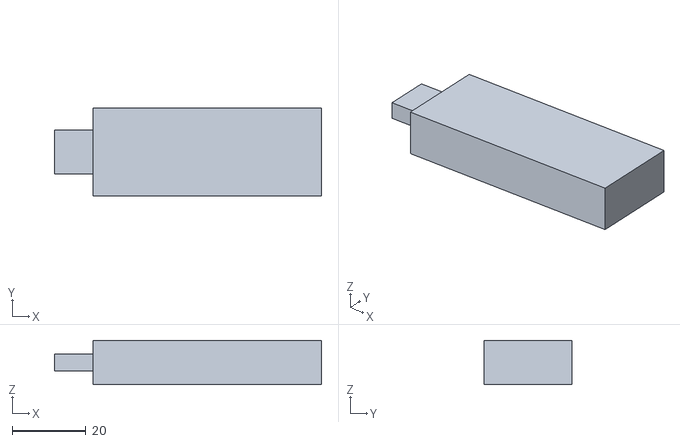
[picture p119: CAD file, 2026-10-13]
cad/stl/cover/_concepts_NOT_FOR_PRINTING/_view_backpack_tester.stl
72.5 x 24.0 x 12.0
