Pai-88/crank-charger/cad/stl/cover/_view_NOT_FOR_PRINTING/wire_out_plus.stl

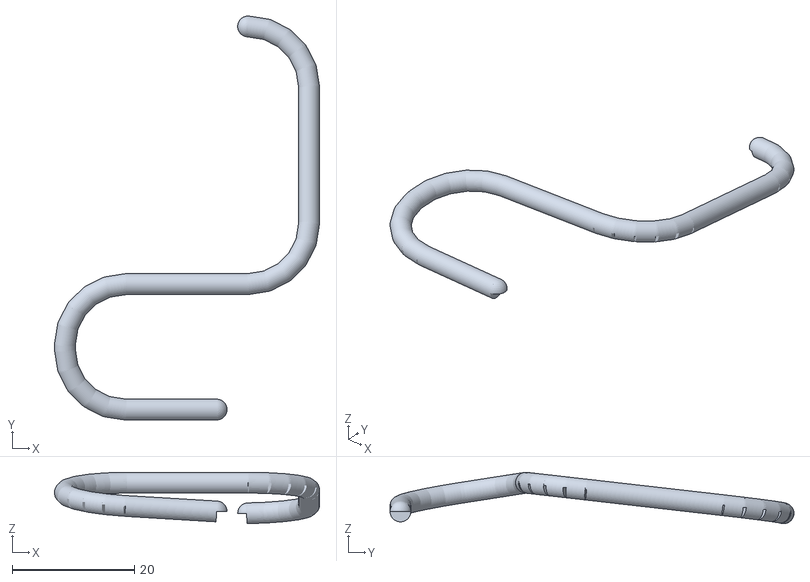
[picture p120: CAD file, 2026-10-13]
cad/stl/cover/_view_NOT_FOR_PRINTING/wire_out_plus.stl
43.3 x 66.0 x 8.40
