Pai-88/crank-charger/cad/stl/hub_spacer.stl

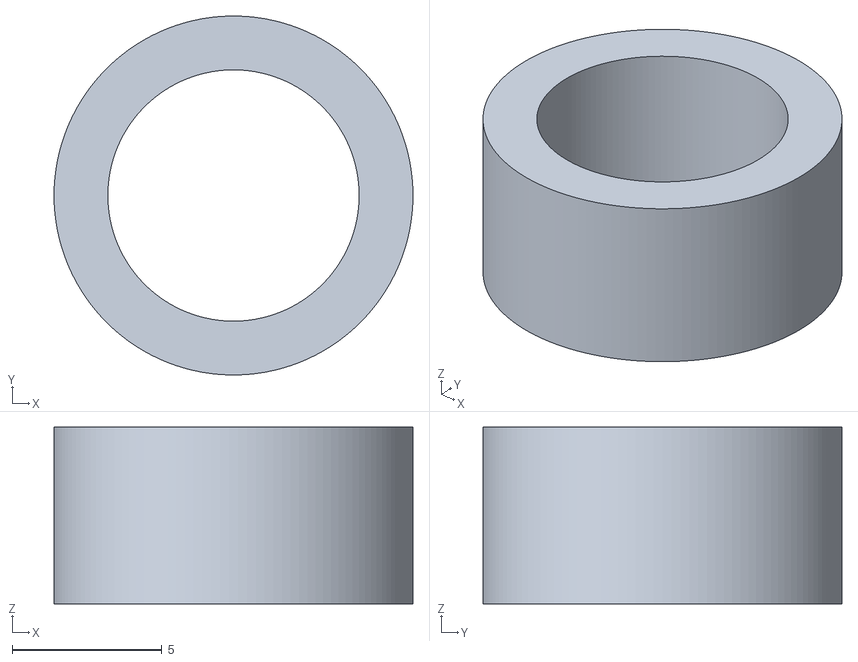
[picture p121: CAD file, 2026-10-13]
cad/stl/hub_spacer.stl
12.0 x 12.0 x 5.90
