Pai-88/crank-charger/cad/stl/cover/_concepts_NOT_FOR_PRINTING/_view_base-tray_channel.stl

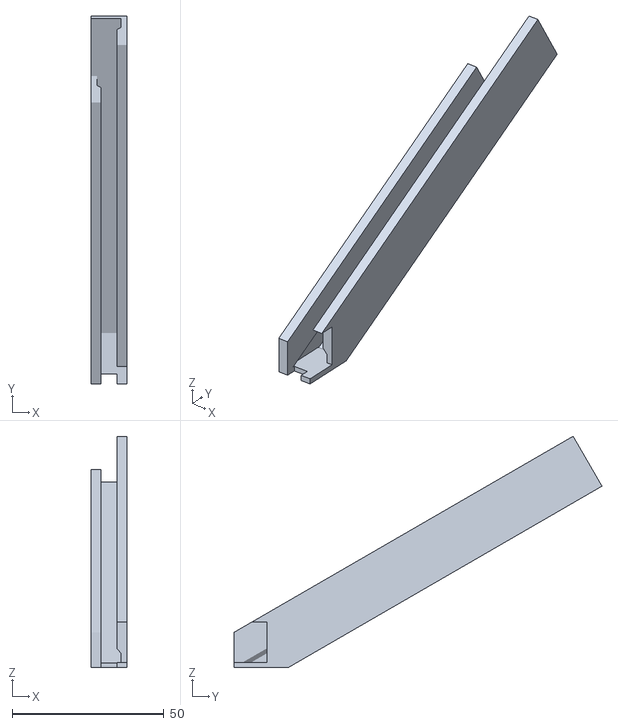
[picture p122: CAD file, 2026-10-13]
cad/stl/cover/_concepts_NOT_FOR_PRINTING/_view_base-tray_channel.stl
12.0 x 121.3 x 76.3
