Pai-88/crank-charger/cad/stl/cover/_view_NOT_FOR_PRINTING/card.stl

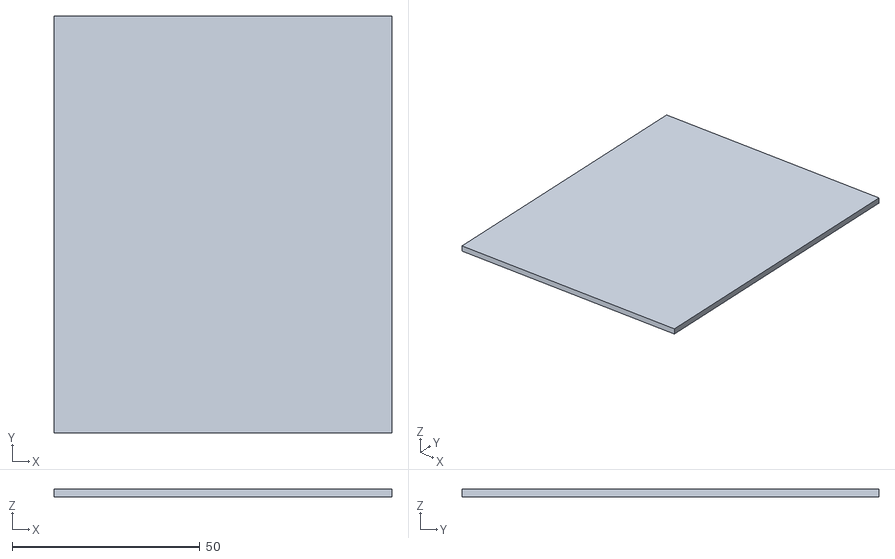
[picture p123: CAD file, 2026-10-13]
cad/stl/cover/_view_NOT_FOR_PRINTING/card.stl
90.0 x 111.0 x 2.00
