Pai-88/crank-charger/cad/stl/cover/_concepts_NOT_FOR_PRINTING/_view_base-tray_face_plate.stl

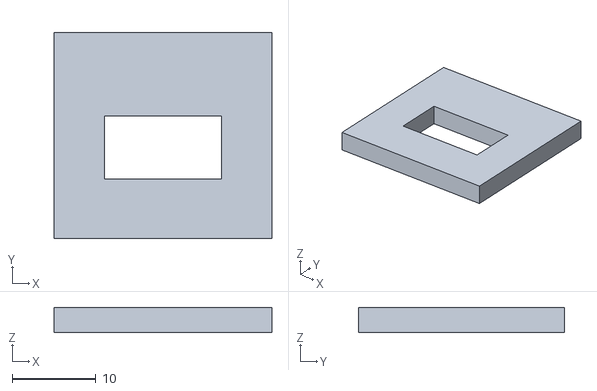
[picture p124: CAD file, 2026-10-13]
cad/stl/cover/_concepts_NOT_FOR_PRINTING/_view_base-tray_face_plate.stl
26.0 x 24.6 x 3.00
