Pai-88/crank-charger/cad/stl/_view_sun.stl

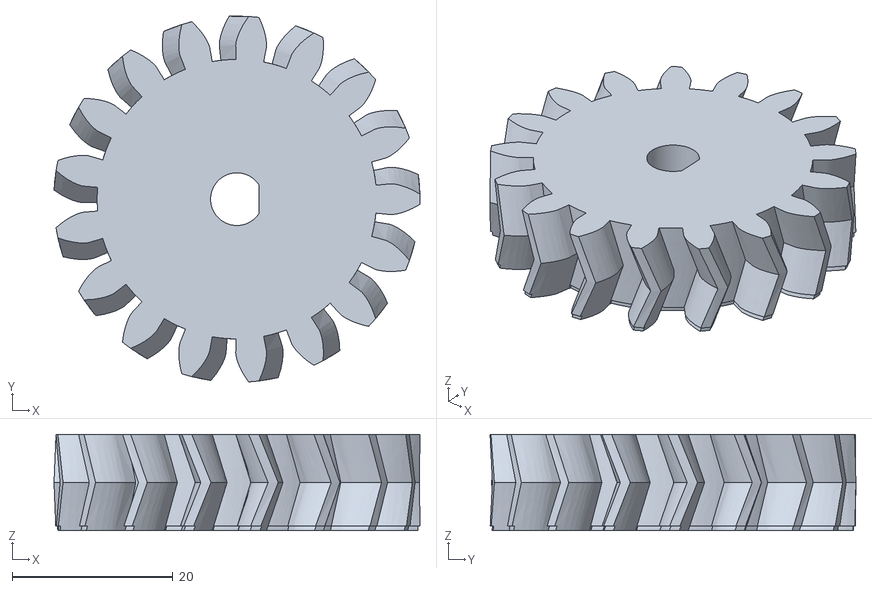
[picture p128: CAD file, 2026-10-13]
cad/stl/_view_sun.stl
45.6 x 45.6 x 12.0
