Pai-88/crank-charger/cad/stl/cover/_view_NOT_FOR_PRINTING/screen.stl

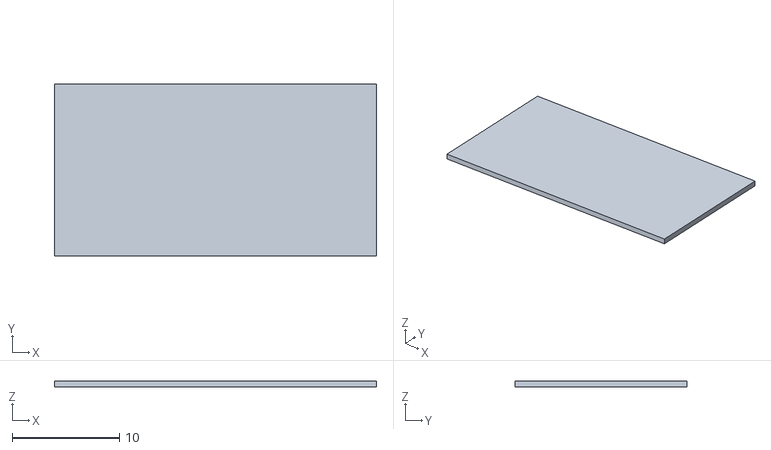
[picture p129: CAD file, 2026-10-13]
cad/stl/cover/_view_NOT_FOR_PRINTING/screen.stl
30.0 x 16.0 x 0.6
