Pai-88/crank-charger/cad/stl/cover/_concepts_NOT_FOR_PRINTING/_view_backpack_card.stl

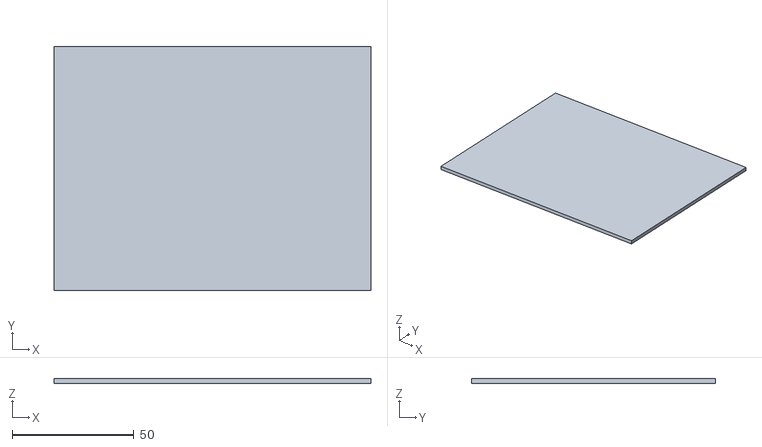
[picture p130: CAD file, 2026-10-13]
cad/stl/cover/_concepts_NOT_FOR_PRINTING/_view_backpack_card.stl
130.0 x 100.0 x 2.00
