Pai-88/crank-charger/cad/stl/cover/_view_NOT_FOR_PRINTING/table_-330_160_-260_260.stl

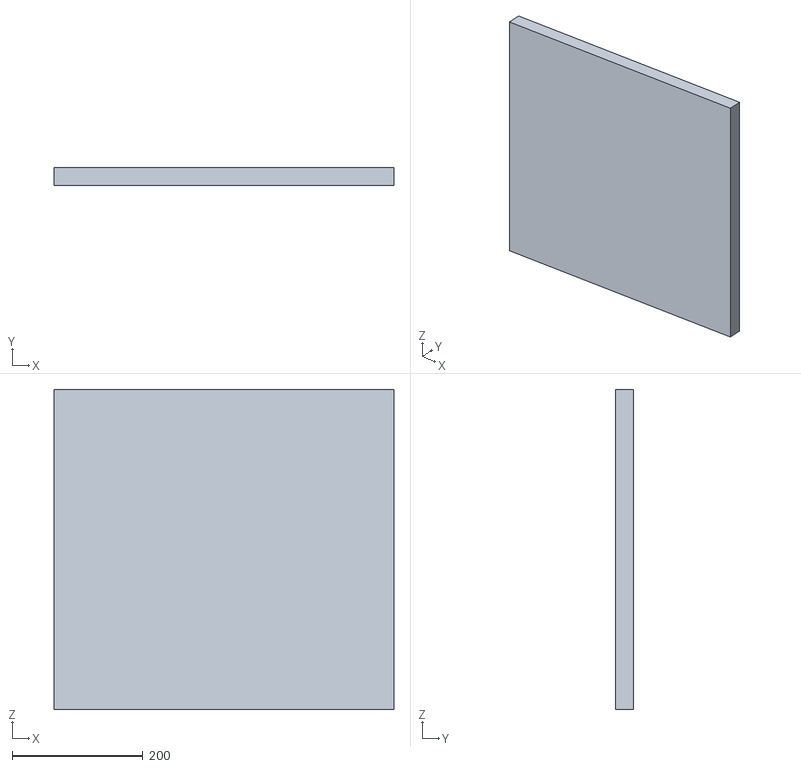
[picture p131: CAD file, 2026-10-13]
cad/stl/cover/_view_NOT_FOR_PRINTING/table_-330_160_-260_260.stl
520.0 x 28.0 x 490.0
