Pai-88/crank-charger/cad/stl/_split_ring_VIEW_ONLY.stl

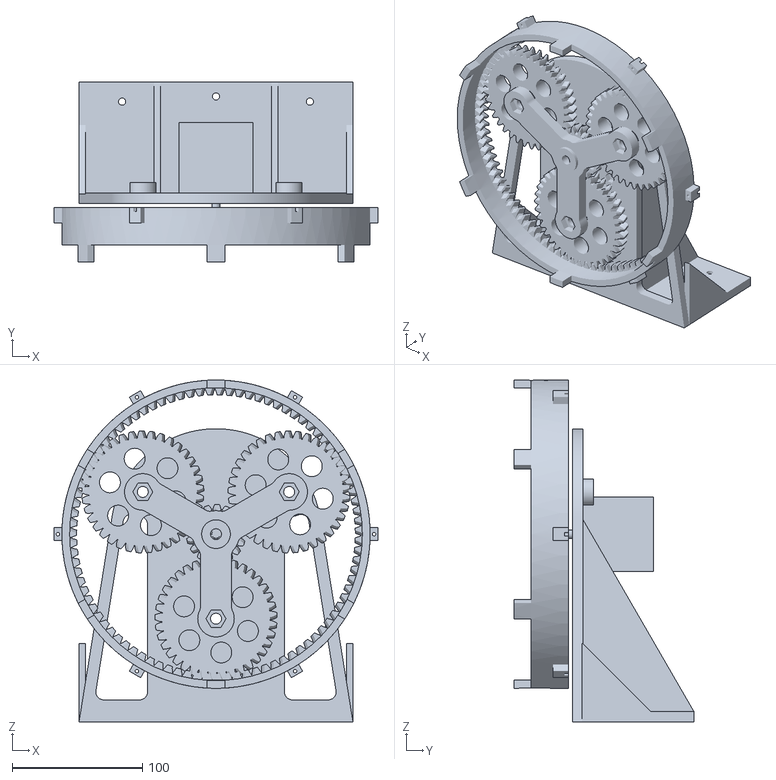
[picture p132: CAD file, 2026-10-13]
cad/stl/_split_ring_VIEW_ONLY.stl
248.4 x 137.9 x 262.2
