Pai-88/crank-charger/cad/stl/_inner_VIEW_ONLY.stl

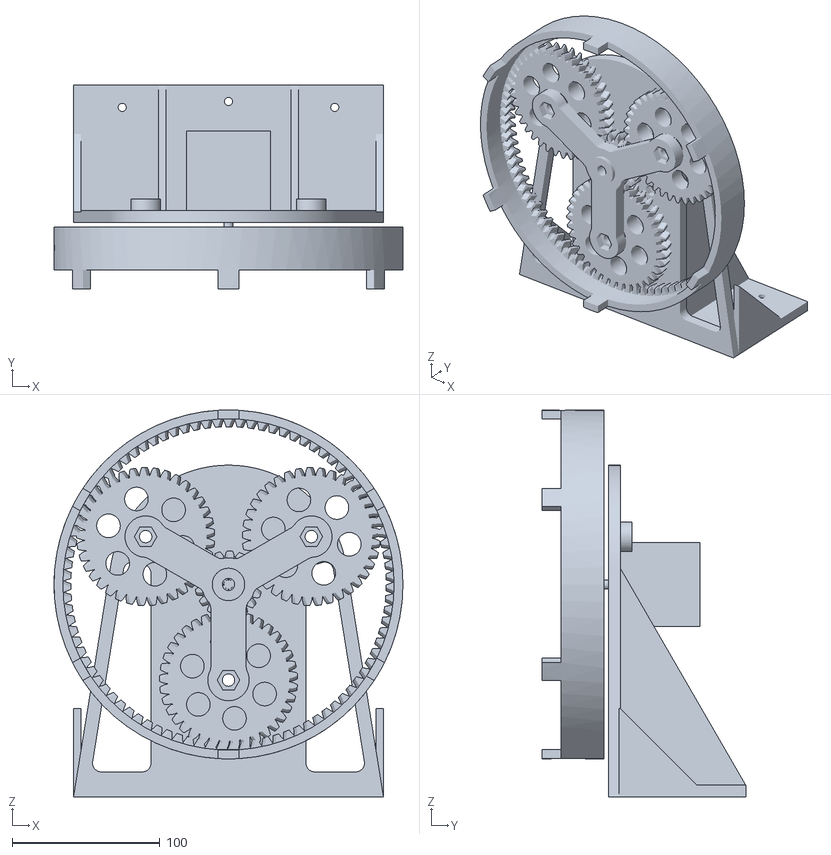
[picture p135: CAD file, 2026-10-13]
cad/stl/_inner_VIEW_ONLY.stl
236.4 x 137.9 x 262.2
