Pai-88/crank-charger/cad/stl/cover/_view_NOT_FOR_PRINTING/wire_out_minus.stl

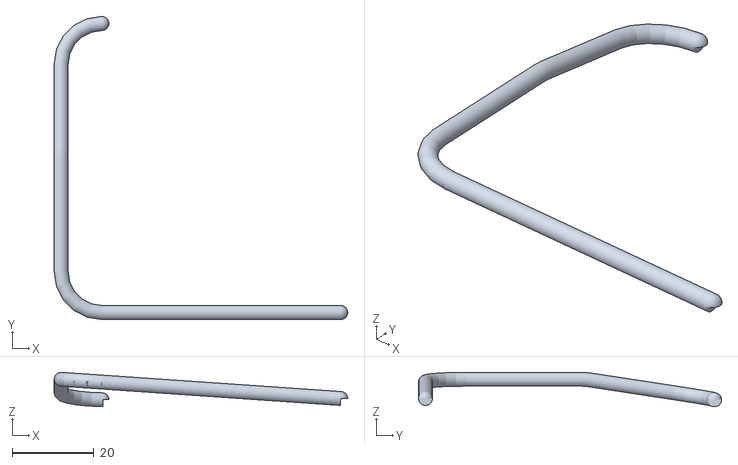
[picture p136: CAD file, 2026-10-13]
cad/stl/cover/_view_NOT_FOR_PRINTING/wire_out_minus.stl
71.7 x 74.0 x 8.40
