Pai-88/crank-charger/cad/stl/_view_motor.stl

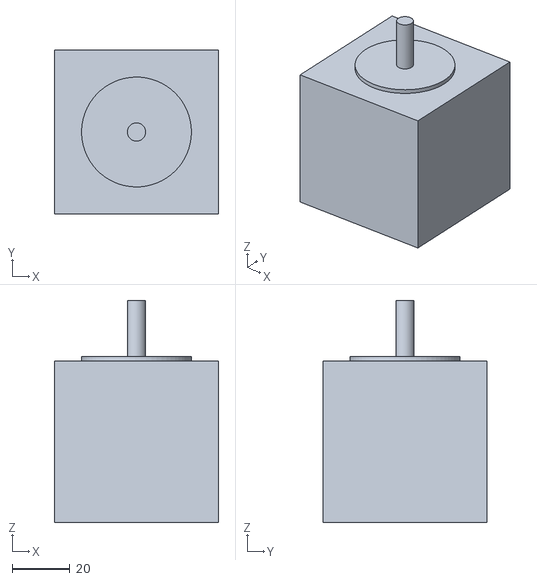
[picture p137: CAD file, 2026-10-13]
cad/stl/_view_motor.stl
57.0 x 57.0 x 77.0
