Pai-88/crank-charger/cad/stl/cover/_view_NOT_FOR_PRINTING/coilpose_bundle.stl

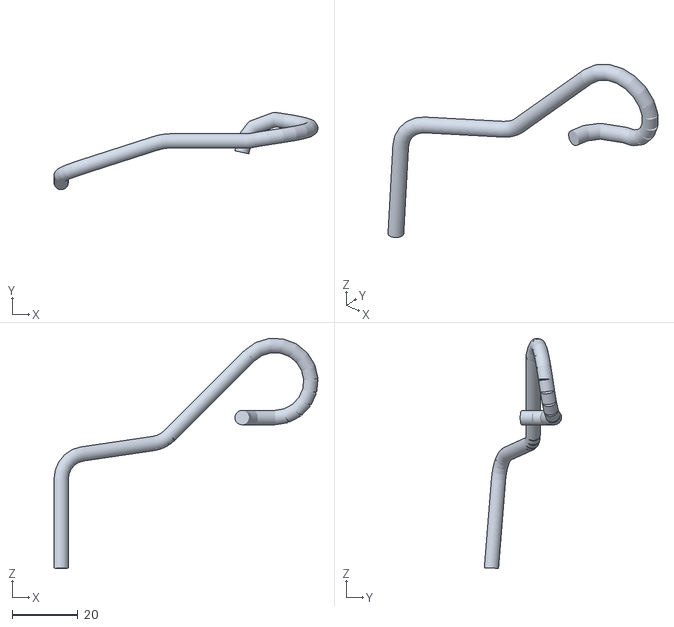
[picture p139: CAD file, 2026-10-13]
cad/stl/cover/_view_NOT_FOR_PRINTING/coilpose_bundle.stl
80.3 x 23.5 x 70.0
