Pai-88/crank-charger/cad/stl/cover/_concepts_NOT_FOR_PRINTING/_view_minimal_tester_screen.stl

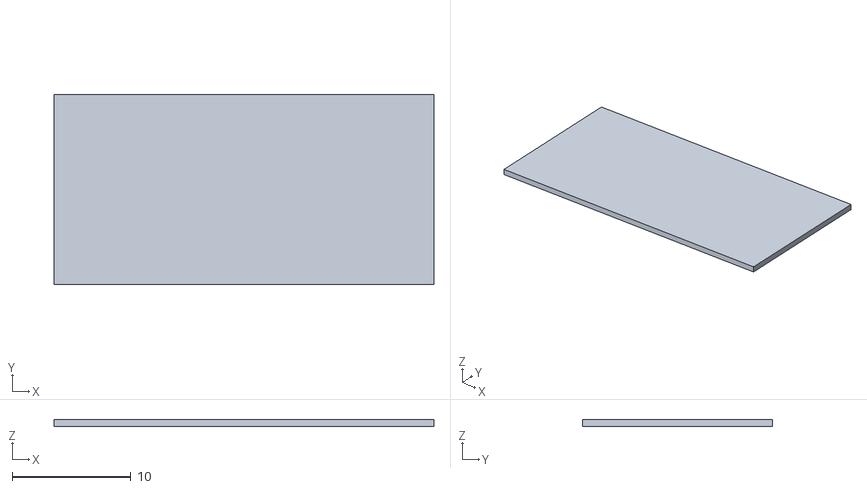
[picture p140: CAD file, 2026-10-13]
cad/stl/cover/_concepts_NOT_FOR_PRINTING/_view_minimal_tester_screen.stl
32.0 x 16.0 x 0.6
