Pai-88/crank-charger/cad/stl/cover/_concepts_NOT_FOR_PRINTING/_view_minimal_hood.stl

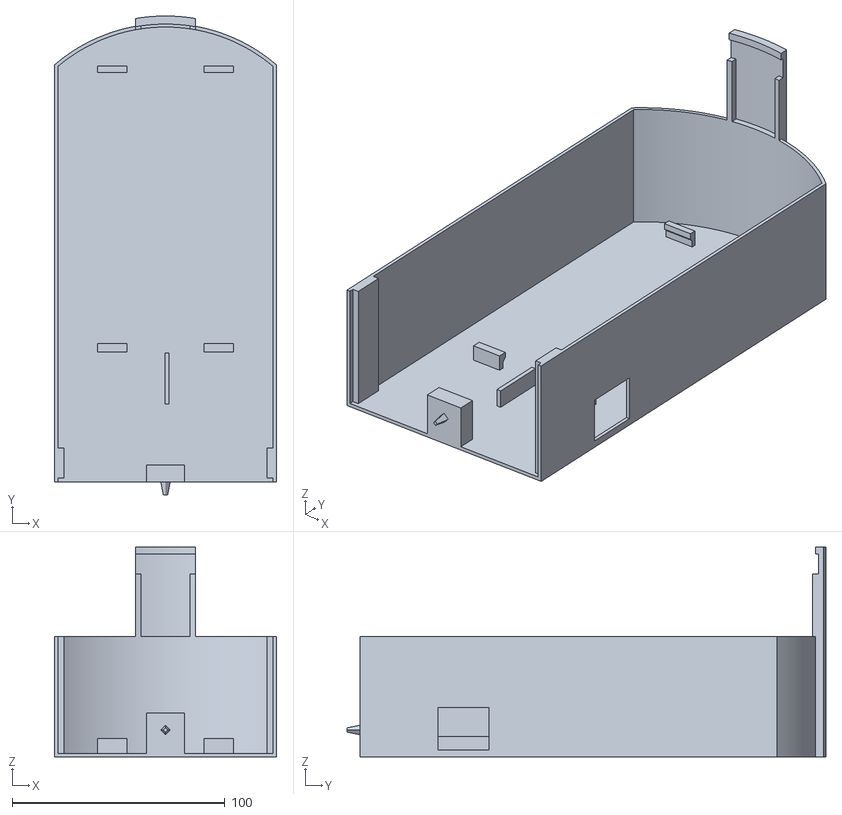
[picture p142: CAD file, 2026-10-13]
cad/stl/cover/_concepts_NOT_FOR_PRINTING/_view_minimal_hood.stl
104.6 x 225.4 x 98.6
