Pai-88/crank-charger/cad/stl/coupon_pair_print_in_place.stl

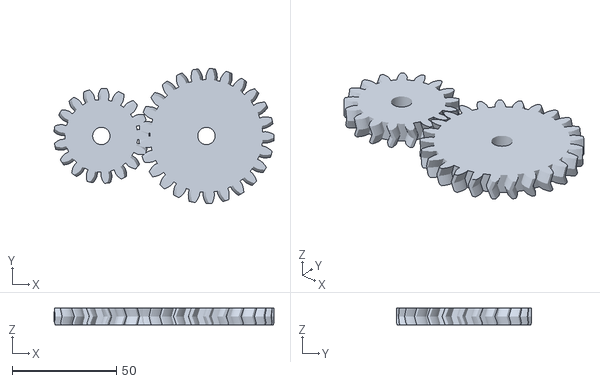
[picture p144: CAD file, 2026-10-13]
cad/stl/coupon_pair_print_in_place.stl
105.5 x 64.8 x 8.00
