Pai-88/crank-charger/cad/stl/cover/_view_NOT_FOR_PRINTING/wire_lead3.stl

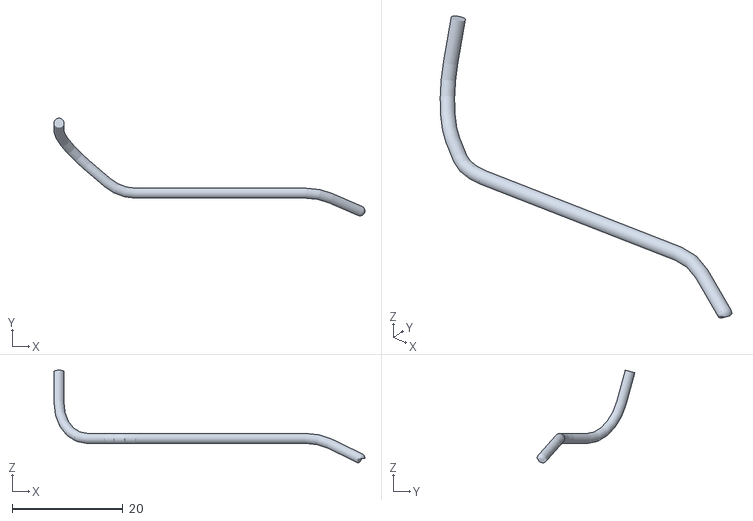
[picture p146: CAD file, 2026-10-13]
cad/stl/cover/_view_NOT_FOR_PRINTING/wire_lead3.stl
56.2 x 17.7 x 16.8
