Pai-88/crank-charger/cad/stl/cover/_view_NOT_FOR_PRINTING/plug.stl

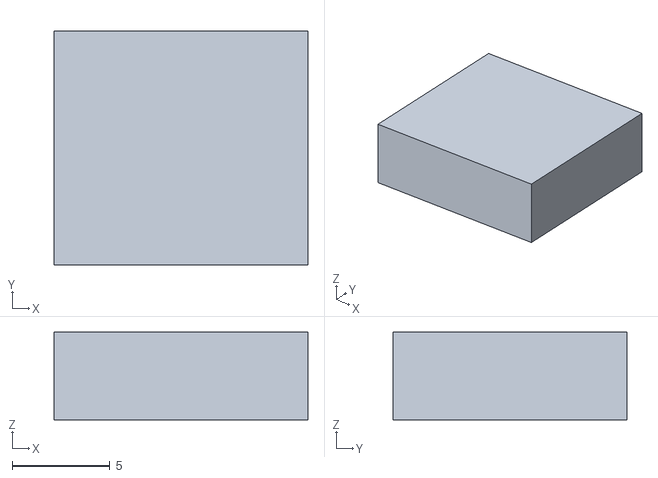
[picture p148: CAD file, 2026-10-13]
cad/stl/cover/_view_NOT_FOR_PRINTING/plug.stl
13.0 x 12.0 x 4.50
