Pai-88/crank-charger/cad/stl/_view_ring.stl

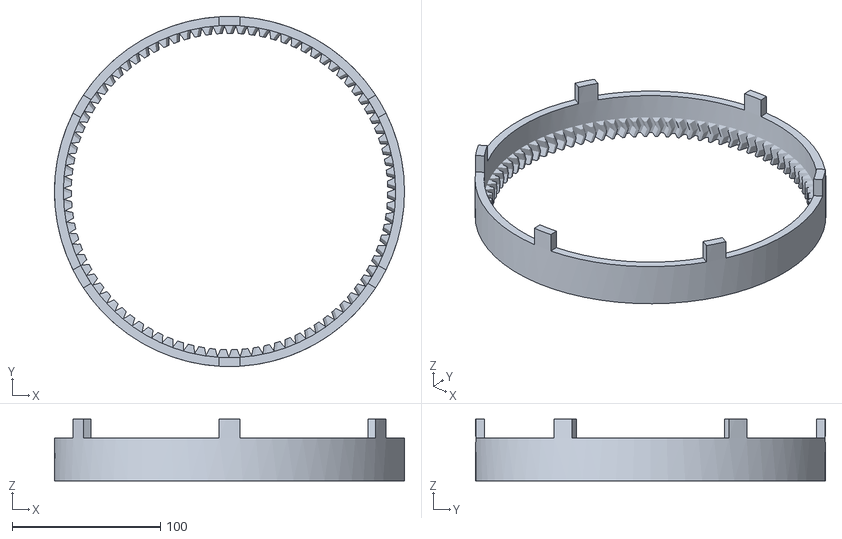
[picture p149: CAD file, 2026-10-13]
cad/stl/_view_ring.stl
236.4 x 236.4 x 41.7
