Pai-88/crank-charger/cad/stl/cover/_view_NOT_FOR_PRINTING/wire_slack.stl

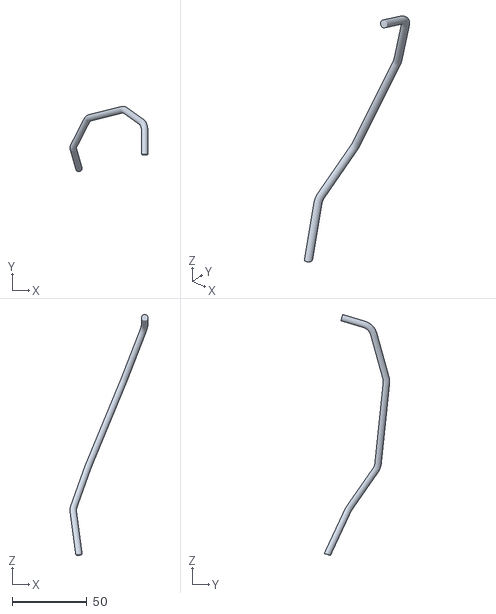
[picture p151: CAD file, 2026-10-13]
cad/stl/cover/_view_NOT_FOR_PRINTING/wire_slack.stl
52.2 x 43.7 x 161.0
