Pai-88/crank-charger/cad/stl/cover/_view_NOT_FOR_PRINTING/shell_corner.stl

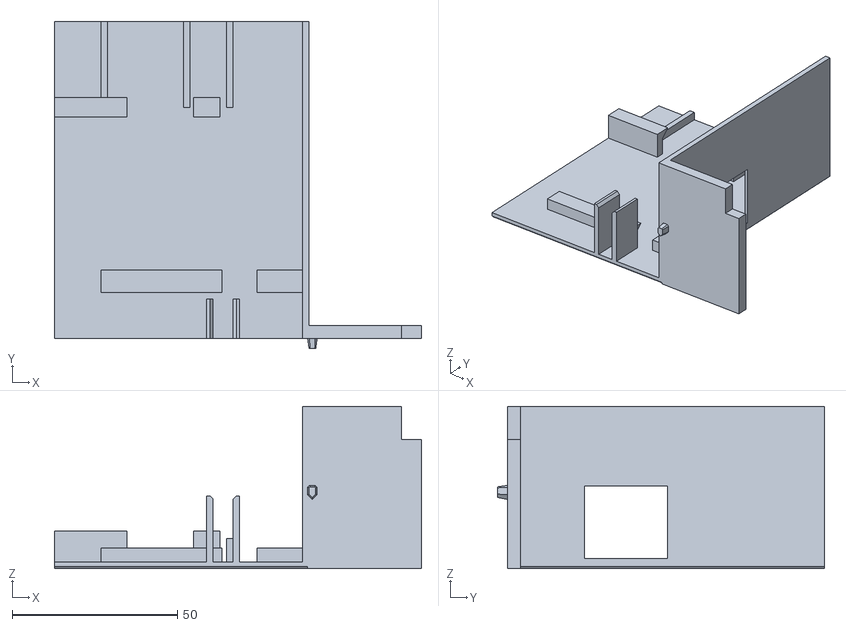
[picture p153: CAD file, 2026-10-13]
cad/stl/cover/_view_NOT_FOR_PRINTING/shell_corner.stl
111.0 x 99.0 x 49.0
