Pai-88/crank-charger/cad/stl/cover/_view_NOT_FOR_PRINTING/wire_bundle.stl

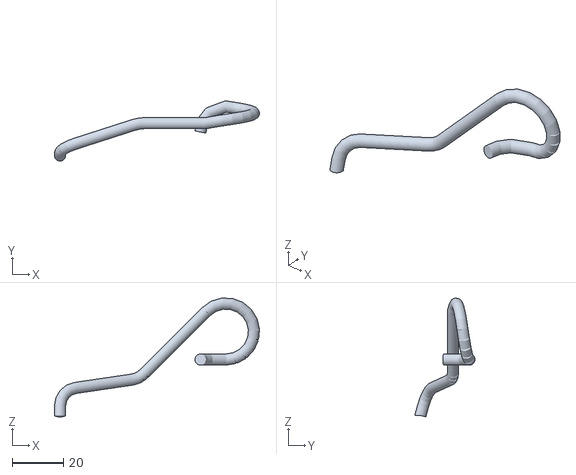
[picture p155: CAD file, 2026-10-13]
cad/stl/cover/_view_NOT_FOR_PRINTING/wire_bundle.stl
80.3 x 23.5 x 46.6
