Pai-88/crank-charger/cad/stl/cover/_view_NOT_FOR_PRINTING/pcb.stl

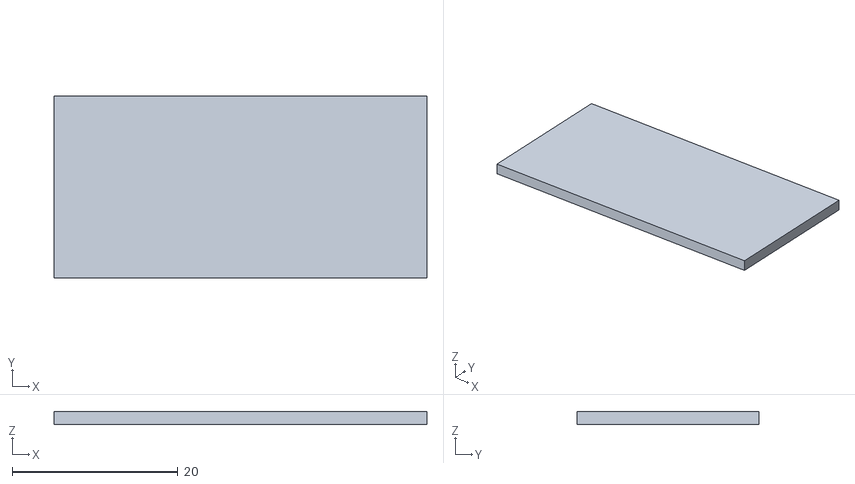
[picture p158: CAD file, 2026-10-13]
cad/stl/cover/_view_NOT_FOR_PRINTING/pcb.stl
45.0 x 22.0 x 1.60
