Pai-88/crank-charger/cad/stl/cover/_concepts_NOT_FOR_PRINTING/_view_minimal_pin_nuts.stl

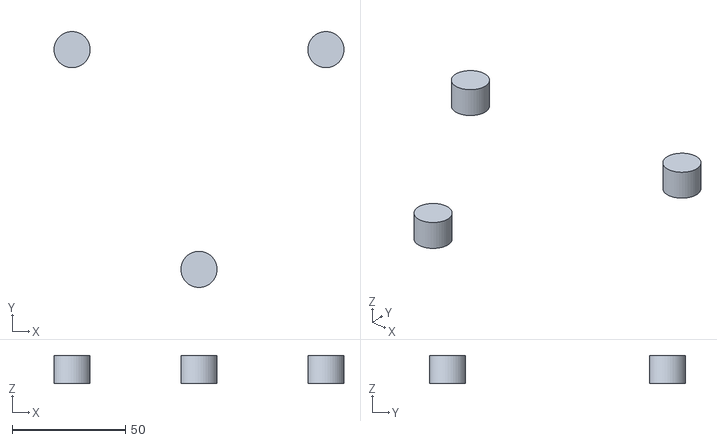
[picture p159: CAD file, 2026-10-13]
cad/stl/cover/_concepts_NOT_FOR_PRINTING/_view_minimal_pin_nuts.stl
128.2 x 113.2 x 12.5
