Pai-88/crank-charger/cad/stl/cover/_view_NOT_FOR_PRINTING/shell_back.stl

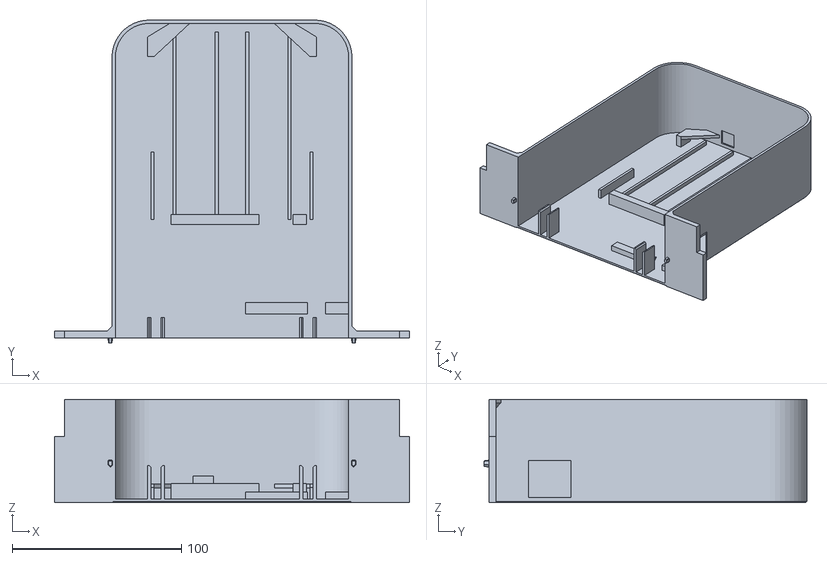
[picture p160: CAD file, 2026-10-13]
cad/stl/cover/_view_NOT_FOR_PRINTING/shell_back.stl
210.0 x 191.0 x 61.0
