Pai-88/crank-charger/cad/stl/cover/_view_NOT_FOR_PRINTING/cardparts.stl

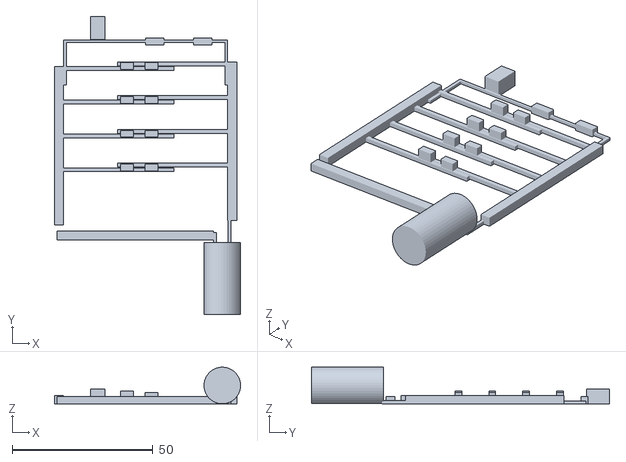
[picture p161: CAD file, 2026-10-13]
cad/stl/cover/_view_NOT_FOR_PRINTING/cardparts.stl
66.1 x 105.8 x 13.0
