Pai-88/crank-charger/cad/stl/cover/_concepts_NOT_FOR_PRINTING/concept_backpack_small_parts.stl

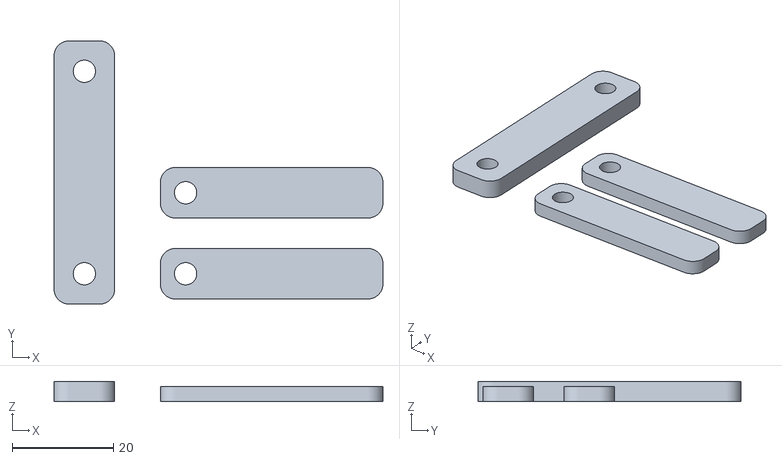
[picture p162: CAD file, 2026-10-13]
cad/stl/cover/_concepts_NOT_FOR_PRINTING/concept_backpack_small_parts.stl
65.0 x 52.0 x 4.00
