Pai-88/crank-charger/cad/stl/cover/_view_NOT_FOR_PRINTING/wire_measure.stl

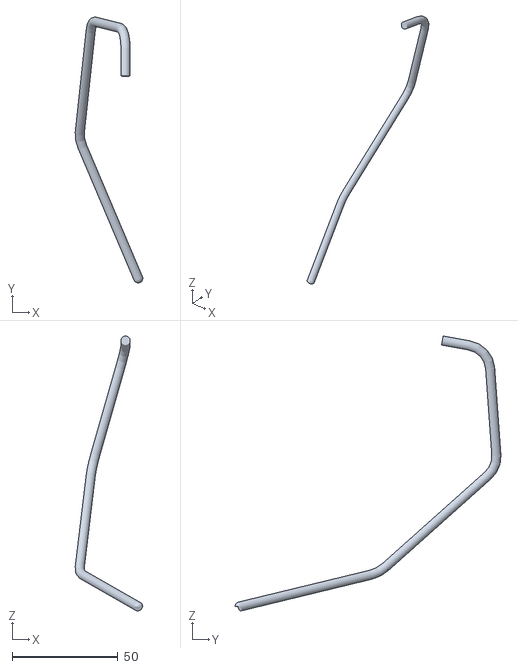
[picture p163: CAD file, 2026-10-13]
cad/stl/cover/_view_NOT_FOR_PRINTING/wire_measure.stl
32.0 x 125.9 x 130.3
