Pai-88/crank-charger/cad/stl/cover/_view_NOT_FOR_PRINTING/tester.stl

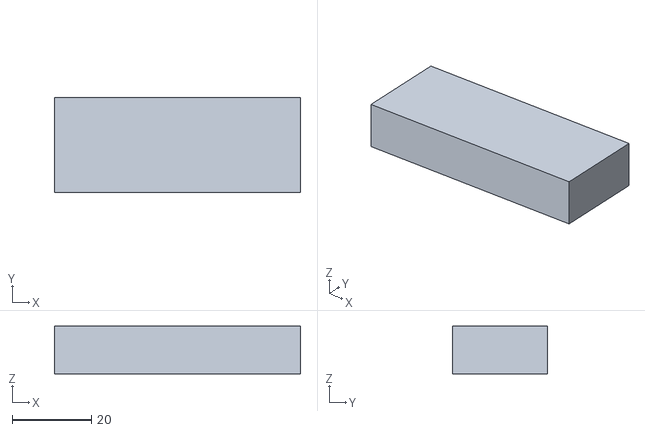
[picture p164: CAD file, 2026-10-13]
cad/stl/cover/_view_NOT_FOR_PRINTING/tester.stl
62.0 x 24.0 x 12.0
