Pai-88/crank-charger/cad/stl/cover/_view_NOT_FOR_PRINTING/coilpose_lead4.stl

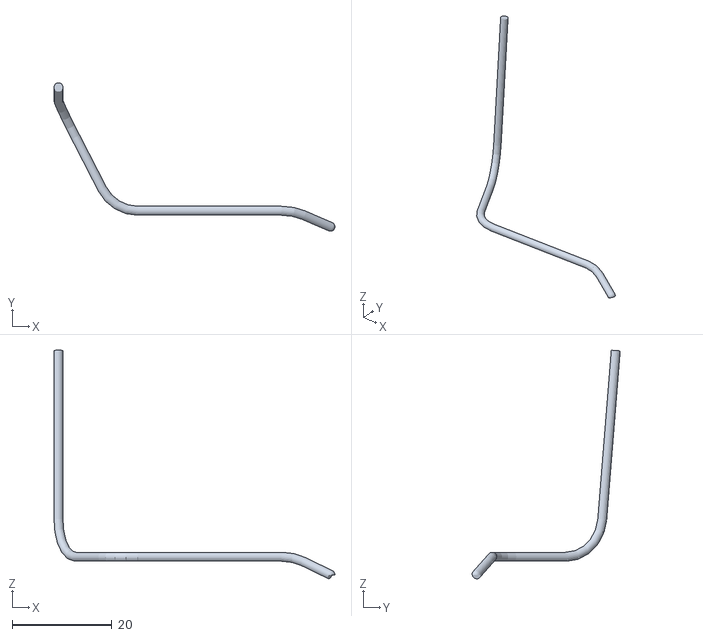
[picture p165: CAD file, 2026-10-13]
cad/stl/cover/_view_NOT_FOR_PRINTING/coilpose_lead4.stl
56.2 x 29.7 x 45.7
