Pai-88/crank-charger/cad/stl/cover/_view_NOT_FOR_PRINTING/diodes.stl

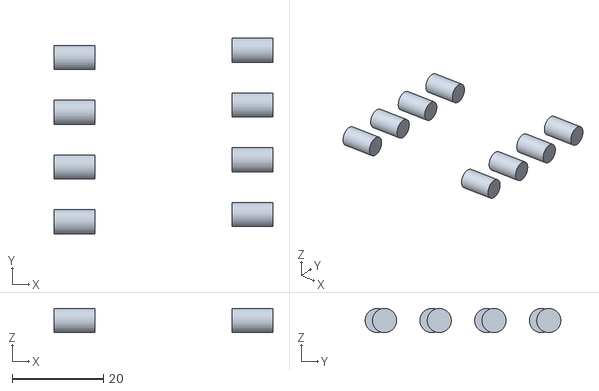
[picture p167: CAD file, 2026-10-13]
cad/stl/cover/_view_NOT_FOR_PRINTING/diodes.stl
48.0 x 42.9 x 5.29
