Pai-88/crank-charger/cad/stl/cover/_view_NOT_FOR_PRINTING/table_-93.0_200_-260_260.stl

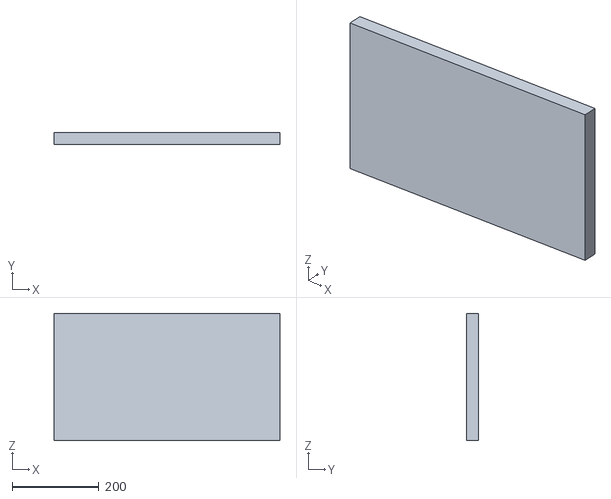
[picture p169: CAD file, 2026-10-13]
cad/stl/cover/_view_NOT_FOR_PRINTING/table_-93.0_200_-260_260.stl
520.0 x 28.0 x 293.0
