Pai-88/crank-charger/cad/stl/cover/_view_NOT_FOR_PRINTING/thin_book.stl

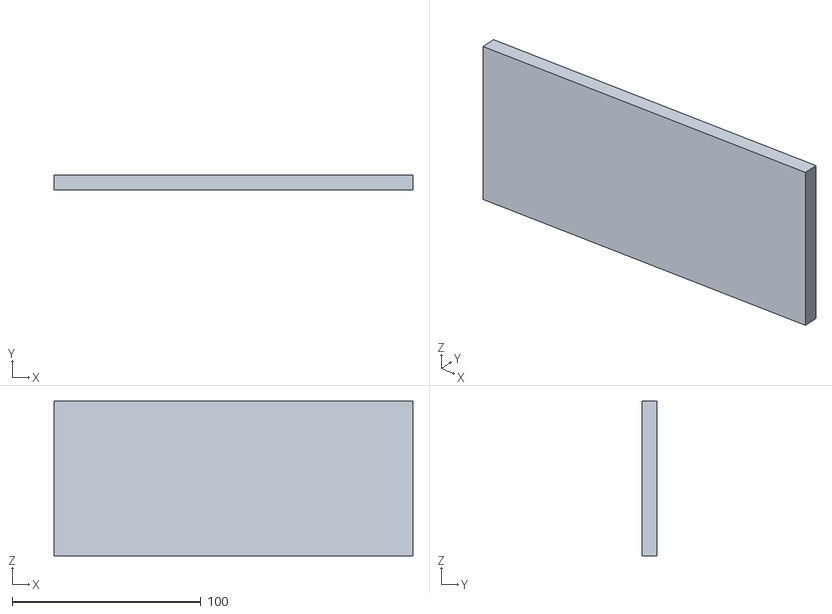
[picture p171: CAD file, 2026-10-13]
cad/stl/cover/_view_NOT_FOR_PRINTING/thin_book.stl
190.0 x 8.00 x 82.0
