Pai-88/crank-charger/cad/stl/cover/_view_NOT_FOR_PRINTING/coilpose_lead1.stl

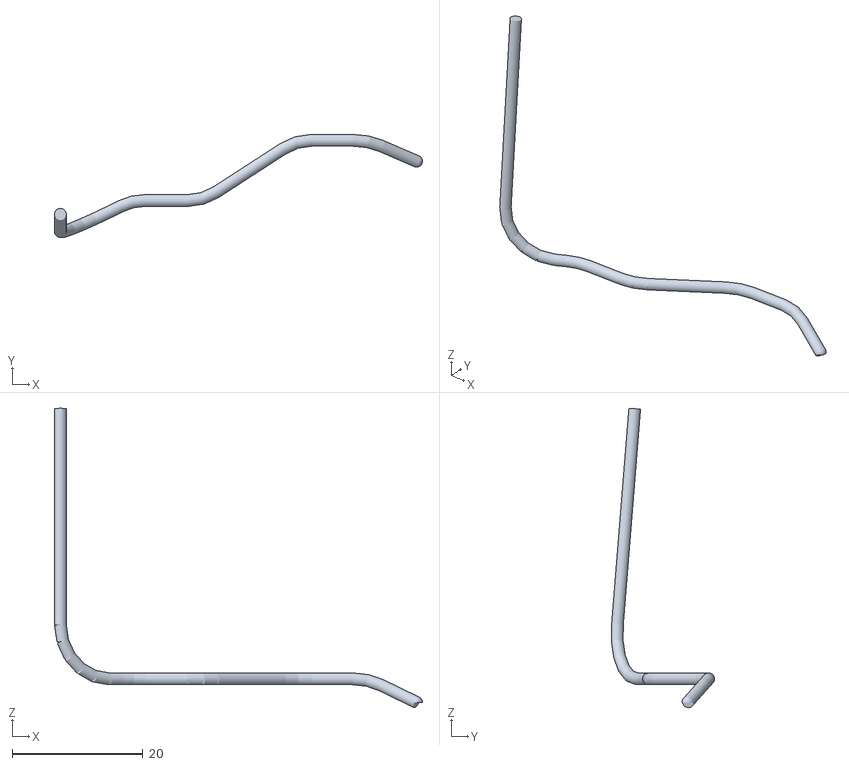
[picture p174: CAD file, 2026-10-13]
cad/stl/cover/_view_NOT_FOR_PRINTING/coilpose_lead1.stl
56.2 x 15.8 x 45.7
