Pai-88/crank-charger/cad/stl/cover/_view_NOT_FOR_PRINTING/tape.stl

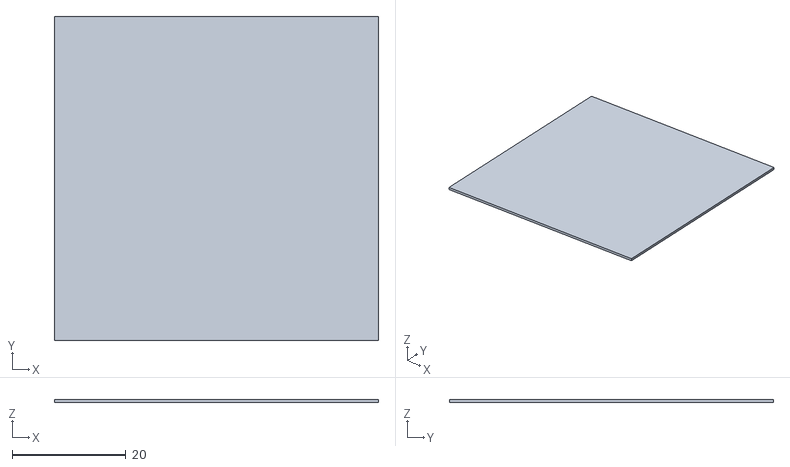
[picture p176: CAD file, 2026-10-13]
cad/stl/cover/_view_NOT_FOR_PRINTING/tape.stl
57.0 x 57.0 x 0.6
