Pai-88/crank-charger/cad/stl/cover/_view_NOT_FOR_PRINTING/shell_open.stl

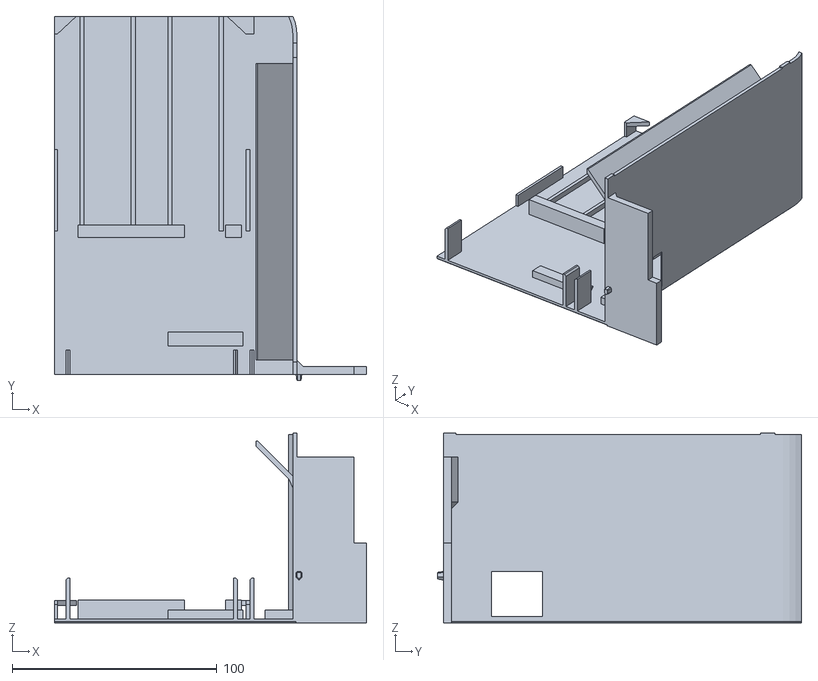
[picture p178: CAD file, 2026-10-13]
cad/stl/cover/_view_NOT_FOR_PRINTING/shell_open.stl
152.5 x 178.0 x 92.8
