Pai-88/crank-charger/(list of files, cad)

Other CAD files:
cad/stl/ring_rear_half.stl
cad/stl/batches/plate3_wheel.stl
cad/stl/frame.stl
cad/stl/_view_planet2.stl
cad/stl/_view_ring_rear_half.stl
cad/stl/_view_grip.stl
cad/stl/_view_planet3.stl
cad/stl/cover/_view_NOT_FOR_PRINTING/clamp_l.stl
cad/stl/cover/_concepts_NOT_FOR_PRINTING/concept_backpack.stl
cad/stl/_view_ring_front_half.stl
cad/stl/cover/_concepts_NOT_FOR_PRINTING/concept_minimal_sled.stl
cad/stl/cover/_concepts_NOT_FOR_PRINTING/_view_backpack_clamp_r.stl
cad/stl/_view_frame.stl
cad/stl/ring_front_half.stl
cad/stl/gearset_print_in_place.stl
cad/stl/pin_spacer_x3.stl
cad/stl/cover/_view_NOT_FOR_PRINTING/sled.stl
cad/stl/wheel.stl
cad/stl/cover/_concepts_NOT_FOR_PRINTING/_view_minimal_clamp_r.stl
cad/stl/cover/_view_NOT_FOR_PRINTING/wire_tail_plus.stl
cad/stl/spider.stl
cad/stl/cover/_concepts_NOT_FOR_PRINTING/concept_minimal.stl
cad/stl/cover/_concepts_NOT_FOR_PRINTING/_view_minimal_card.stl
cad/stl/cover/_view_NOT_FOR_PRINTING/shell.stl
cad/stl/cover/_concepts_NOT_FOR_PRINTING/_view_backpack_toggle2.stl
cad/old_spur_stage/frame.stl
cad/old_spur_stage/grip.stl
cad/old_spur_stage/pinion_20T.stl
cad/old_spur_stage/wheel_97T.stl
cad/stl/batches/plate5_washers.stl
cad/stl/cover/_concepts_NOT_FOR_PRINTING/_view_backpack_bolts.stl
cad/stl/washer_m6_penny.stl
cad/stl/washer_m8.stl
