Pai-88/crank-charger/assembly/phone/step_01_phone.png

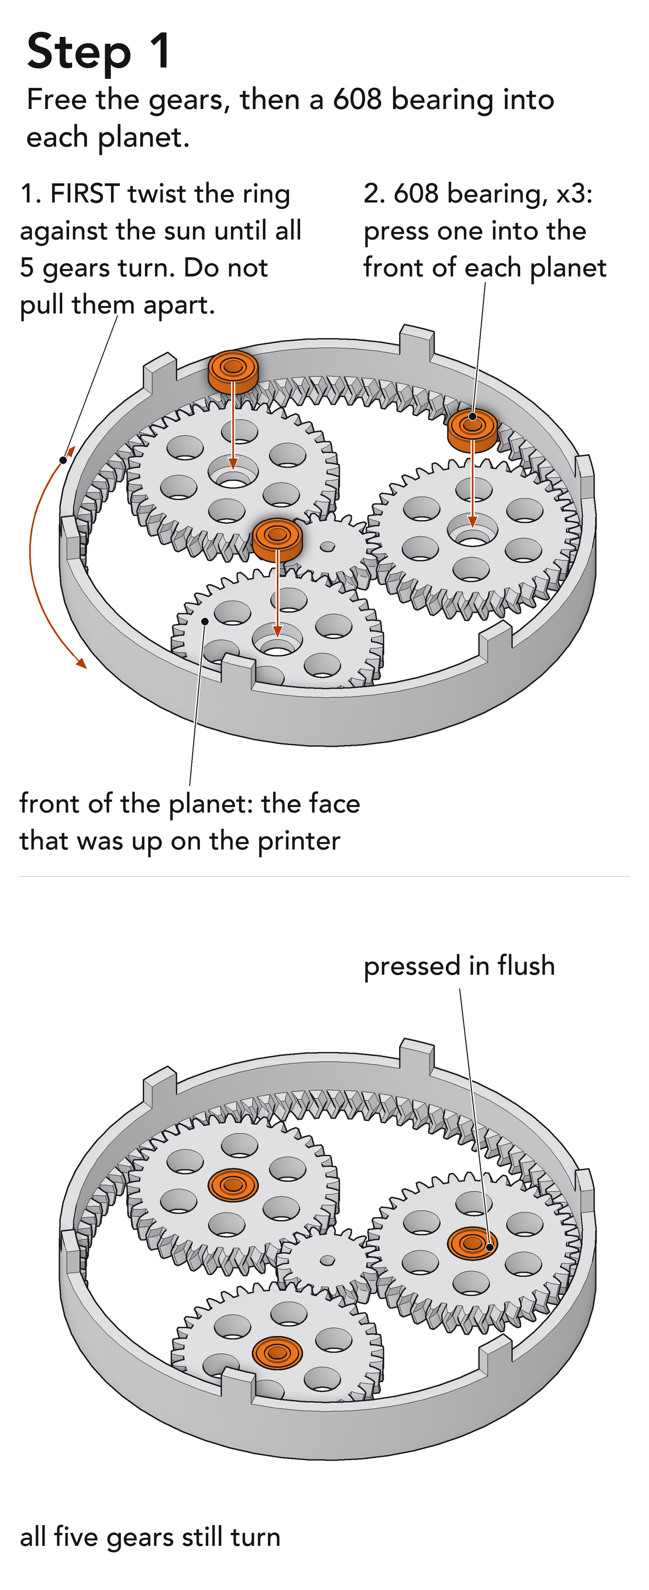
assembly/phone/step_01_phone.png
