Pai-88/crank-charger/assembly/phone/step_02_phone.png

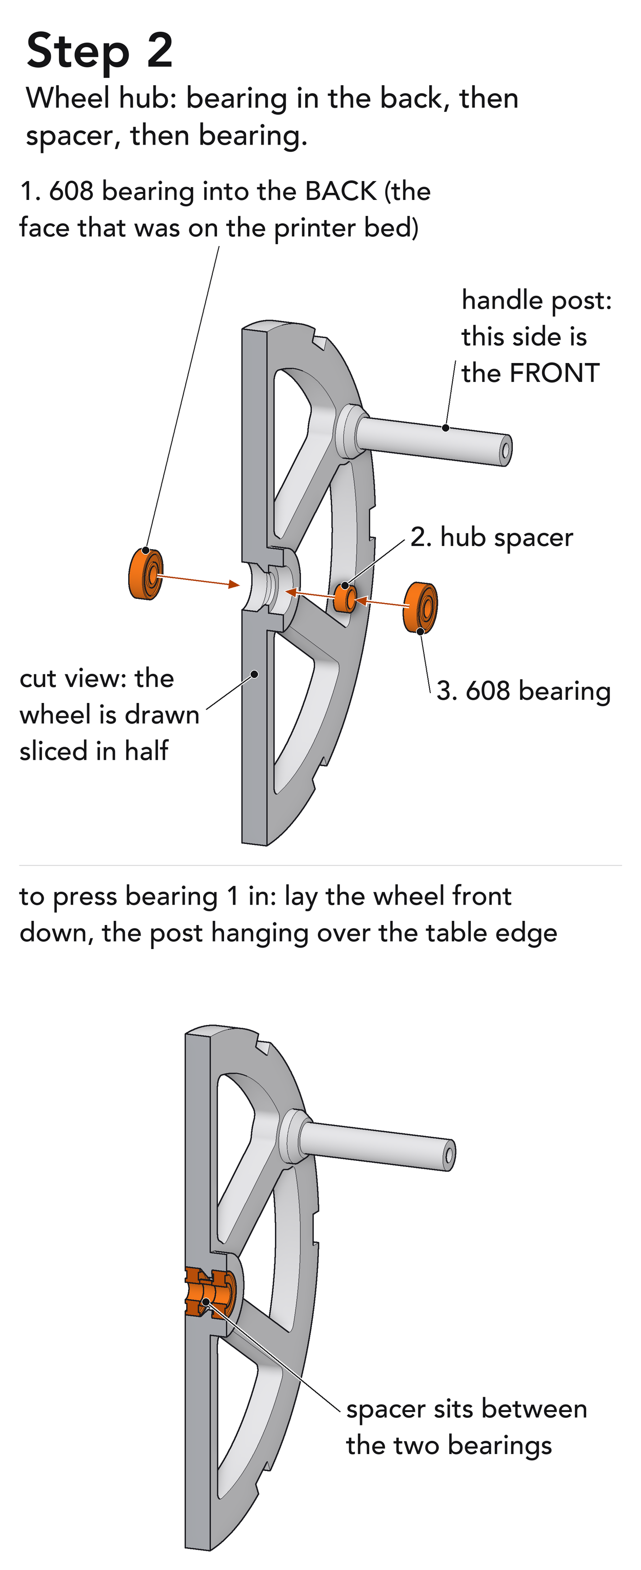
assembly/phone/step_02_phone.png
