Pai-88/crank-charger/assembly/phone/step_03_phone.png

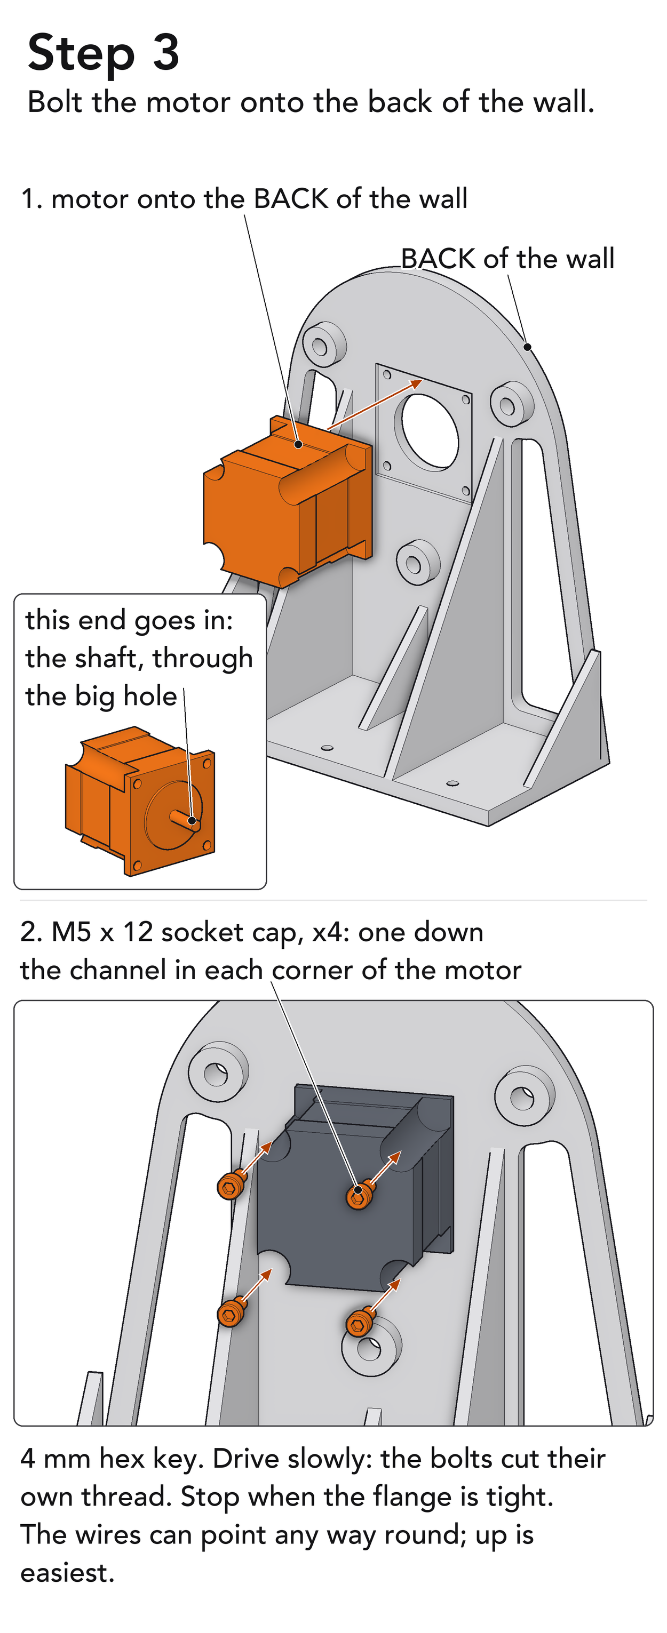
assembly/phone/step_03_phone.png
