Pai-88/crank-charger/assembly/phone/step_04_phone.png

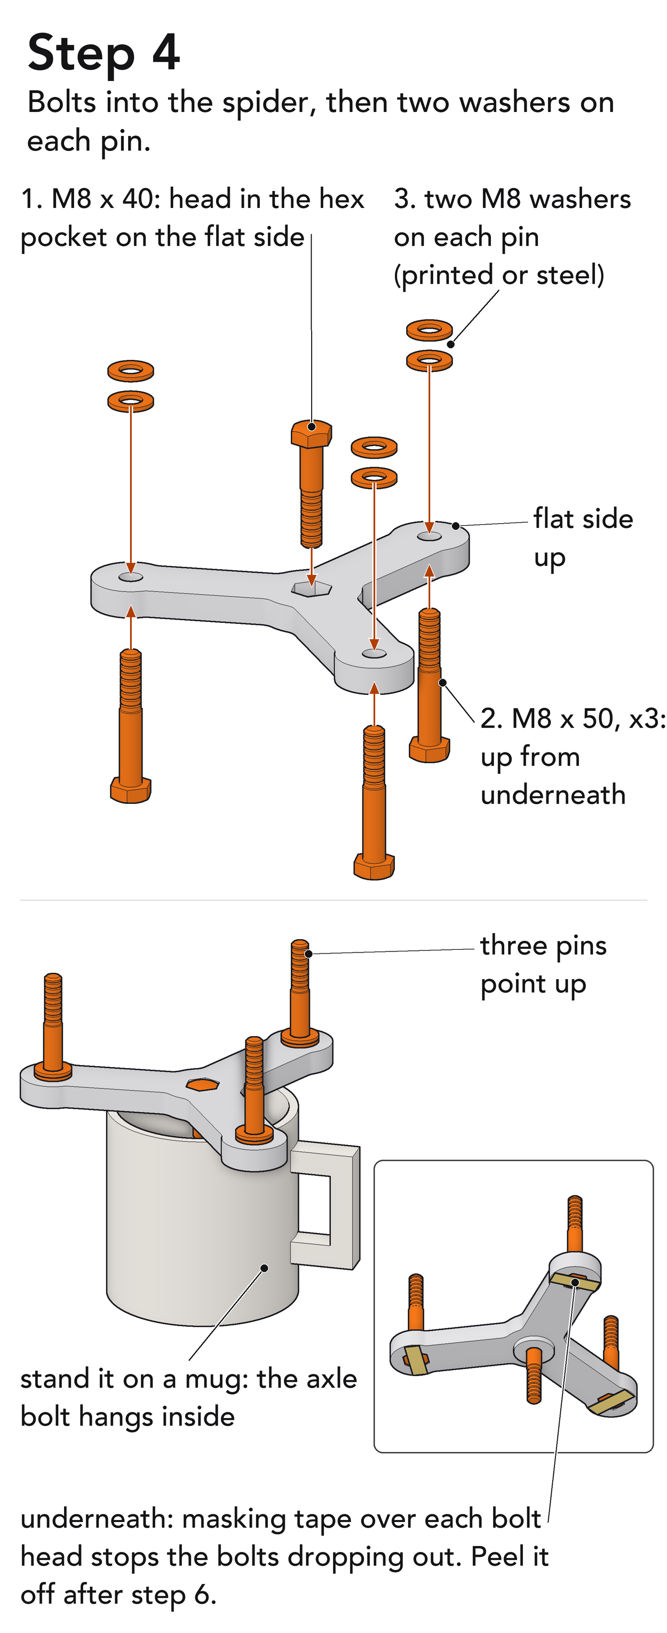
assembly/phone/step_04_phone.png
