Pai-88/crank-charger/assembly/phone/step_05_phone.png

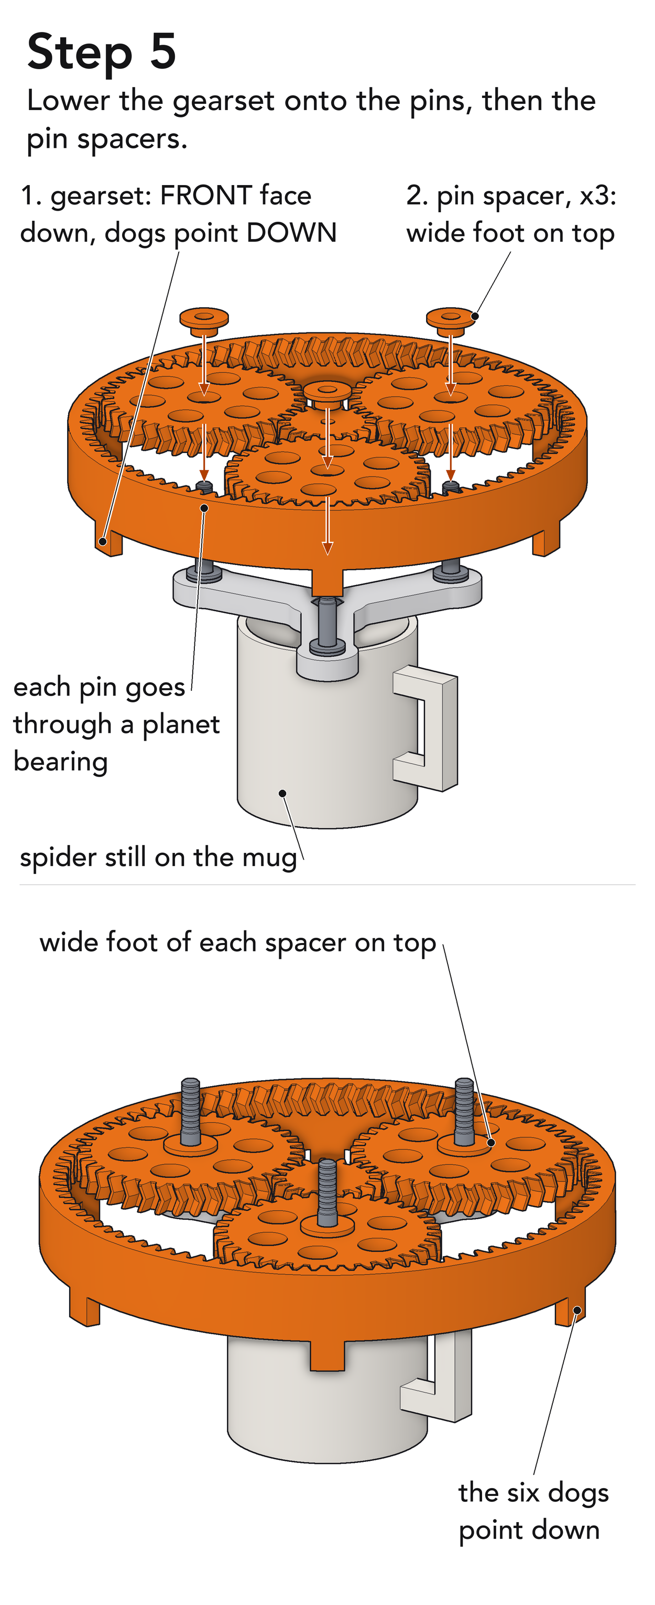
assembly/phone/step_05_phone.png
