Pai-88/crank-charger/assembly/phone/step_06a_phone.png

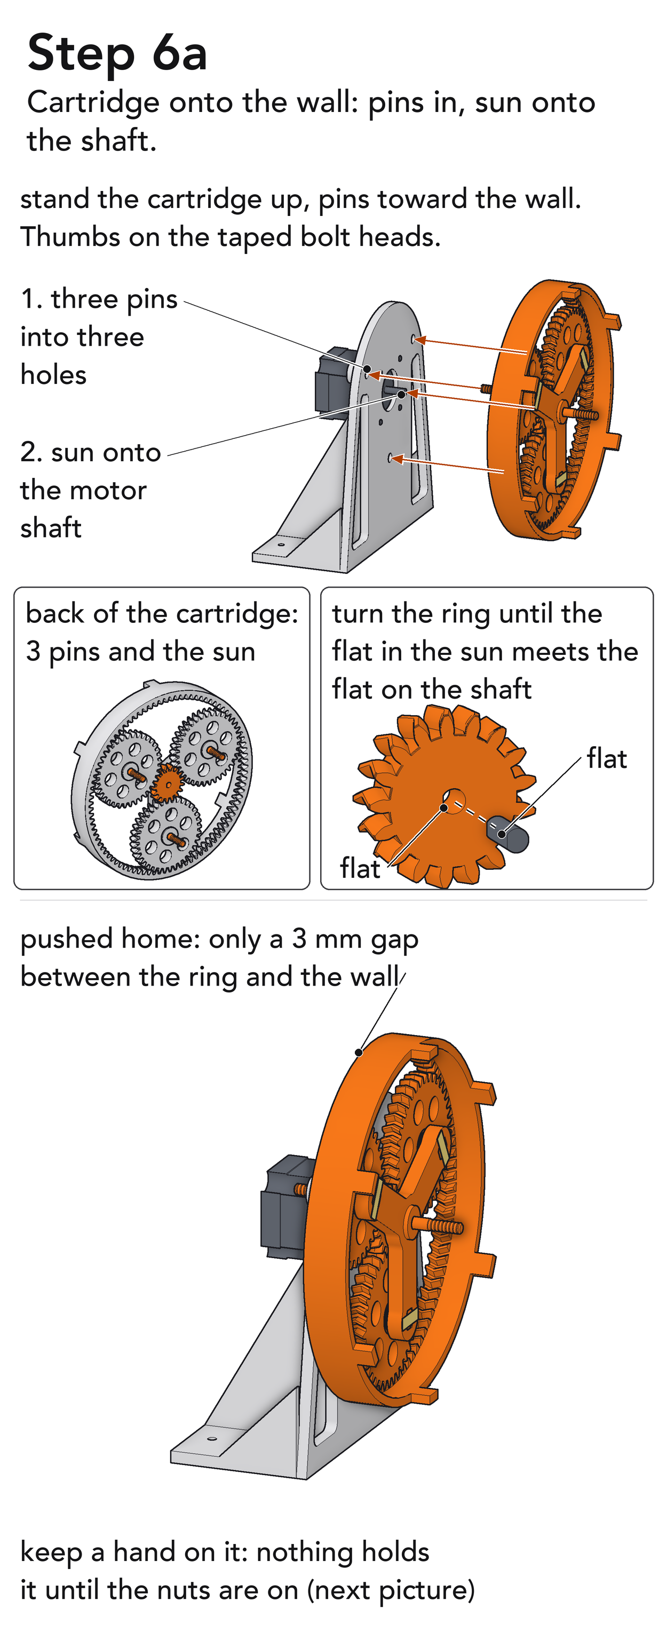
assembly/phone/step_06a_phone.png
