Pai-88/crank-charger/assembly/phone/step_06b_phone.png

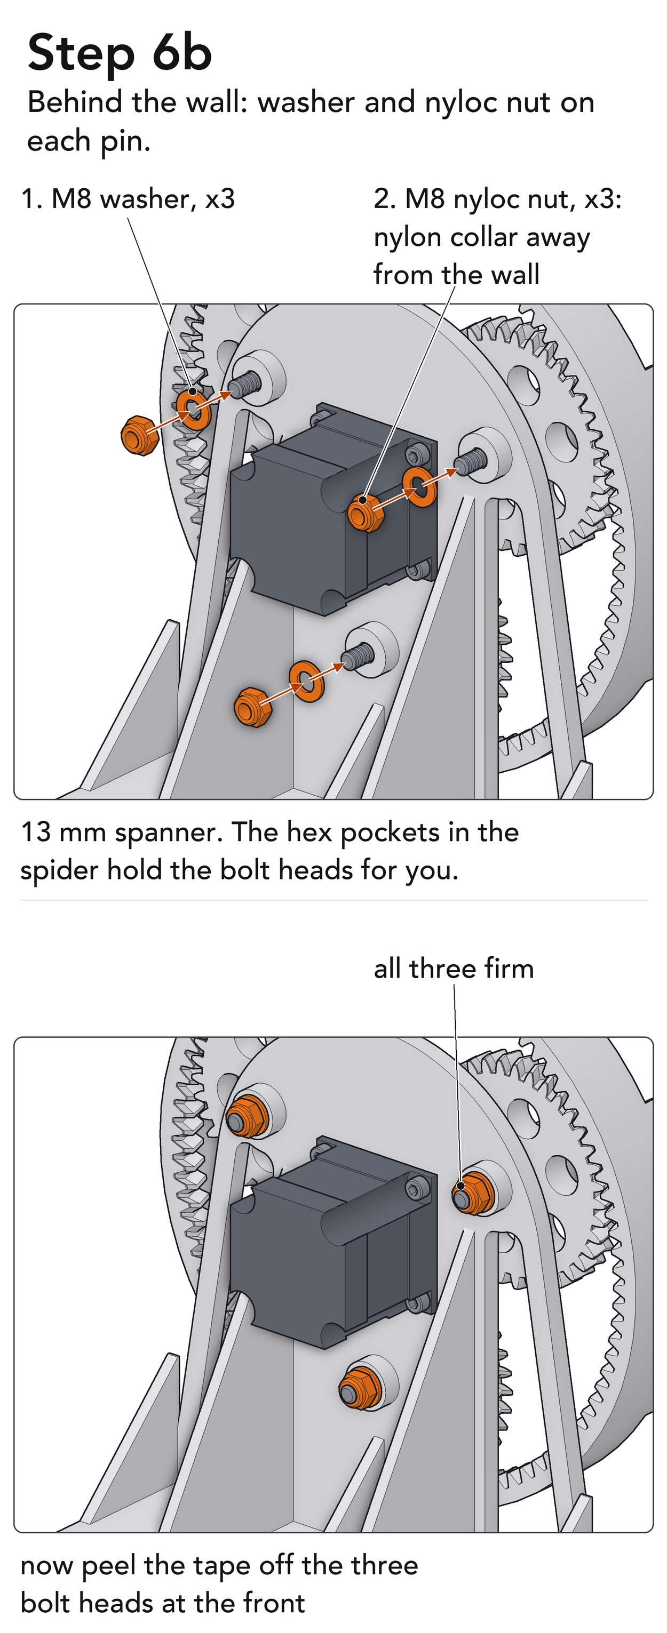
assembly/phone/step_06b_phone.png
