Pai-88/crank-charger/assembly/phone/step_07_phone.png

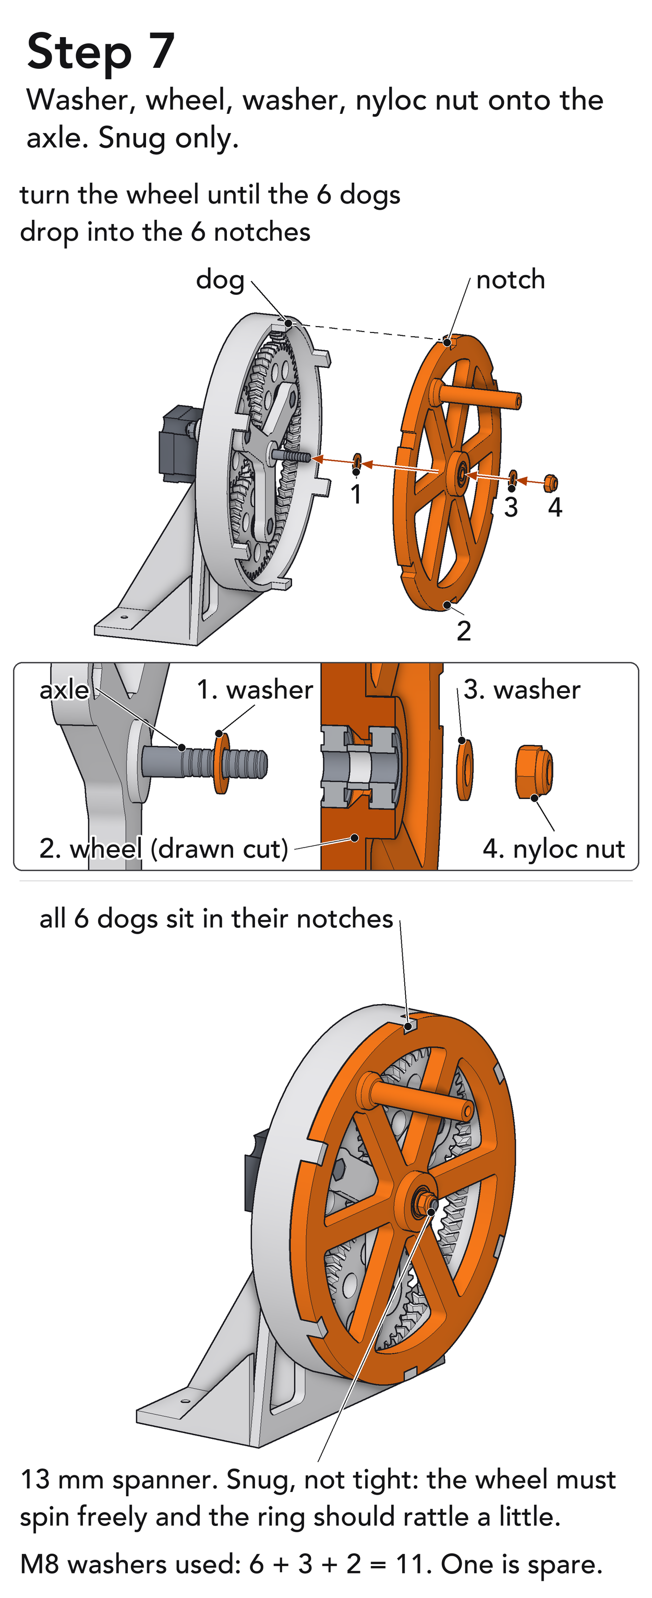
assembly/phone/step_07_phone.png
