Pai-88/crank-charger/assembly/phone/step_08_phone.png

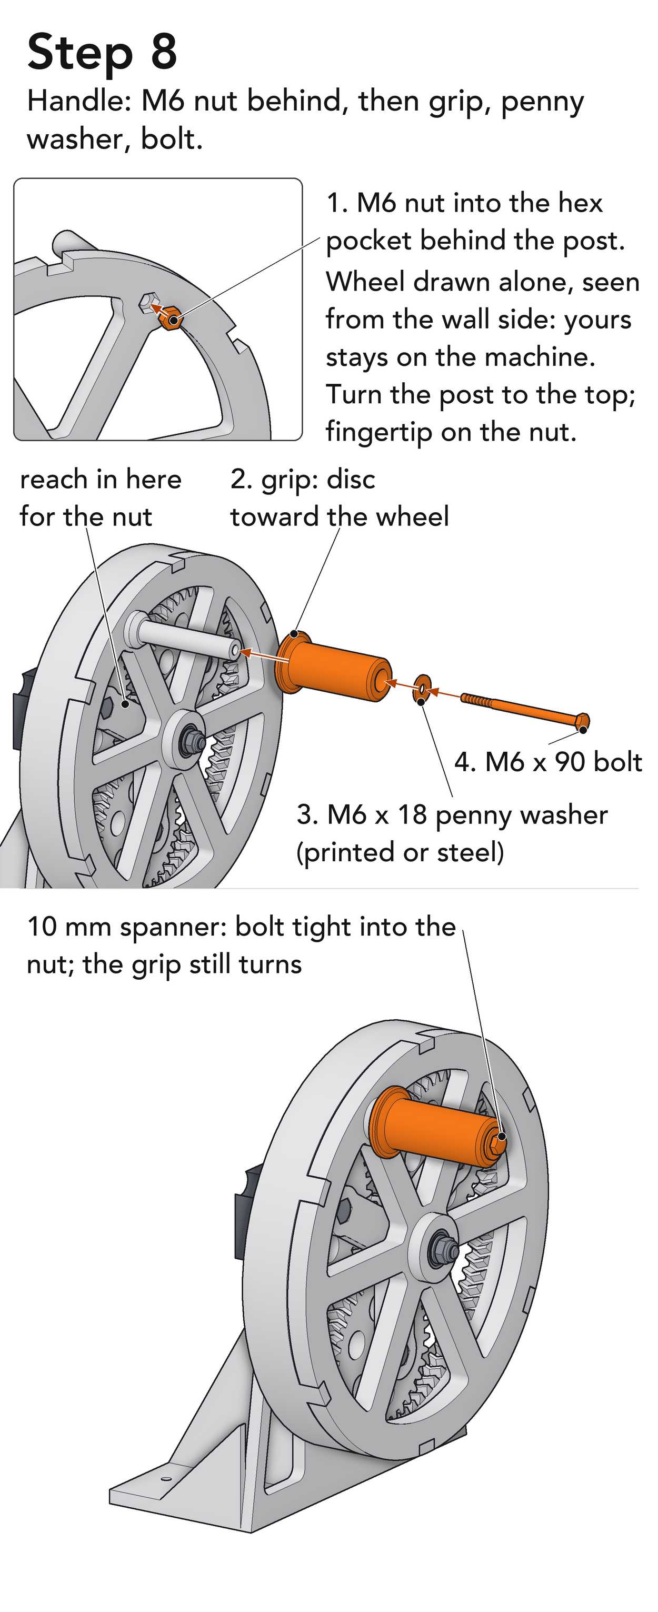
assembly/phone/step_08_phone.png
