Pai-88/crank-charger/assembly/phone/step_09_phone.png

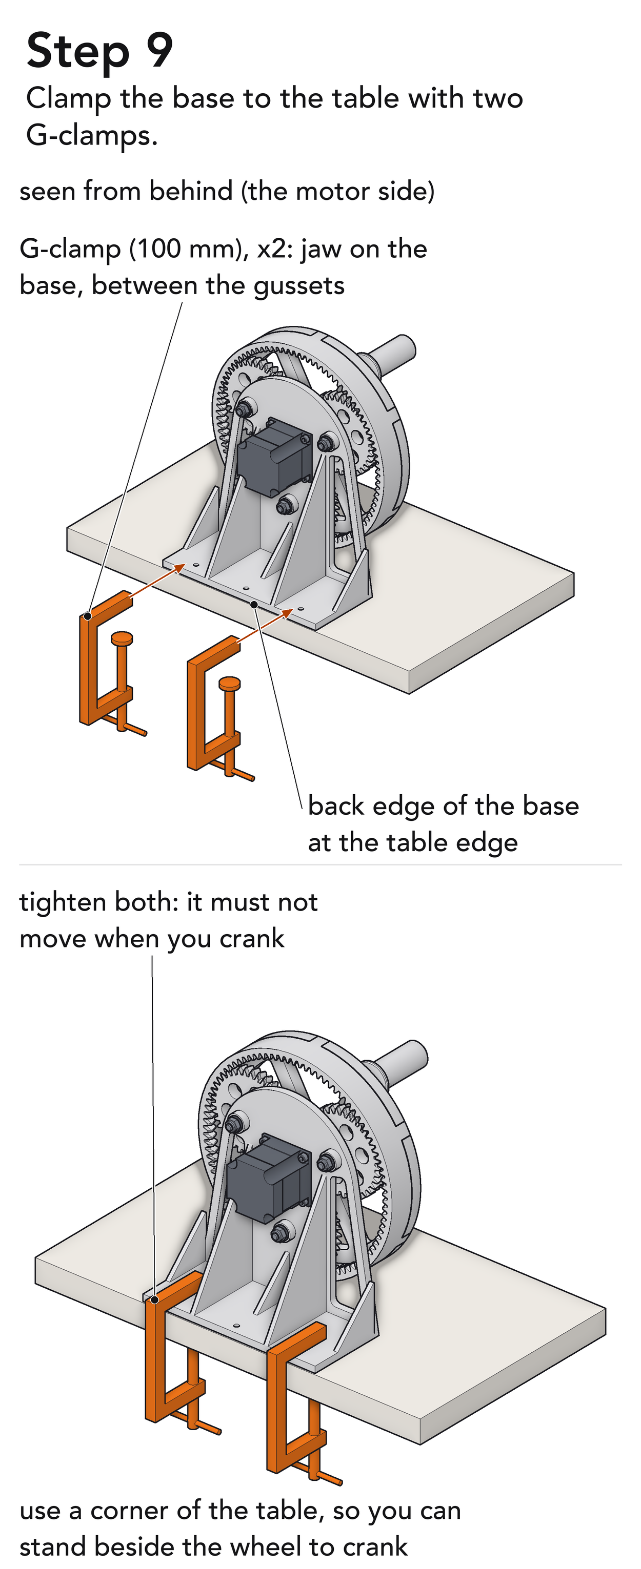
assembly/phone/step_09_phone.png
