Pai-88/crank-charger/assembly/step_01.png

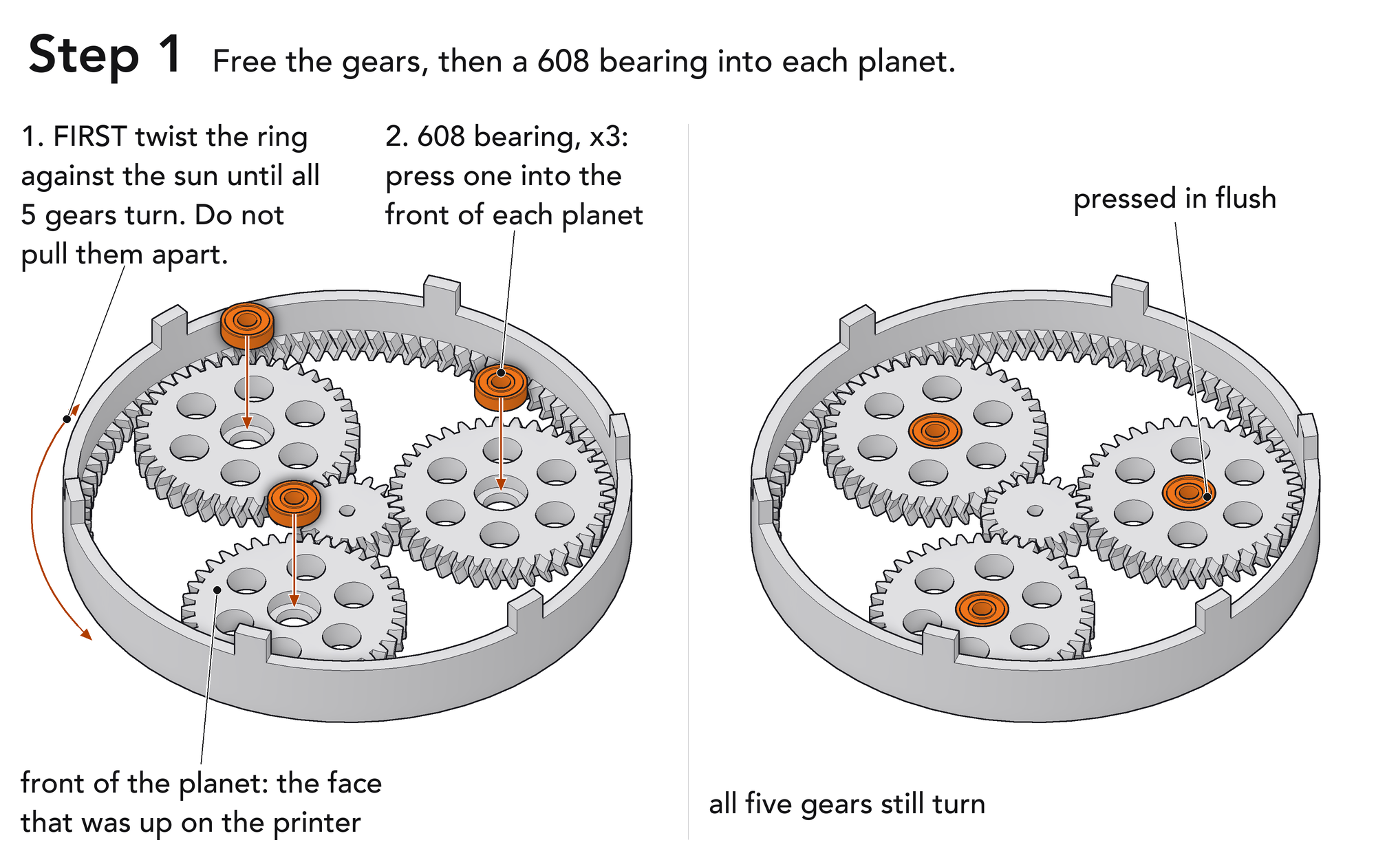
assembly/step_01.png
