Pai-88/crank-charger/assembly/step_02.png

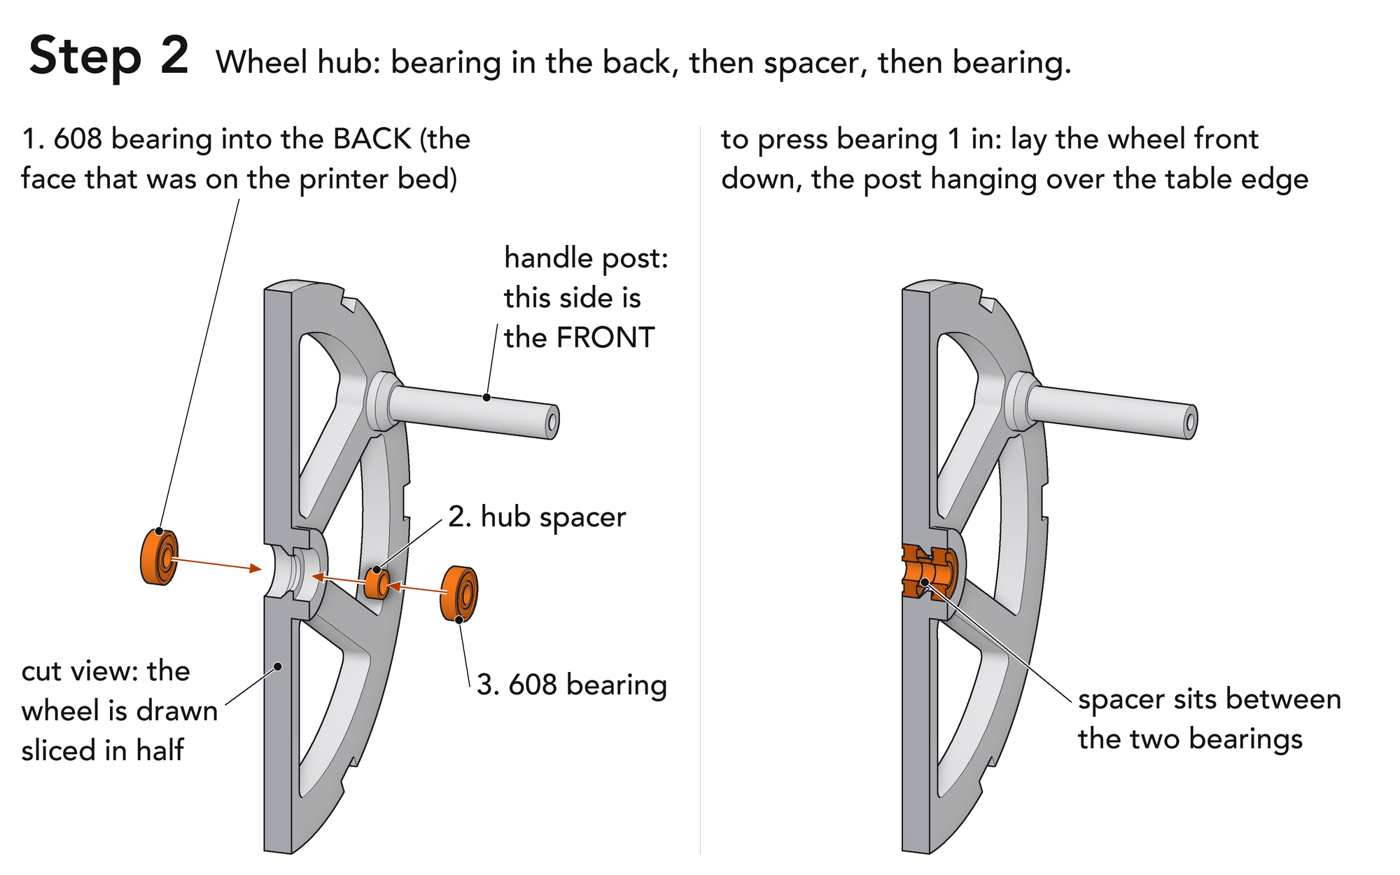
assembly/step_02.png
