Pai-88/crank-charger/assembly/step_03.png

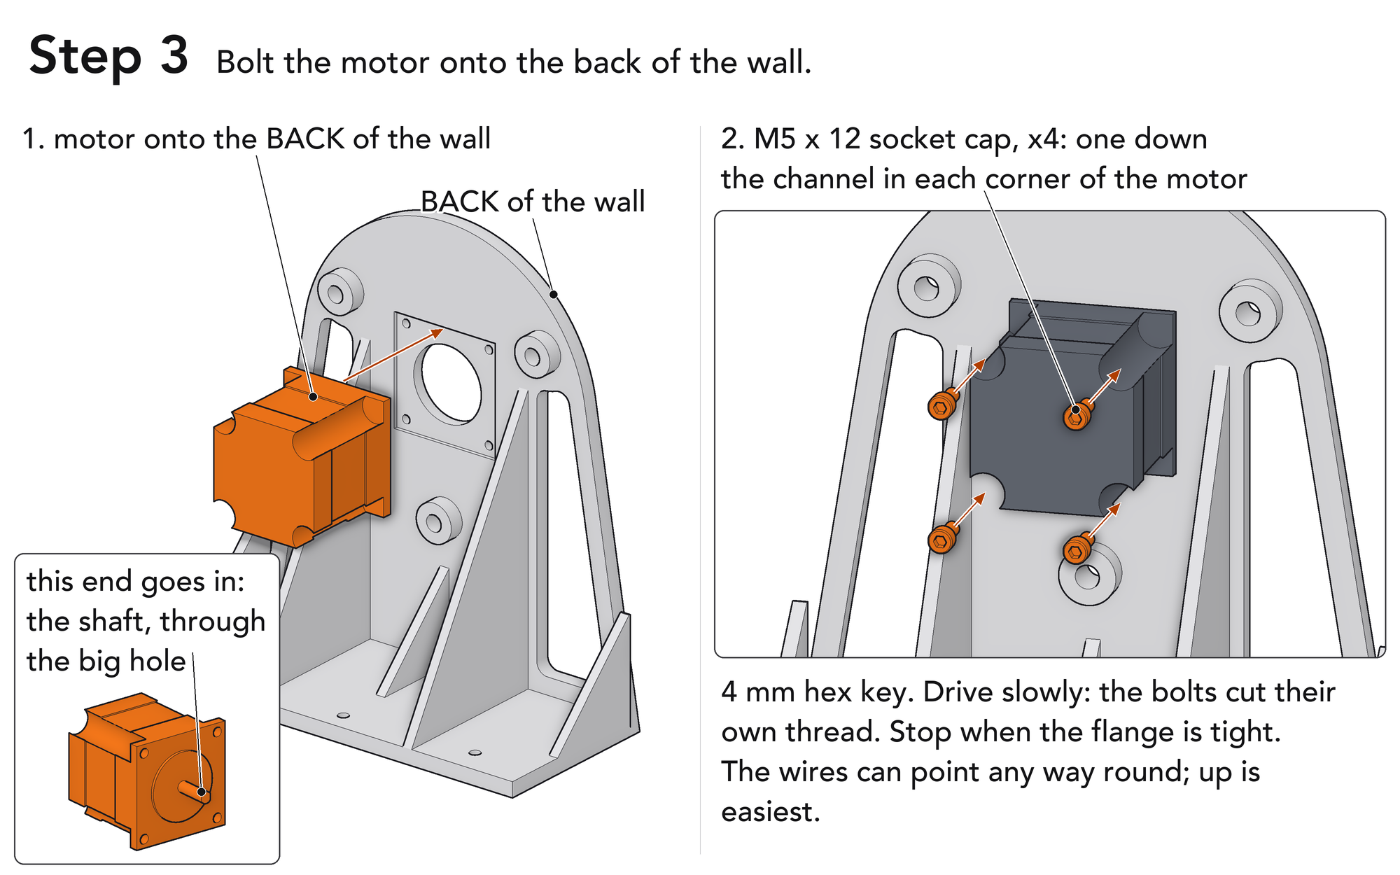
assembly/step_03.png
