Pai-88/crank-charger/assembly/step_04.png

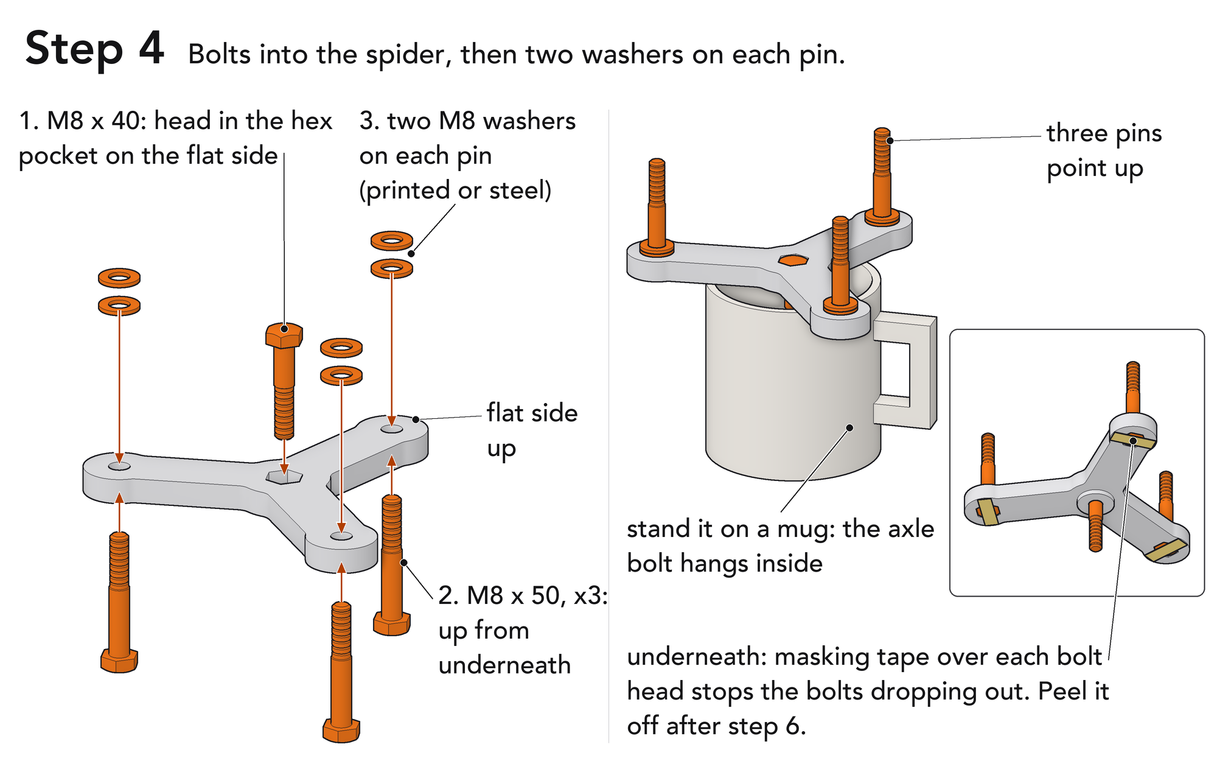
assembly/step_04.png
