Pai-88/crank-charger/assembly/step_05.png

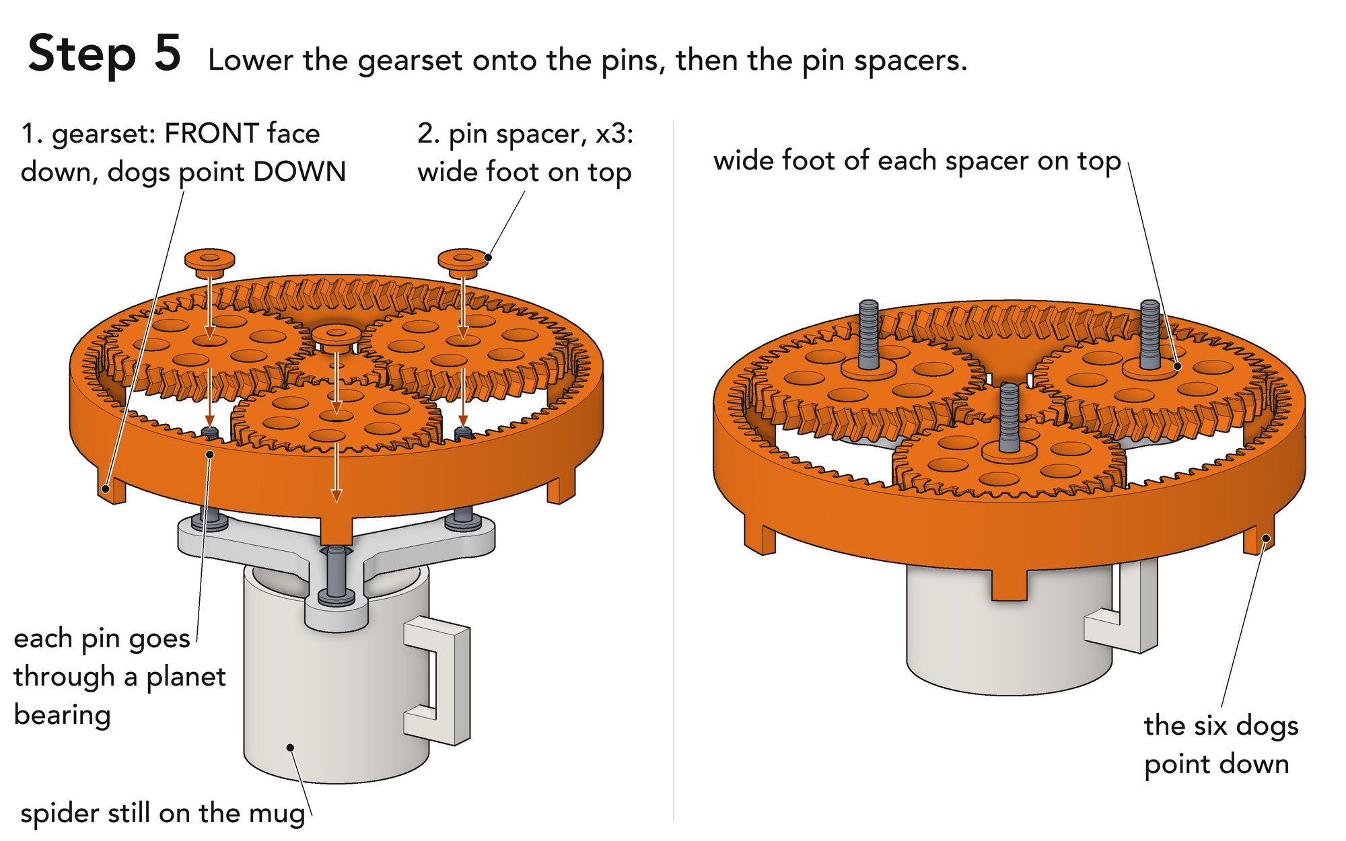
assembly/step_05.png
