Pai-88/crank-charger/assembly/step_06a.png

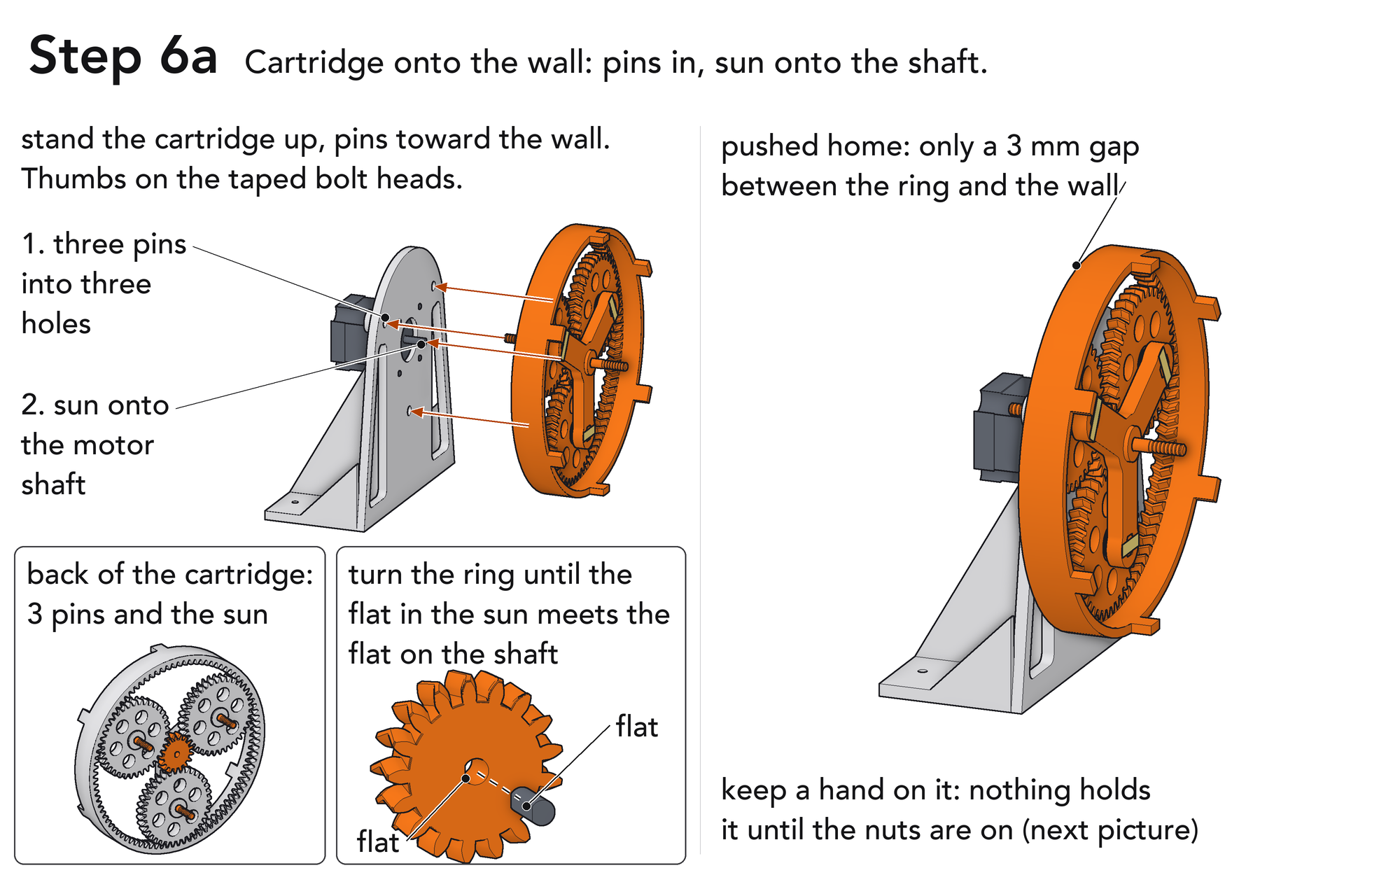
assembly/step_06a.png
