Pai-88/crank-charger/assembly/step_06b.png

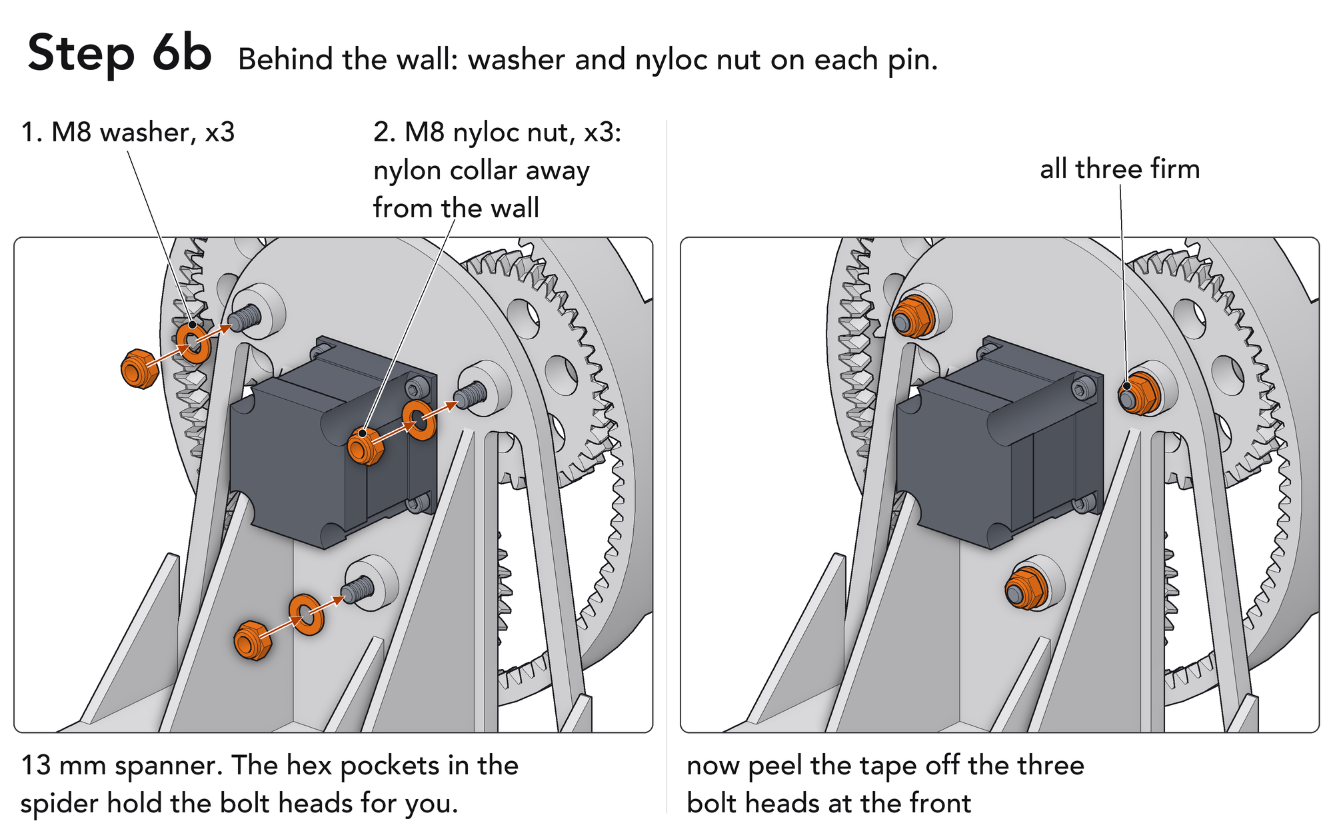
assembly/step_06b.png
