Pai-88/crank-charger/assembly/step_07.png

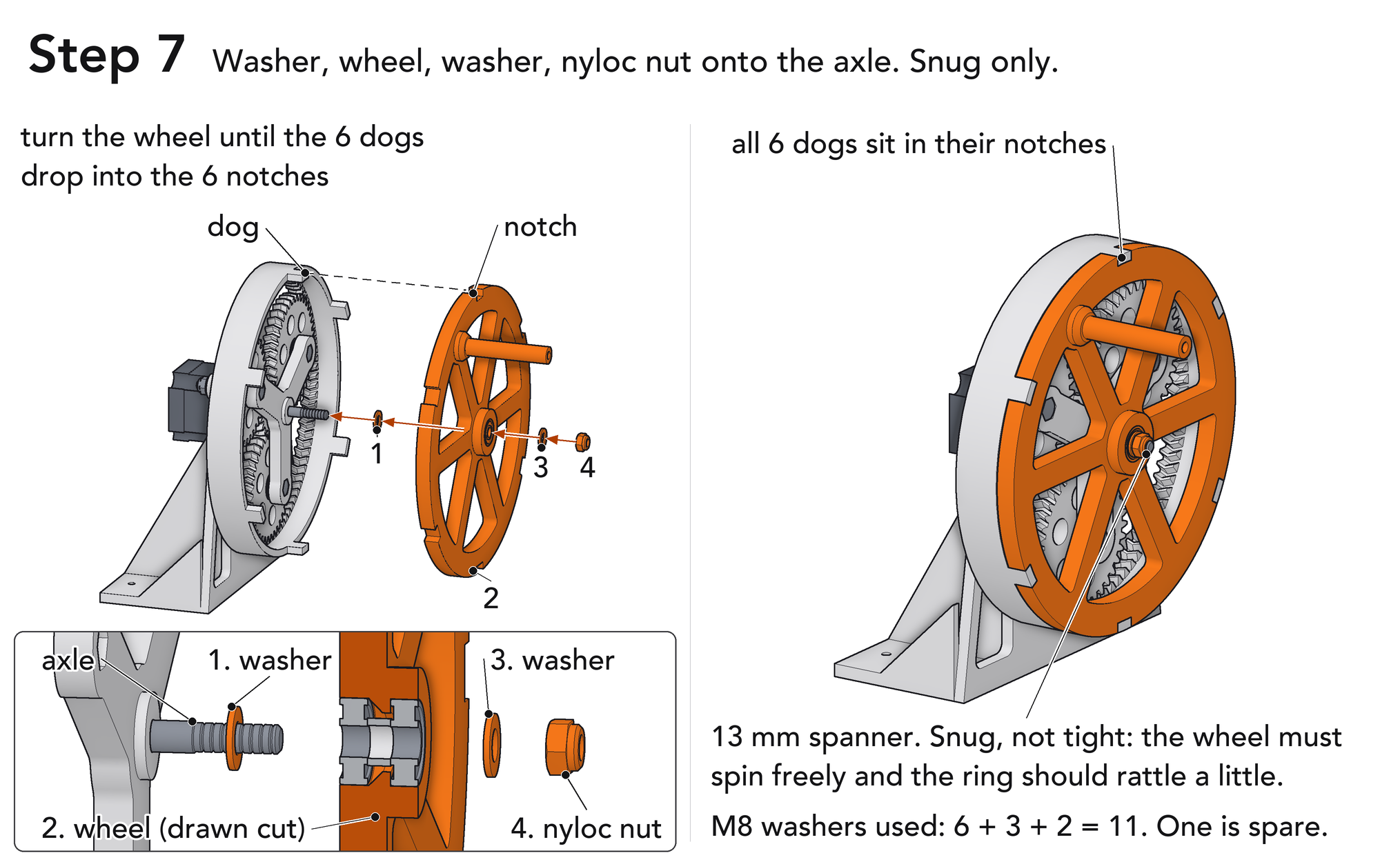
assembly/step_07.png
