Pai-88/crank-charger/assembly/step_08.png

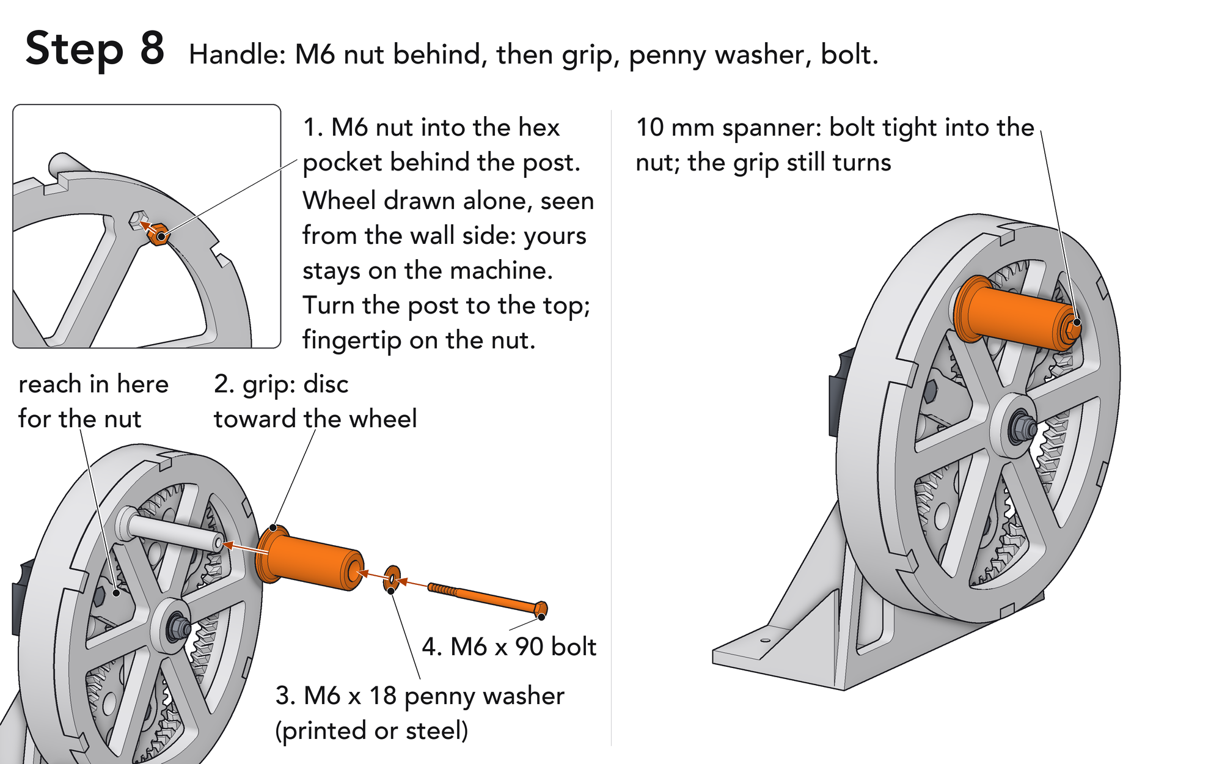
assembly/step_08.png
