Pai-88/crank-charger/assembly/step_09.png

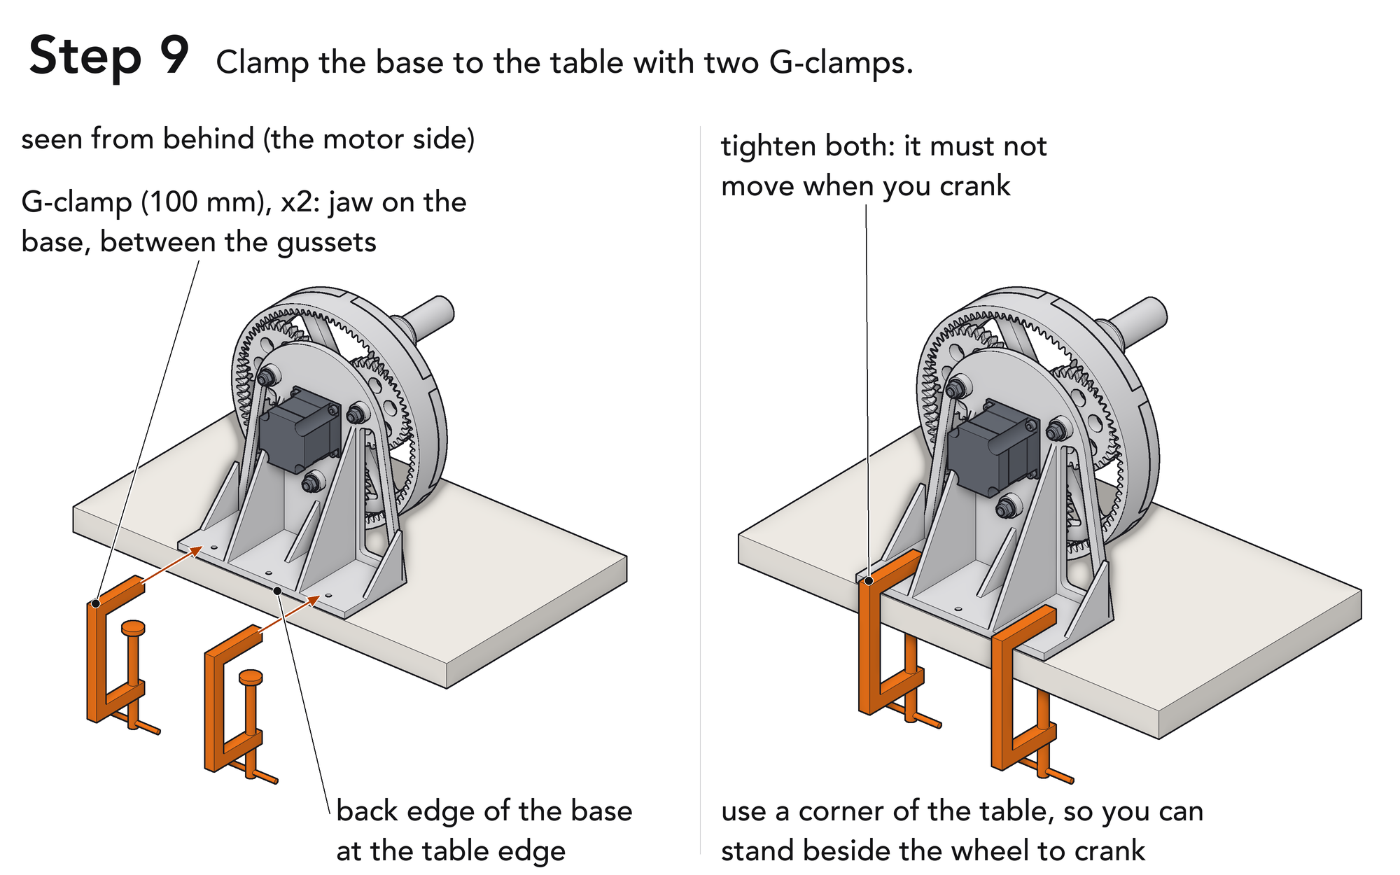
assembly/step_09.png
