Pai-88/crank-charger/video/_test/9x16_f0390.png

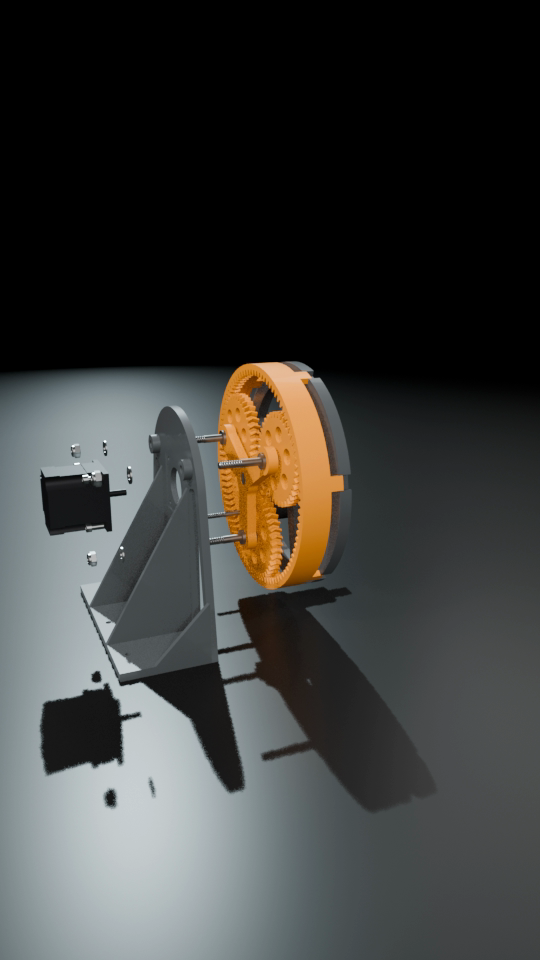
video/_test/9x16_f0390.png
