Pai-88/crank-charger/video/_test/elec9x16_f0270.png

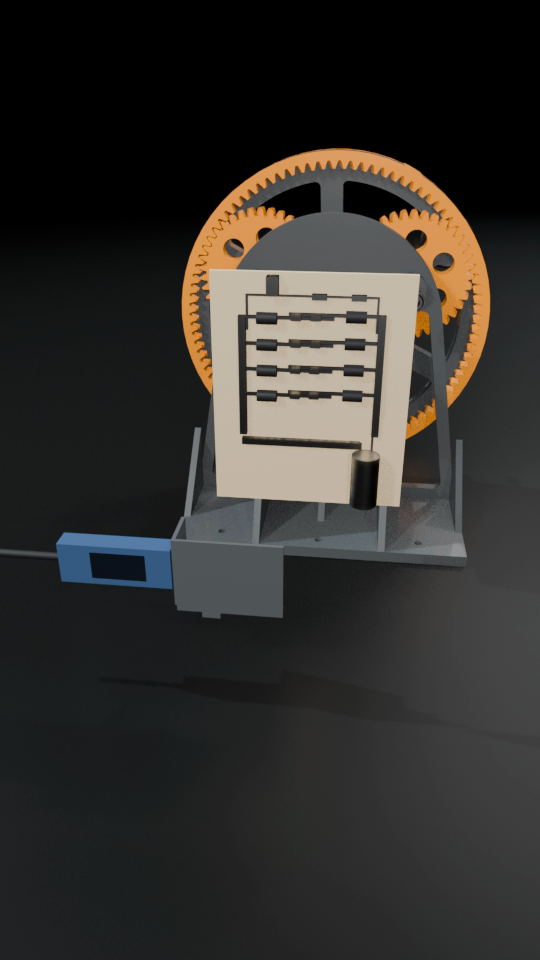
video/_test/elec9x16_f0270.png
